JohanLink/Ball-Balancing-PID-System/README.md

# Ball-Balancing-PID-System

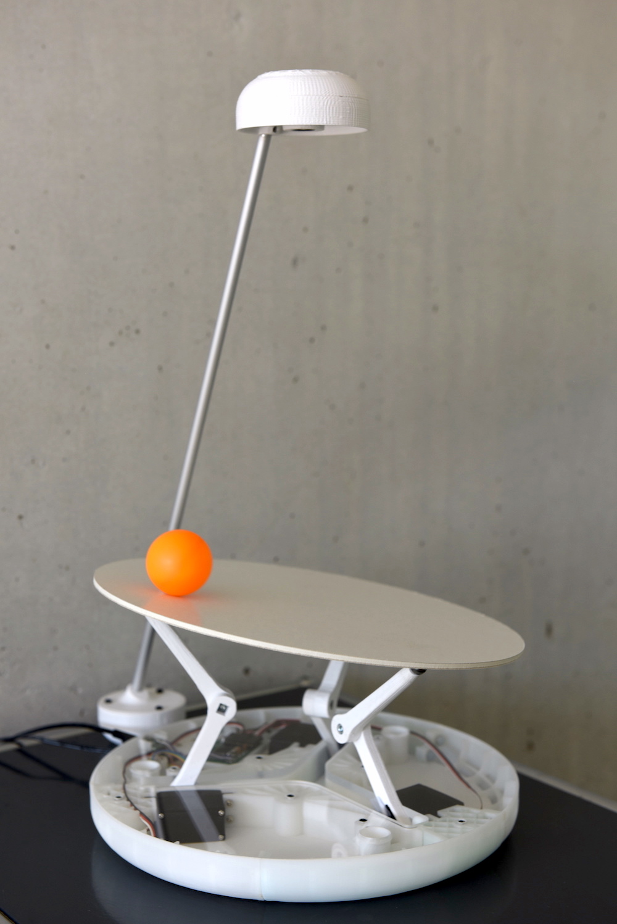
[picture p1: images/DSC_4337.JPG]


license : https://creativecommons.org/licenses/by-nc-sa/4.0/
