JohanLink/Ball-Balancing-PID-System/TM_SJF_version.pdf

Gymnase de Burier

Johan Link

3M5

# Système de stabilisation PID

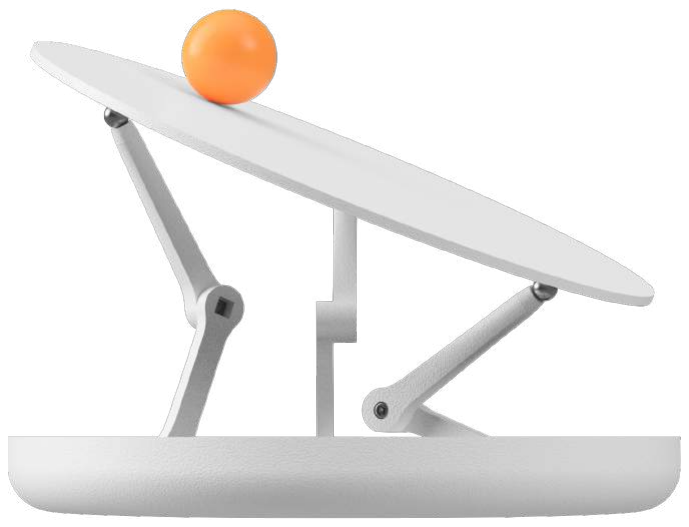
[picture p2: figure]

La Tour-de-Peilz, le 13 février 2020 | Maître répondant : Alain Salanon

## Résumé du travail de maturité

Ce travail consiste en la réalisation d’un système permettant de faire tenir une balle en équilibre sur un plateau qui a la possibilité de s’incliner sur deux axes pour annuler les mouvements de la balle. En d’autres termes, si on lance une balle sur ce plateau, ce dernier s’inclinera pour l’empêcher de tomber et il positionnera la balle en son centre.

Partie matérielle

Le système est composé de deux parties bien distinctes : une base qui contient trois moteurs avec leurs bras sur lesquels se trouve le plateau et un support qui maintient une caméra au-dessus du plateau. La base qui contient les moteurs est une structure en plastique de forme circulaire et de même dimension que le plateau. Cette structure est composée de plusieurs pièces en plastique qui ont été modélisées dans un logiciel puis fabriquées à l’aide d’une imprimante 3D.

Circuit électronique

La base qui contient les moteurs comprend également un circuit imprimé qui permet de contrôler les moteurs et de communiquer avec un ordinateur. J’ai conçu ce circuit spécialement pour ce projet. Je l’ai dessiné à l’aide d’un logiciel, puis il a été fabriqué en Chine. Le circuit contient un microcontrôleur similaire à celui de certaines cartes Arduino, par conséquent j’ai pu programmer mon propre circuit électronique à l’aide de l’environnement Arduino.

Programmation de l’ensemble

Le système fonctionne en trois temps : premièrement, la caméra prend une photo du plateau et de la balle et la transmet à un ordinateur, ensuite un programme Python analyse l’image pour détecter la position et la vitesse de la balle et en déduit que le plateau doit s’incliner d’un certain angle pour annuler les mouvements de la balle. Pour finir, le circuit imprimé fait bouger les moteurs en fonction des informations reçues par l’ordinateur. Le programme Python est la partie la plus importante du système car il traite les images reçues par la caméra, les analyse, puis en déduit à l’aide d’un régulateur PID l’inclinaison qu’il faut donner au plateau.

Utilisation d’un régulateur PID

Le régulateur PID est un système permettant de contrôler la position de la balle. En prenant en compte plusieurs facteurs comme la position et la vitesse de la balle, on peut connaître avec précision l’inclinaison qu’il faut donner au plateau pour que la balle se stabilise à une position voulue.

## Remerciements

Je souhaite remercier M. Salanon de m’avoir suivi tout au long de ce TM et pour la relecture de mon travail. Je remercie également M. Bonnet pour m’avoir guidé dans l’amélioration de ce travail.

## Table des matières

1 Introduction | 5
2 Etat de l’art : robotique parallèle | 7
3 Conception de la partie mécanique | 10
4 Résolution des équations à l’aide de Python | 18
5 Conception du circuit imprimé | 21
6 Fonctionnement d’un régulateur PID | 26
7 Mise en place du régulateur PID dans le programme Python | 29

2

8 Utilisation de OpenCV avec Python | 35
9 L’interface graphique | 37
10 Le code Arduino | 39

### 11 Analyse des performances du système selon les coefficients P, I

et D | 40

11.3 Dernière expérience : analyse des coefficients P et D lorsque la

12 Discussion des trois expériences | 51
13 Faiblesses du système | 53
13.4 Effet néfaste de la rotation du plateau sur la vitesse de la balle . | 57
14 Conclusion | 58
Bibliographie | 59

3

Annexes | 62

4

## 1 Introduction

### 1.1 Motivations

L’électronique, la programmation et l’informatique de façon générale sont des domaines qui m’intéressent depuis longtemps, c’est pourquoi j’ai souhaité réaliser un travail de maturité rassemblant toutes ces disciplines afin d’approfondir mes connaissances. J’ai toujours voulu savoir comment les objets ou les machines qui nous entourent fonctionnent c’est pourquoi j’ai l’habitude d’en démonter pour mieux comprendre leur mécanisme. J’ai commencé à m’intéresser à l’électronique il y a de nombreuses années, j’ai commencé par la fabrication de simples circuits électriques puis, plus tard, je me suis également intéressé à la programmation. Il y a quelques années j’ai découvert l’existence des cartes Arduino qui m’ont permis de réaliser des projets de plus en plus intéressants en me permettant de travailler à la fois du côté logiciel et matériel. Les cartes Arduino s’utilisent de manière très intuitive et sont entièrement open-source, de plus une énorme quantité de documentation est présente sur internet. Ce travail de maturité est donc l’occasion de faire un projet concret qui contient une partie hardware et une partie software.

### 1.2 Présentation du projet

Mon projet consiste en la réalisation d’un système permettant de faire tenir en équilibre une balle sur un plateau. Des servomoteurs permettront au plateau de s’orienter avec un certain angle d’inclinaison pour contrebalancer les mouvements de la bille. Une caméra placée au-dessus du dispositif transmettra en direct des images du plateau à un ordinateur qui sera chargé de les analyser pour en tirer des conclusions telles que la position de la bille, sa vitesse et son accélération. Un programme informatique sera alors chargé de traiter ces données et de les transmettre par USB à l’Arduino qui contrôlera la rotation de chaque servomoteur indépendamment. Le plateau bougera en conséquence des déplacements de la bille, même si cette dernière est déstabilisée par du vent ou une force quelconque, l’Arduino inclinera le plateau pour qu’elle ne tombe jamais.
Ce projet me permettra de concevoir un système contenant une partie mécanique et électronique, je serai également mené à coder un programme capable de traiter des images et d’en déduire la position d’un objet d’une couleur définie. Dans un premier temps je vais construire et étudier les différents mécanismes qui permettront de faire bouger le plateau. Ensuite je devrai dessiner et fabriquer un circuit électronique contenant un microcontrôleur capable de communiquer avec l’ordinateur et capable de diriger les servomoteurs. Je finirai mon travail par la réalisation du programme qui traitera les images de la caméra et qui en déduira l’inclinaison du plateau nécessaire à l’équilibre de la bille.

5

### 1.3 Les cartes Arduino

Les cartes Arduino sont de petites cartes électroniques qui sont principalement composées d’un microcontrôleur autour duquel se trouve de nombreuses entrées et sorties qui permettent à la carte d’interagir avec différents composants électroniques ou quelconques systèmes extérieurs à la carte. Plusieurs modèles de cartes existent, la différence majeure qui les sépare est la puissance du microcontrôleur. Par exemple un microcontrôleur contenu dans un Arduino Mega contiendra une EEPROM d’une capacité de 4 kB alors qu’un Arduino Uno aura une EEPROM limitée à 1 kB. De plus les cartes plus puissantes ont également plus d’entrées et de sorties.
L’Arduino a été fondé en 2005 par un étudiant Italien, par la suite ce simple projet d’étudiant a révolutionné l’univers de l’électronique. Ces cartes permettent à n’importe quelle personne de concevoir un projet à moindre coût. Un Arduino Uno coûte environ 20 euros ce qui rend ces cartes accessibles. Mais l’avantage d’utiliser ces cartes open-source est d’avoir accès à une immense communauté de personnes publiant des tutoriels ou différents projets sur internet. De plus, Arduino fournit également un logiciel de programmation gratuit qui permet de programmer très simplement n’importe quelles cartes Arduino ou d’autres cartes avec un microcontrôleur similaire. En effet le logiciel Arduino peut également servir à programmer une carte d’une autre marque qu’Arduino ou encore une carte fabriquée par soi-même. C’est un exemple d’un des nombreux avantages que les logiciels open-source offrent.

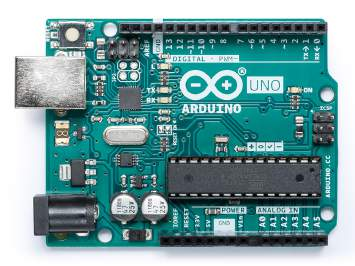
[picture p3: figure]

Figure 1 – Photo d’un Arduino Uno Source : https ://store.arduino.cc/arduino-uno-rev3

6

## 2 Etat de l’art : robotique parallèle

Un des éléments essentiel à mon travail de maturité est de trouver un moyen de manipuler une plateforme dans l’espace pour lui donner une orientation recherchée. Différents types de robots répondent déjà à des besoins proche de celui-ci mais ne sont pas toujours parfaitement adaptés à mon projet. Ces derniers font partie de la robotique parallèle : mécanisme en chaîne cinématique fermée dont l’organe terminal est relié à la base par plusieurs chaînes cinématiques indépendantes. ¹
La robotique parallèle à permis de créer des systèmes mécanique plus performant dans certaines applications que les robots sériels inventé plus tôt.

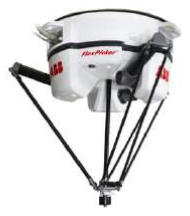
[picture p4: figure]
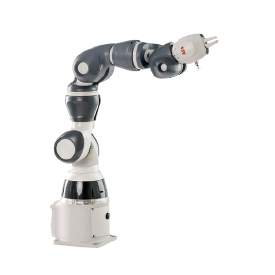
[picture p5: figure]

(a) Robot sériel | (b) Robot parallèle

Figure 2 – Comparaison entre un robot sériel et parallèle

### 2.1 Robot Delta

Inventé en 1985 par l’ingénieur Reymond Clavel à l’EPFL, le robot Delta (la figure 2b présente un exemple de robot delta) a révolutionné l’industrie. En effet ce système comporte un grand nombre d’avantages en comparaison avec les robots sériels, sa géométrie lui donne une grande rigidité tout en utilisant des matériaux légers et fins. Cette géométrie permet également des déplacements très rapides et précis. En général ce système comporte 3 degrés de liberté ce qui lui permet de soulever des objets pour les translater par exemple. Ces mouvements sont particulièrement adaptés à l’industrie où il faut souvent déplacer les objets fabriqués pour les ranger dans des boites par exemple. Par conséquent,

1. Définition de Jean-Pierre Merlet, Les Robots Parallèles, Paris, Hermes Science Publishing, 21 février 1997, 367 p. (ISBN 978-2866015992)
Source | de | la | figure | 2b | : | https | ://new.abb.com/products/robotics/fr/robots-
industriels/irb-360-flexpicker
Source de la figure 2a : https ://new.abb.com/products/robotics/de/industrieroboter/SAY

7

dans les robots delta, la plateforme mouvante se déplace toujours de manière parallèle à la plateforme sur laquelle les moteurs sont fixés (voir figure 3b).

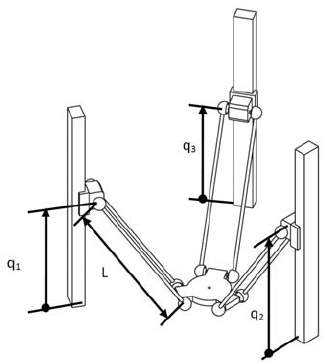
[picture p6: figure]
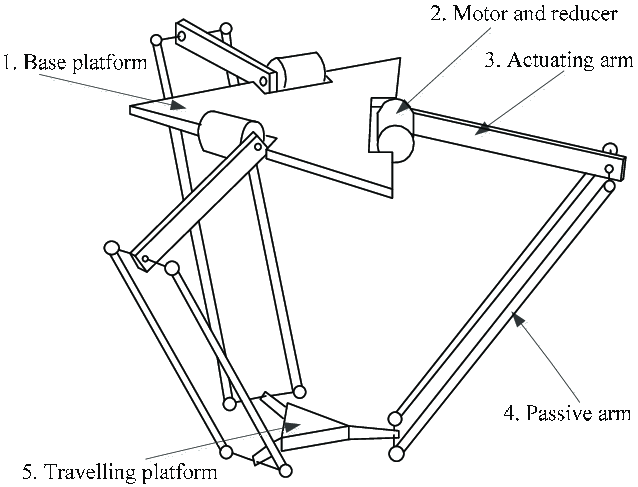
[picture p7: figure]

(a) Robot delta à actionneurs linéaires | (b) Robot delta à actionneurs rotatifs

Figure 3 – Comparaison entre des actionneurs linéaires et rotatifs dans un robot delta

Le robot delta est souvent muni d’actionneurs rotatifs, un des désavantages de ce système est que la plateforme mouvante du système ne peut pas se déplacer dans un très grand espace de travail. Cela ne pose aucun problème lorsque le robot doit juste déplacer de petits objets d’un tapis roulants à l’autre dans une usine par exemple. Cependant il faut parfois un système capable d’évoluer dans un plus grand espace de travail, on peut alors fixer les bras du robot delta directement sur des actionneurs linéaires (voir figure 3a). Ce système est parfois utilisé dans les imprimante 3D car il permet d’augmenter l’espace de travail du robot ce qui permet d’imprimer des pièces de grande taille.

### 2.2 Plateforme de Stewart

La plateforme de Stewart, inventée en 1965, est également un système qui fait partie de la robotique parallèle. Ce système était destiné à améliorer le réalisme des simulateurs de vols. Le mécanisme est composé d’une plateforme fixée sur six vérins par des articulations mobiles. Les vérins sont indépendants les uns des autres et servent à orienter la plateforme. Cette dernière dispose de six degrés de liberté (les trois coordonnées de translation et les angles de tangage, roulement et lacet). Fonctionnant avec six vérins, le système à la capacité de faire bouger des charges très lourdes cependant les vérins ont le désavantage d’être en général relativement lent. Il existe cependant des versions de la plateforme de

Source de la figure 3a : https ://www.researchgate.net/figure/DELTA-parallel-robot-withlinear-actuators_fig2_4356741
Source de la figure 3b : https ://www.researchgate.net/figure/Scheme-of-the-Deltarobot_fig3_303469087

8

Stewart utilisant des actionneurs rotatifs ce qui permet d’augmenter la vitesse des mouvements.

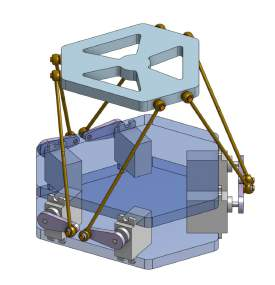
[picture p8: figure]

(a) Plateforme de Stewart à actionneurs rotatifs

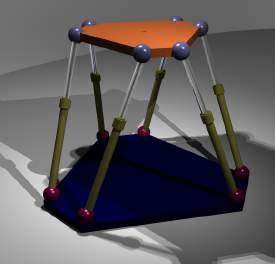
[picture p9: figure]

(b) Plateforme de Stewart à actionneurs linéaires

Figure 4 – Exemples de plateforme de Stewart

### 2.3 Conclusion

La robotique parallèle semble être une bonne solution pour ce travail de maturité, en effet nous avons vu que ce type de robotique permet de créer des mécanismes dont la géométrie comporte de nombreux avantages. La plateforme de Stewart et le robot delta permettent tous les deux de déplacer une plateforme avec précision et à grande vitesse. Les pièces mécaniques utilisées étant relativement simples et légères, elles n’ont pas une grande inertie ce qui permet de leur faire subir de grandes accélérations sans problèmes. Malgré les avantages vus précédemment, ces systèmes ne sont pas parfaitement adaptés pour satisfaire les exigences de ce travail. Effectivement il est question d’orienter un plateau selon les angles de roulis et de tangage, or un robot delta permet uniquement de translater sa plateforme dans l’espace sans pouvoir lui faire subir des rotations. Quant à elle, la plateforme de Stewart permet à sa plateforme de se translater dans l’espace mais également de subir des rotations selon les angles de roulis, tangage et lacet. Par conséquent la plateforme de Stewart remplis les exigences de roulis et tangage mais offre également beaucoup d’autres degrés de liberté qui ne sont pas nécessaires dans l’élaboration de ce travail. Il faudra alors trouver un moyen de simplifier la géométrie d’une plateforme de Stewart tout en prenant soins de rester dans la robotique parallèle pour conserver ses propriétés mécaniques intéressantes.

Source de la figure 4a : https ://github.com/NicHub/stewart-platform-esp32 Source de la figure 4b : https ://fr.m.wikipedia.org/wiki/Robot_parallèle

9

## 3 Conception de la partie mécanique

### 3.1 Fonctionnement général du système mécanique

Le plateau sur lequel reposera la bille devra être capable de s’orienter sur deux axes et devra pouvoir s’incliner de 35◦ au maximum. Étant donné que la plate-forme doit se mouvoir sur deux axes j’ai rapidement commencé à réfléchir à un système comportant deux moteurs. Cependant, après réflexion je me suis rendu compte qu’il était plus simple d’utiliser trois moteurs (fig.5). L’ajout d’un moteur permet également de rajouter un degré de liberté au plateau, en effet avec trois moteurs la plate-forme peut s’incliner sur deux axes et peut également bouger de façon verticale, mais ce degré de liberté ne sera pas utilisé dans ce projet. À présent nous savons que le système comprendra trois moteurs placés à 120◦
l’un de l’autre et que le mouvement de rotation de ces derniers devra entraîner l’inclinaison du plateau. Pour ce faire, chaque moteur mettra en rotation un bras qui sera composé de deux parties reliées entre elles par une articulation (fig.6). Une bille métallique sera fixée à l’extrémité du bras de chaque moteur et cette bille fera office de rotule entre le bout du bras et le plateau situé en dessus.

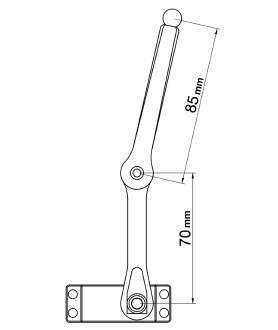
[picture p10: figure]
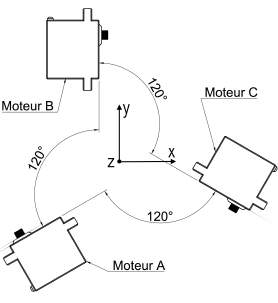
[picture p11: figure]

Figure 5 – Disposition des moteurs | Figure 6 – Bras d’un moteur

### 3.2 Conceptualisation géométrique du problème

Comme dit précédemment, le dispositif comporte trois moteurs, il faut donc trouver un moyen de connaître l’angle du bras de chaque moteur en fonction d’une inclinaison donnée du plateau. Les moteurs ont une position fixe, chaque bras se déplace dans un plan vertical et la distance entre le bout de chaque bras est constante. Dans un premier temps j’ai commencé à réaliser différents calculs permettant de mettre en relation les différentes contraintes du problème. J’ai

10 également établi un système permettant de définir la position du plateau en fonction de deux angles. Pour ce faire j’ai ajouté dans mes calculs un vecteur ~v (fig.7) de norme 1 qui est toujours perpendiculaire au plateau et dont l’origine correspond au centre du plateau. L’orientation de ce vecteur est défini par les angles α et β.

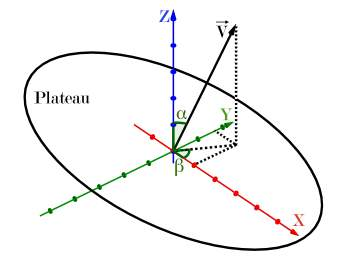
[picture p12: figure]

Figure 7 – Vecteur ~v perpendiculaire au plateau

Après avoir réalisé plusieurs calculs ²
j’ai pu établir des équations qui permettent de déterminer la position de chaque bille située sur le bout des bras en fonction d’une inclinaison connue du plateau. Après avoir trouvé la position dans l’espace d’une bille on doit encore trouver l’angle du moteur qui permet de positionner le bout du bras avec la bille au bon endroit. L’équation ³ suivante
permet de calculer l’angle θ que le bras doit avoir par rapport à l’horizontale :

(L − r cos θ −

p
X² + Y ²)

2 + (r sin θ − Z)

2 = l

2
(1)

où L est la distance entre l’arbre d’un moteur et l’origine (fig.5), r est la longueur de la première portion du bras de chaque moteur et l est la longueur du deuxième segment du bras (segment sur lequel est attaché la bille). X,Y et Z sont les coordonnées ⁴ de la bille qui ont été calculées précédemment. L’équation (1) doit donc être utilisée individuellement pour chaque moteur, en d’autres termes on calcule d’abord la position de la bille du bras du moteur A et on utilise l’équation (1) pour déterminer l’angle du moteur A, ensuite on refait les mêmes calculs pour les moteurs B et C.

### 3.3 Choix des moteurs

Comme vu précédemment, trois bras composés de deux parties chacun devront maintenir et faire bouger le plateau situé en dessus d’eux. Il est donc

2. Ces calculs sont décrits aux pages 94 et 95.
3. L’équation 1 est décrite plus précisément à la page 96.
4. Le repère orthonormé de ces coordonnées se trouve sur le plan qui contient les trois moteurs et se trouve à équidistance de ces derniers. (figure 5, page 10)

11 évident qu’il est nécessaire d’avoir des moteurs pour mettre en mouvement chaque bras. Cependant mon projet contient plusieurs contraintes qu’il faut prendre en compte pour le choix des moteurs. Premièrement, la masse du plateau repose entièrement sur les moteurs, ils doivent alors être relativement puissants pour le soulever et le maintenir dans une certaine position. Deuxièmement, les moteurs doivent pouvoir incliner le plateau rapidement pour compenser les déplacements parfois rapides de la bille. Troisièmement, il faut que les moteurs soient précis pour que le système fonctionne correctement.
Il existe énormément de types de moteurs différents, cependant je me suis intéressé à deux types de moteurs en particulier : les moteurs pas-à-pas et les servomoteurs. Les servomoteurs sont rapides, puissants et assez précis, ils peuvent cependant effectuer des rotations de seulement 180◦ ou 360◦ au maximum mais cela n’est pas un problème pour ce projet. Ils sont très pratiques car ils sont relativement petits et sont très faciles à utiliser avec un Arduino. Je me suis également intéressé aux moteurs pas-à-pas car ils sont plus précis que les servomoteurs, cependant ils comportent quelques désavantages, par exemple, il faut utiliser des drivers ⁵ pour les faire fonctionner avec un Arduino.
J’ai finalement décidé d’utiliser des servomoteurs ⁶
(voir figure 8) pour ce projet car ils sont plus simples à utiliser et ont l’avantage de pouvoir maintenir leur position même si une force extérieure est exercée sur l’arbre du moteur. En effet les servomoteurs contiennent un circuit électronique qui régule la position du moteur, par conséquent ces moteurs réajustent leur position en continu et de manière automatique.

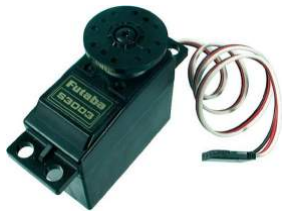
[picture p13: figure]

Figure 8 – Photo d’un servomoteur utilisé pour ce projet

### 3.4 Conception du design du système

Cette partie consiste en la conception de l’armature qui devra maintenir les différents éléments tels que les servomoteurs, le circuit imprimé ou encore les divers connecteurs (connecteur pour l’alimentation, port USB et connecteur

5. Petits circuits électroniques contrôlant la rotation des moteurs pas-à-pas.
6. Référence des servomoteurs utilisés : 05101748-1
Source de la figure 8 : https ://www.digitec.ch/fr/s1/product/futaba-servo-servos-rc-5335020

12 pour un joystick). J’ai commencé par modéliser les différentes pièces dans le logiciel Fusion 360. Le plateau a un diamètre de 27 cm, par conséquent le socle qui contient les moteurs fait également ce diamètre. La majorité des pièces vont être imprimées en 3D par la suite, malheureusement la majorité des imprimantes 3D ne sont pas capables d’imprimer des pièces aussi grandes, c’est pourquoi j’ai dû diviser plusieurs pièces en plusieurs petites pièces qui peuvent s’assembler à l’aide de boulons et d’écrous.

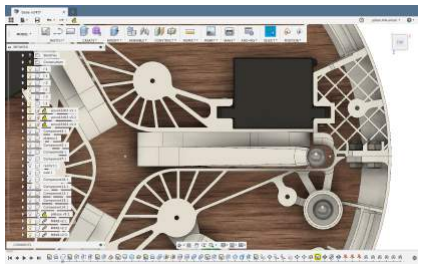
[picture p14: figure]

Figure 9 – Capture d’écran de mon projet dans Fusion 360

La figure (fig.10, page 14) permet de se rendre compte de toutes les différentes pièces qui composent le système. On aperçoit également trois disques, le disque se trouvant tout en haut correspond au plateau sur lequel roulera la bille, les deux autres disques forment respectivement le haut et le bas du boitier qui contient les moteurs, le circuit électronique et les autres composants. Les pièces imprimées en 3D forment le pourtour du boitier et certaines sont également présentes à l’intérieur et servent de support aux moteurs et au circuit.

13

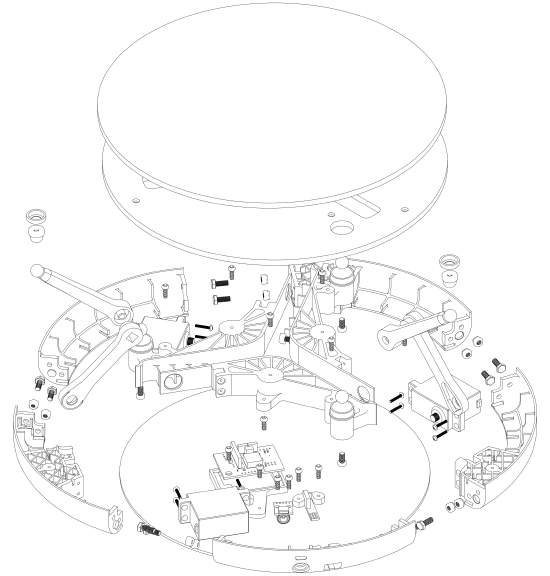
[picture p15: figure]

Figure 10 – Vue générale de tous les éléments du système

### 3.5 Fabrication des différents éléments

Étant donné que le système comprend un grand nombre de grands éléments à imprimer en 3D, j’ai décidé de faire appel au site 3D Hubs. Il m’a suffi de télécharger tous les fichiers de mes pièces sur leur site, puis ils se sont occupés d’imprimer les différents éléments et de les envoyer. De plus, les pièces que j’ai dessinées sont relativement complexes, il fallait donc une imprimante 3D qui dispose d’une grande précision pour pouvoir les fabriquer. Les pièces ont toutes été imprimées en ABS (acrylonitrile butadiène styrène). L’ABS est un plastique très courant dans l’industrie, il est souvent utilisé dans les appareils électroménagers ou encore dans les jouets comme par exemple les briques LEGO. Ce plastique comporte des caractéristiques intéressantes car il est plutôt léger et est très résistant aux chocs. Un de ses plus grands défauts est d’avoir tendance à jaunir lorsqu’il est exposé à la lumière du soleil.
Les trois disques que l’on voit sur la figure 10 (page 14) ont été fabriqué par l’ Atelier 12Mill ⁷
. Il s’agit d’un atelier, basé à Lausanne, qui permet de faire fa-
7. Adresse : Avenue de Sévelin 48 - 1004 Lausanne

14 briquer toutes sortes de pièces avec des techniques différentes. Deux des disques que j’ai fait fabriquer ont été fraisés dans une plaque en acrylique transparent. L’un de ces deux disques a été peint en blanc. Le troisième disque est le plateau sur lequel repose la bille, il a été fabriqué en carton car il fallait un matériau léger pour que le plateau n’ait pas trop d’inertie. Après avoir testé un plateau en bois, je me suis rendu compte qu’un plateau avec trop d’inertie avait tendance, lors de mouvements brusque, à se décrocher des bras magnétiques qui le supportent.

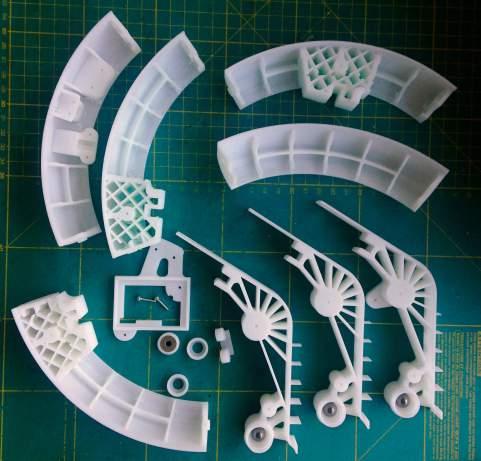
[picture p16: figure]

Figure 11 – Pièces imprimées en 3D

15

### 3.6 Assemblages du système

La dernière étape de la construction consiste en l’assemblage de toutes les pièces du système. Tous les éléments s’emboitent et sont maintenus entre eux par des boulons et des écrous. Cette étape est relativement simple si les pièces ont été correctement dessinées au préalable. Dans mon cas l’assemblage s’est déroulé convenablement, bien que certaines pièces comportaient des défauts qui étaient dus à l’impression 3D. Ces petits défauts ont causé des désalignements, mais heureusement il est assez facile de modifier les pièces à l’aide d’un simple cutter.

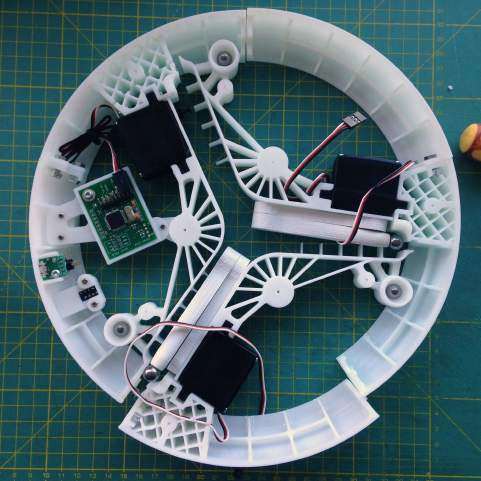
[picture p17: figure]

Figure 12 – Début de l’assemblage des pièces

### 3.7 Fabrication du support et du boitier de la caméra

La caméra qui doit filmer le plateau est placé sur un support qui est complètement séparé de la base qui contient les servomoteurs. Le boitier de la caméra est monté sur un tube en aluminium qui lui-même est emboité à un support qui contient trois aimants qui permettent à ce support de se fixer sur des surfaces métalliques. Le boitier de la caméra ainsi que le support ont été imprimés en 3D. Le câble USB de la caméra passe à l’intérieur du tube en aluminium et sort à l’arrière du support aimanté.

16

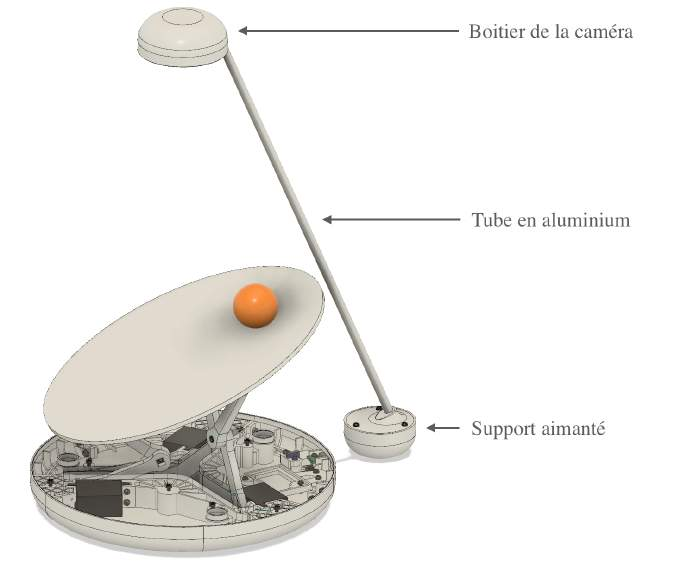
[picture p18: figure]

Figure 13 – Capture d’écran du support de la caméra dans Fusion 360

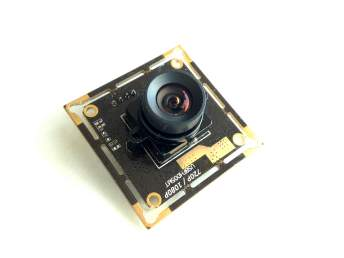
[picture p19: figure]

Figure 14 – Caméra utilisée pour ce projet référence : ELP-USBFHD01M

17

## 4 Résolution des équations à l’aide de Python

### 4.1 Rôle de ce programme

Les équations présentées dans la partie 3.2 de la page 10 sont particulièrement longues et complexes, il est donc très difficile de les manipuler pour en isoler une variable par exemple. Ces équations sont trop compliquées pour être résolues sans l’aide d’un ordinateur, c’est pourquoi j’ai décidé d’écrire un programme python permettant de résoudre les équations. Le programme génère un fichier texte qui contient les résultats de toutes les équations que le programme à résolues pour obtenir l’angle de chaque moteur en fonction des angles α et β qui définissent l’inclinaison du plateau.

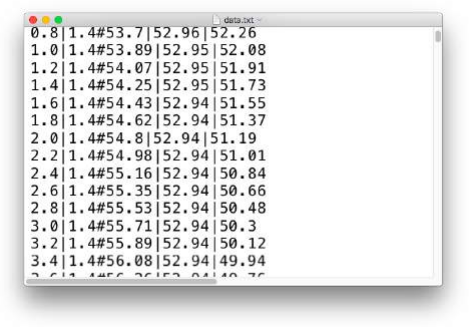
[picture p20: figure]

Figure 15 – Capture d’écran du fichier texte

Chacune des lignes comporte les informations
suivantes : α | β # θA | θB | θC

### 4.2 Fonctionnement du programme

Ce programme génère un fichier texte en résolvant plusieurs systèmes d’équations, pour ce faire il est nécessaire de fixer certaines constantes au début du code. Voici la liste des différentes valeurs qu’il faut rentrer dans le programme pour qu’il puisse fonctionner :

— Distance entre l’arbre d’un moteur et le centre de la base ⁸
: L = 8.5cm
— Hauteur du plateau par rapport à la base : d = 11.5cm
— Distance entre l’extrémité de chaque bras : D = 18cm
— Longueur du premier segment de chaque bras : r = 7cm
8. La base correspond au socle sur lequel sont fixés tous les moteurs.

18

— Longueur du deuxième segment de chaque bras : l = 8.5cm

Le programme doit à présent effectuer plusieurs systèmes d’équations, j’ai donc décidé d’utiliser la fonction fsolve issue du module scipy.optimize. Cette fonction permet de résoudre des systèmes d’équations en utilisant une méthode de résolution approchée, par conséquent les solutions ne seront pas exactes mais sont suffisamment précises pour ce projet.

1 | d e f equationsKMT ( p ) :
2 | k , m, t = p
3 | e q u a ti o n 1 = (−c o s ( alph a ) ∗ c o s ( pi / 6 ) ∗k ) ∗∗2 + (−c o s ( alph a ) ∗m−c o s (
| alph a ) ∗ s i n ( pi / 6 ) ∗k ) ∗∗2 + ( s i n ( be t a ) ∗ s i n ( alph a ) ∗m+c o s ( pi / 6 ) ∗
| c o s ( be t a ) ∗ s i n ( alph a ) ∗k+s i n ( be t a ) ∗ s i n ( alph a ) ∗ s i n ( pi / 6 ) ∗k ) ∗∗2
| − 1
4 | e q u a ti o n 2 = (−c o s ( alph a ) ∗ c o s ( pi / 6 ) ∗ t ) ∗∗2 + ( c o s ( alph a ) ∗ s i n ( pi
| / 6 ) ∗ t+c o s ( alph a ) ∗m) ∗∗2 + ( c o s ( be t a ) ∗ s i n ( alph a ) ∗ c o s ( pi / 6 ) ∗t−
| s i n ( be t a ) ∗ s i n ( alph a ) ∗ s i n ( pi / 6 ) ∗t−s i n ( be t a ) ∗ s i n ( alph a ) ∗m) ∗∗2
| − 1
5 | e q u a ti o n 3 = ( c o s ( alph a ) ∗ c o s ( pi / 6 ) ∗k+c o s ( alph a ) ∗ c o s ( pi / 6 ) ∗ t ) ∗∗2
| + ( c o s ( alph a ) ∗ s i n ( pi / 6 ) ∗k−c o s ( alph a ) ∗ s i n ( pi / 6 ) ∗ t ) ∗∗2 + (−
| c o s ( pi / 6 ) ∗ c o s ( be t a ) ∗ s i n ( alph a ) ∗k−s i n ( be t a ) ∗ s i n ( alph a ) ∗ s i n (
| pi / 6 ) ∗k−c o s ( be t a ) ∗ s i n ( alph a ) ∗ c o s ( pi / 6 ) ∗ t+s i n ( be t a ) ∗ s i n (
| alph a ) ∗ s i n ( pi / 6 ) ∗ t ) ∗∗2 − 1
6 | r e t u r n ( equ a ti on 1 , equ a ti on 2 , e q u a ti o n 3 )
Ci-dessus se trouve une fonction qui contient un système d’équations ⁹ à trois inconnues. Dans la suite du code la commande fsolve(equationsKMT, (1, 1, 1)) est utilisée pour déterminer la valeur des variables ¹⁰ k, m et t.
La partie la plus importante de ce code est une boucle dans laquelle le programme va résoudre les systèmes d’équations plusieurs fois en faisant varier les angles α et β. L’angle α varie entre 0
| ◦

et 35◦ par pas de 0.2

| ◦
et β varie entre
0
| ◦

et 360◦ par pas de 0.2

| ◦
également.
1 | f o r be t a i n r an ge ( 0 , 360∗5+1) :
2 | be t a = r a di a n s ( be t a ) /5
3 | f o r alph a i n r an ge ( 0 , 35∗5+1) :
4 | alph a = r a di a n s ( alph a ) /5
5 | k ,m, t = f s o l v e ( equationsKMT , ( 1 , 1 , 1 ) )
6 | k ,m, t = −D∗k , −D∗m, −D∗ t
7 | Xa, Ya, Za = k∗ c o s ( alph a ) ∗ c o s ( pi / 6 ) , k∗ c o s ( alph a ) ∗ s i n ( pi / 6 )
| , k∗(− c o s ( pi / 6 ) ∗ c o s ( be t a ) ∗ s i n ( alph a )−s i n ( be t a ) ∗ s i n (
| alph a ) ∗ s i n ( pi / 6 ) )+d
8 | Xb, Yb, Zb = 0 , m∗(− c o s ( alph a ) ) , m∗ s i n ( be t a ) ∗ s i n ( alph a )+d
9 | Xc , Yc , Zc = t ∗(− c o s ( alph a ) ∗ c o s ( pi / 6 ) ) , t ∗ c o s ( alph a ) ∗ s i n ( pi
| / 6 ) , t ∗( c o s ( be t a ) ∗ s i n ( alph a ) ∗ c o s ( pi / 6 )−s i n ( be t a ) ∗ s i n (
| alph a ) ∗ s i n ( pi / 6 ) )+d
10 | tetaA = d e g r e e s ( f s o l v e ( equa tionTe ta , 1 , a r g s =(Xa, Ya, Za ) ) )
11 | tetaB = d e g r e e s ( f s o l v e ( equa tionTe ta , 1 , a r g s =(Xb, Yb, Zb ) ) )
12 | tetaC = d e g r e e s ( f s o l v e ( equa tionTe ta , 1 , a r g s =(Xc , Yc , Zc ) ) )
13 | tetaA = round ( tetaA , 2 )
9. Ce système d’équations est présenté à la page 95.
10. Les variables k, m et t permettent de calculer la position du bout de chaque bras.

19

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

Le fichier texte produit par ce programme sera utilisé plus tard par le programme Python interface.py qui s’occupera du traitement des images et de la communication avec le circuit imprimé.

20

## 5 Conception du circuit imprimé

### 5.1 Pourquoi réaliser un circuit imprimé ?

Les cartes Arduino sont très pratiques pour réaliser rapidement des prototypes de circuits électroniques. Cependant lorsqu’on utilise ces cartes on se retrouve souvent avec des dizaines de câbles reliant l’Arduino à une platine d’expérimentation ¹¹ qui est souvent elle-même reliée à d’autres composants comme par exemple des servomoteurs. Cela n’est pas un problème lorsqu’on travaille sur un prototype ou lorsqu’on veut tester des circuits, mais si on souhaite fabriquer un système plus fiable et moins encombrant il est préférable de réaliser un circuit imprimé.

### 5.2 Cahier des charges

C’est souvent très utile de fabriquer un circuit imprimé mais il faut garder en tête qu’il est très difficile de modifier le circuit de ce dernier après l’avoir fabriqué. C’est pourquoi il faut bien réfléchir aux différents composants et fonctions du circuit avant de le faire fabriquer. Le but de cette étape est de dresser une liste des différentes actions que le circuit sera capable d’effectuer. Le circuit dont j’ai besoin pour mon projet est très simple et contient relativement peu de composants, voici la liste des différents éléments qui seront présents dans le futur circuit :

— 1 microcontrôleur ATMEGA32U4-AU
— 1 oscillateur quartz d’une fréquence de 16MHz — 2 condensateurs céramique de 22pf
— 1 Une diode électroluminescente (led)
— 1 Une résistance de 1kΩ
— 1 Une résistance de 10kΩ
— 2 Une résistance de 22Ω
— 1 condensateur de 0.1µf
— 1 condensateur de 1µf
— 1 condensateur de 10µf
— 3 sorties PWM pour le contrôle des servomoteurs
— 1 entrée pour une alimentation 5 volts destinée aux servomoteurs — 4 pins destiné à être reliés à un port micro USB
— 4 pins destiné à l’utilisation d’un joystick ¹² utilisant l’interface I2C

### 5.3 Qu’est ce qu’un microcontrôleur ?

Un microcontrôleur se présente sous la forme d’une puce électronique qui contient tous les éléments essentiels au bon fonctionnement d’un ordinateur. En

11. Plus connue sous le nom de "breadboard" en anglais.
12. Pour des raisons techniques, le joystick ne sera finalement pas utilisé dans la suite du projet.

21 effet on y retrouve les composants suivants : un microprocesseur, une mémoire RAM ¹³, une mémoire EEPROM ¹⁴, une mémoire Flash ¹⁵, plusieurs entrées / sorties et un oscillateur.

### 5.4 Choix du microcontrôleur

Comme présenté dans la partie 5.2, le circuit imprimé sera équipé d’un microcontrôleur ATMEGA32U4-AU. Cette puce est exactement la même qui est utilisée dans les Arduino Leonardo. Son avantage premier est d’avoir la capacité de gérer la communication USB sans l’aide d’un autre processeur. Cela permet de simplifier la conception du circuit imprimé tout en réduisant les coûts car moins de composants sont utilisés.

### 5.5 Conception du PCB

Pour concevoir le circuit imprimé de ce projet j’ai utilisé le logiciel EAGLE qui est un logiciel de conception assistée par ordinateur. La création du circuit s’est déroulé en deux étapes, j’ai commencé par la réalisation du schéma électronique(fig.16), puis j’ai réalisé le routage du circuit(fig.17). Le routage consiste à positionner les différents composants du circuit et à définir les passages par lesquels les connexions vont passer.

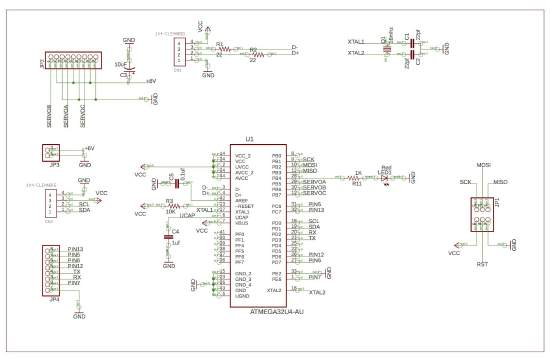
[picture p21: figure]

Figure 16 – Schéma du circuit imprimé

13. La RAM est une mémoire rapide mais qui stocke les informations de manière provisoire.
14. L’EEPROM est une mémoire non volatile.
15. La mémoire Flash des microcontrôleurs sert à stocker le programme que l’on a téléchargé.

22

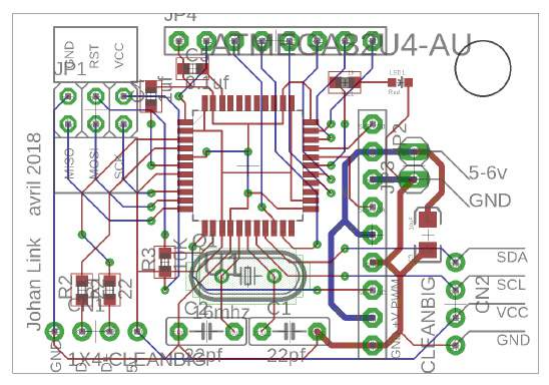
[picture p22: figure]

Figure 17 – Circuit imprimé

### 5.6 Fabrication du PCB

Après avoir réalisé le circuit sur le logiciel EAGLE il faut le fabriquer. Pour ce faire j’ai utilisé le site https://www.pcbway.com qui est un fabricant de circuits imprimés situé à Shenzhen en Chine. Ce site est particulièrement connu pour son rapport qualité-prix. L’utilisation de ce site est très simple, il suffit d’importer les fichiers Gerber ¹⁶ de son circuit sur le site et de choisir certains paramètres tels que la couleur du circuit ou encore son épaisseur, ensuite la fabrication se déroule sur quelques jours et le circuit est envoyé à sa destination.

### 5.7 Assemblage des composants

Après avoir reçu le circuit imprimé il faut encore y souder tous les composants. Cette partie est particulièrement compliquée car les pièces utilisées sont très petites ¹⁷ et donc difficiles à souder. Malheureusement certains composants tels que le microcontrôleur ne sont disponibles que dans des formats très petits. Je ne suis pas équipé avec les bons outils pour souder ce type de composants, cependant j’ai tout de même réussi à souder le microcontrôleur et les autres composants à l’aide d’un fer à souder standard. J’ai également fabriqué une panne ¹⁸ à souder à l’aide d’un fil de cuivre afin d’avoir une panne assez petite pour pouvoir souder les composants. Par conséquent les soudures effectuées ne

16. Le format Gerber est un format standard pour stocker les informations d’un circuit imprimé.
17. Les composants utilisés sont soudés à la surface du circuit imprimé. Ce sont des composants SMD (Surface Mounted Device).
18. La panne du fer à souder est le bout du fer. Il s’agit de la partie qui est en contact avec la soudure.

23 sont pas toujours très propres mais fonctionnent correctement. On peut voir sur la figure 18 que j’ai utilisé la caméra de mon téléphone en guise de loupe pour mieux voir les pattes des composants.

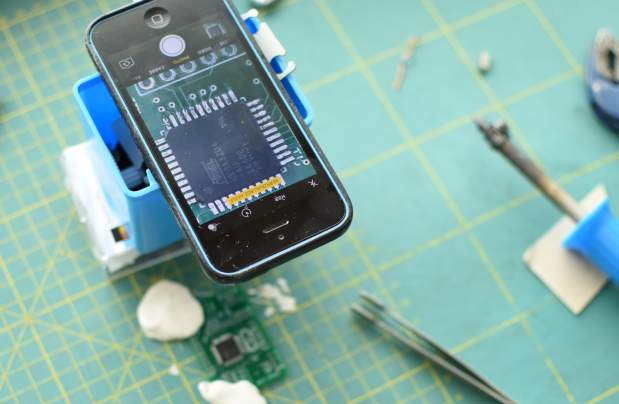
[picture p23: figure]

Figure 18 – Soudage du microcontrôleur sur le PCB

### 5.8 Initialisation du microcontrôleur

Après avoir soudé tous les composants on ne peut pas encore utiliser le circuit, en effet le microcontrôleur a besoin de contenir un bootloader. Le bootloader est un microprogramme qui doit être dans le microcontrôleur pour que ce dernier puisse être programmé avec l’environnement Arduino. Il est relativement simple d’installer le bootloader dans le micrcontrôleur, pour commencer il va falloir téléverser l’exemple ArduinoISP (Fichier > Exemples > ArduinoISP) dans un arduino UNO. Ensuite il faut faire les connexions suivantes entre l’arduino UNO et le circuit imprimé :

Broches de l’Arduino UNO | Broches du circuit imprimé
10 11 12 13 5v Gnd | RST MOSI MISO SCK Vcc Gnd

Les broches citées dans la colonne de droite du tableau sont toutes regroupées en haut à gauche du circuit imprimé (fig.17). Après avoir réalisé ces branchements il suffit de graver la séquence d’initialisation depuis le logiciel Arduino

24

(Outils > Graver la séquence d’initialisation). Une fois cette étape terminée le microcontrôleur est prêt à être programmé en branchant le circuit imprimé à l’ordinateur avec un câble USB.

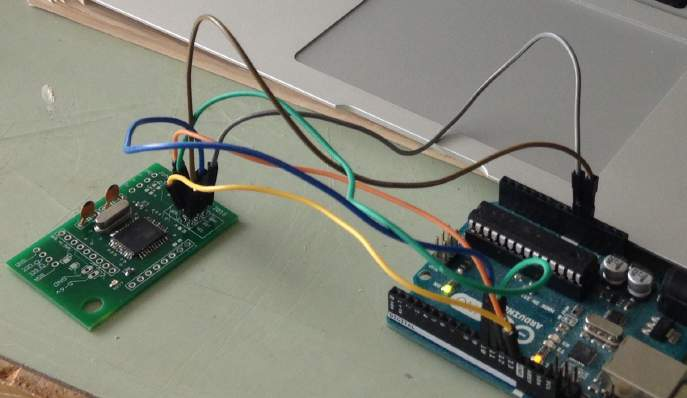
[picture p24: figure]

Figure 19 – Initialisation du microcontrôleur

25

## 6 Fonctionnement d’un régulateur PID

### 6.1 Qu’est ce qu’un régulateur PID ?

Un régulateur PID est un système dont l’objectif est de réguler une grandeur réelle pour qu’elle se rapproche au maximum d’une valeur que l’on souhaite atteindre. Le but de ce système est de parvenir à la consigne ¹⁹ le plus rapidement possible et cela peu importe les éléments qui peuvent perturber le régulateur. Dans le cadre de ce travail de maturité, le régulateur PID sera un élément-clé car il contrôlera la position de la bille sur le plateau afin de la faire correspondre à la position souhaitée. Le système pourra alors déduire l’inclinaison requise du plateau pour déplacer la bille au bon emplacement.

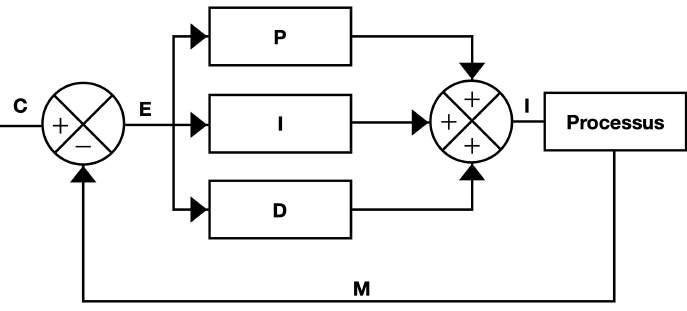
[picture p25: figure]

Figure 20 – Schéma d’un régulateur PID

Le schéma ci-dessus représente le fonctionnement du régulateur PID qui va être utilisé. Ce schéma se lit de gauche à droite, la lettre C représente la consigne et la lettre M la mesure donnée par un capteur. La différence des deux valeurs va nous donner l’erreur (lettre E sur le schéma) qui va ensuite être traitée par le correcteur PID pour finalement obtenir une instruction (lettre I) qui servira à diminuer l’erreur.

### 6.2 La régulation Proportionnelle

Un régulateur PID est composé de trois types de régulations, le premier est la régulation proportionnelle. Ce principe de régulation est le plus simple car il met en relation la valeur mesurée avec la consigne de manière linéaire. En d’autres termes, plus la bille sera éloignée de la position souhaitée (consigne), plus le plateau se penchera. Pour un régulateur proportionnel on a la relation suivante :
I = Kp(C − M) | (2)
19. Valeur que l’on souhaite atteindre.

26 où I est l’instruction, Kp est un coefficient, C est la consigne et M est la valeur réelle mesurée. L’instruction est la valeur qui permet de déterminer les angles des servomoteurs pour qu’ils placent le plateau dans la bonne position. Le coefficient Kp doit être déterminé expérimentalement. Si Kp est grand alors la consigne sera atteinte plus rapidement et avec précision mais le système risque de devenir instable. Il faut donc trouver un compromis entre la stabilité et la rapidité du système.

La régulation proportionnelle ne prend pas en compte la vitesse à laquelle l’écart entre la mesure et la consigne évolue. La durée de l’écart n’est pas non plus pris en compte. De plus ce type de régulation a un autre défaut car, dans certains cas, la consigne n’est jamais atteinte. En effet il se peut que le système se stabilise légèrement en dessus ou en dessous de la consigne et crée une erreur statique. Par exemple, si le système que j’ai fabriqué se trouve sur une surface qui n’est pas parfaitement à l’horizontale, la bille sur le plateau ne se stabilisera jamais à la position voulue mais s’en approchera. L’équation (2) nous montre que l’instruction est égale à 0 si l’erreur entre la consigne et la mesure est nulle. Selon cette équation, le plateau doit avoir une inclinaison de 0

- pour maintenir la bille
à la bonne place, or si le système se trouve sur une surface qui est légèrement en pente, le plateau sera également penché bien que l’ordinateur a donné l’ordre au système de placer le plateau à l’horizontale. Par conséquent la bille tentera d’atteindre la consigne mais elle se stabilisera un peu à côté. En d’autres termes, lorsque la bille se trouve loin de la consigne le plateau va s’incliner pour faire rouler la bille jusqu’à la consigne, à ce moment l’erreur entre la mesure et la consigne sera nulle, donc l’instruction le sera aussi et par conséquent le plateau se placera à 0
- d’inclinaison. Mais comme le système n’est pas sur un sol parfaitement horizontal, la bille va commencer à s’éloigner de la consigne et donc le système penchera le plateau pour refaire parvenir la bille à la position voulue et là le problème recommence. Le système fini donc par se stabiliser en plaçant la bille légèrement à coté de la consigne.

### 6.3 La régulation Proportionnelle et Intégrale

L’ajout de la régulation intégrale va permettre d’augmenter les performances du système précédent. Le régulateur intégral a pour but de corriger l’erreur statique qui est un des défauts de la régulation proportionnelle. Pour ce faire, le régulateur va prendre en compte la durée de l’écart entre la consigne et la mesure. Par conséquent le sytème va, plusieurs dizaines de fois par seconde, additionner à une variable du programme la valeur de l’écart. Cette variable contient la somme de toutes les erreurs qui ont eu lieu depuis l’allumage du système. Finalement le programme additionne le résultat de la régulation proportionnelle avec le résultat de la régulation intégrale. On peut donc résumer le régulateur proportionnel et intégral avec l’équation suivante :

I = Kp(C − M) + Ki

Z t

0

(C − M)dt | (3)

27 où Ki est un coefficient qui doit être déterminé expérimentalement.

### 6.4 La régulation Proportionnelle, Intégrale et Dérivée

Le dernier système de régulation fonctionne avec la dérivée de la position de la bille. En effet, les deux régulateurs présentés précédemment ne prennent pas en compte la vitesse de la bille. Pourtant la vitesse de la bille est un élément très important pour pouvoir réguler sa position. Le programme va calculer la vitesse de la bille en temps réel en additionnant la position de la bille avec sa position précédente et en divisant le résultat obtenu par le temps qui s’est écoulé entre deux images envoyées par la caméra qui filme la bille. Ce temps se situe aux alentours de 0.03 secondes car la caméra filme à une vitesse de 30 images/secondes. On peut résumer le régulateur proportionnelle, intégrale et dérivée par l’équation suivante :

I = Kp(C − M) + Ki

Z t

0

(C − M)dt + Kd

dr
dt | (4)

où dr est la distance parcourue par la bille dans un intervalle de temps (dt) qui tend vers 0 et Kd est un coefficient qui doit être déterminé expérimentalement.

28

## 7 Mise en place du régulateur PID dans le programme Python

### 7.1 Transformation des équations

Les équations (2), (3) et (4), sont présentées avec des notions d’intégrales et de dérivées. Les équations ont été formulées ainsi pour les présenter de manière générale dans une notation qui est fréquemment utilisée en physique. Dans ce projet, c’est l’équation (4) qui va être utilisée car elle contient les trois formes de régulation présentées. Cette équation va être traitée par un ordinateur, on peut donc légèrement la modifier pour supprimer l’intégrale et la dérivée :

I = Kp(C − M) + KiSerreur + Kd

Mprecedente − M
0.03

(5)

où Serreur est une variable du programme qui contient la somme de toutes les erreurs ²⁰ qui ont eu lieu depuis l’allumage du système, M est la position actuelle, mesurée par la caméra, de la bille et Mprecedente est la position précédente de la bille.
Dans le programme Python, l’équation (5) est présente deux fois car les axes X et Y sont traités séparément, on obtient donc les deux équations suivantes :

Ix = Kp(Cx − Mx) + KiSerreurX + Kd

MprecedenteX − Mx
0.03

(6)

Iy = Kp(Cy − My) + KiSerreurY + Kd

MprecedenteY − My
0.03

(7)

Grâce aux équations (6) et (7) nous obtenons les composantes du vecteur I qui permettent de savoir dans quelle direction la bille doit se déplacer. Maintenant, nous devons en déduire la valeur des angles α et β (fig.7, page 11) qui définissent l’inclinaison du plateau.

### 7.2 Un exemple concret

### 7.2.1 Détermination des composantes Ix et Iy

Cette section permet d’expliquer le fonctionnement du programme Python à travers un exemple concret. Pour ce faire j’ai lancé une balle de ping-pong sur le plateau du système et j’ai récupéré les différentes données traitées par le programme à un moment donné. En voici une partie :

— Position de la balle en x : Mx = 176px
— Position de la balle en y : My = 147px
— Précédente position de la balle en x : MprecedenteX = 184px
— Précédente position de la balle en y : MprecedenteY = 160px
20. L’erreur est définie par la soustraction de la consigne par la position mesurée de la bille.

29

— Somme de toutes les erreurs en x : SerreurX = 6179px
— Somme de toutes les erreurs en y : SerreurY = 2333px

Il est important de préciser que les valeurs ci-dessus sont définies en pixels car elles ont été mesurées à partir des images de la caméra située au-dessus du plateau. Il faut également rappeler que l’origine du système d’axes se situe en haut à gauche du champ de vision de la caméra, de plus l’axe des y est dirigé vers le bas. La figure 21 (page 31) est une vue schématique de ce que la caméra filme. Dans cet exemple, la balle doit se stabiliser au milieu du plateau par conséquent la consigne sera définie ainsi :

— Position de la consigne en x : Cx = 240px
— Position de la consigne en y : Cy = 240px

La caméra est réglée pour filmer avec une résolution de 480px par 640px, l’image est ensuite recardée pour avoir une résolution de 480px par 480px. Etant donné que la caméra se situe exactement au-dessus du plateau, le centre du plateau correspond au centre de l’image, donc le centre du plateau se situe à la position (240px ;240px ) de l’image (voir figure 21, page 31).

Pour cet exemple, les coefficients Kp, Ki et Kd ont les valeurs suivantes :

— Coefficient proportionnel : Kp = 5
— Coefficient intégrale : Ki = 0.1
— Coefficient dérivée : Kd = 4.5

Ces coefficients ont été déterminés expérimentalement. Ces valeurs permettent au système de stabiliser la balle lorsqu’elle a une vitesse initiale modérée ou nulle. Cependant la détermination et l’étude de ces coefficients sera étudiée de manière plus approfondie dans un futur chapitre de ce travail.

Maintenant le programme peut utiliser les équations (6) et (7) pour calculer Ix et Iy :

Ix = Kp(Cx − Mx) + KiSerreurX + Kd

MprecedenteX − Mx
0.03

= 5 ∗ (240 − 176) + 0.1 ∗ 6179 + 4.5 ∗

184 − 176
0.0333
≈ 2018.98

(8)

Iy = Kp(Cy − My) + KiSerreurY + Kd

MprecedenteY − My
0.03

= 5 ∗ (240 − 147) + 0.1 ∗ 2333 + 4.5 ∗

160 − 147
0.0333
≈ 2455.05

(9)

30

Les valeurs obtenues sont ensuite divisées par 10000, cette opération a pour but de pouvoir utiliser des coefficients plus petits et donc plus agréables à régler. Il serait donc possible de garder Ix et Iy sans faire la division par 10000, mais les coefficients Kp, Ki et Kd seraient alors 10000 fois plus grands et donc moins agréables à manipuler.

Ix =

2018.98
10000
≈ 0.2019 | (10)

Iy =

2455.05
10000
≈ 0.2455 | (11)

### 7.2.2 Détermination de l’angle α

Nous avons déterminé les composantes Ix et Iy, maintenant nous pouvons facilement en déduire l’angle α qui correspond à l’angle entre un plan horizontal et et le plan qui contient le plateau du système. La section 3.2 (page 10) expliquait qu’un vecteur ~v est créé et que ce vecteur est toujours perpendiculaire au plateau. On peut donc définir l’angle alpha comme étant l’angle entre la verticale et le vecteur ~v. La figure 22 ci-dessous permet de mieux comprendre les liens entre les différents éléments. Il est aussi utile de rappeler que k~vk = 1. Le point M présent sur les deux figures représente le centre de la balle qui est sur le plateau.

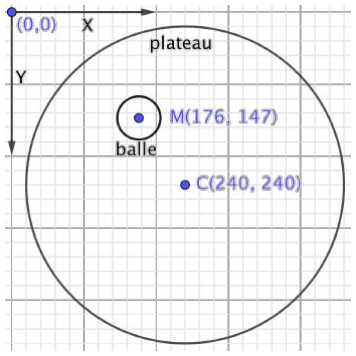
[picture p26: figure]

Figure 21 – Vu de dessus du problème

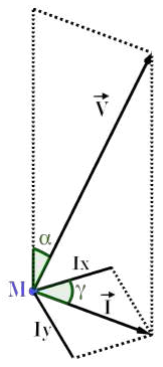
[picture p27: figure]

Figure | 22 | –
Construction de ~v

À l’aide des formules basiques de trigonométrie on peut facilement trouver la relation suivante :

31

sin(α) =

q
I

2
x + I

2
y
1

(12)

Ensuite il suffit d’isoler α :

α = arcsin

q
I

2
x + I

2
y
1
- (13)

On peut utiliser les valeurs de Ix et Iy trouvées avec les équations (10) et (11) (page 31) :
α = arcsin √ 0.2019² + 0.2455²

1

!
≈ 18.53◦
(14)

Maintenant nous savons que le plateau devra s’incliner de 18.53◦ par rapport à l’horizontale. Le système fabriqué est capable d’incliner le plateau de 35◦ au maximum, par conséquent le programme Python contient une condition qui empêche le système de s’incliner de plus de 35◦
. Autrement dit, l’angle α est fixé par le programme à 35◦
lorsque l’équation (13) donne une valeur supérieure à 35◦

. Cet angle est également fixé à 35◦

lorsque q
I

2
x + I

2
y > 1.

### 7.2.3 Détermination de l’angle β

L’angle β est un peu plus compliqué à trouver que l’angle α. Dans un premier temps nous allons déterminer l’angle γ présent sur la figure 22 (page 31). Cette première étape est assez simple :

| γ = arctan
Iy
Ix
(15)

En utilisant les valeurs de Ix et Iy trouvées avec les équations (10) et (11) (page
31) on obtient :
γ = arctan
0.2455

0.2019
≈ 50.56◦
(16)

32

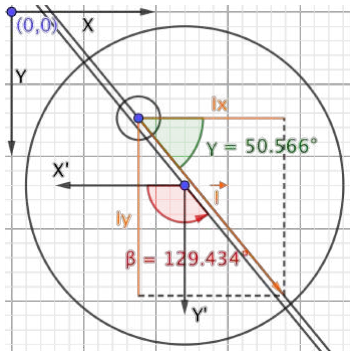
[picture p28: figure]

Figure 23 – Détermination de l’angle β

Pour des raisons de visibilité, la norme du vecteur I~ a été multiplié par 1000 sur ce schéma.

Les axes X’ et Y’ du schéma ci-dessus représentent le repère orthonormé présent sur la figure 5 (page 10).
L’équation (15) donnera toujours un angle compris dans l’intervalle ]−90◦

; 90◦
[,
pourtant on a défini dans la section 4.2 (page 18) qu’il faut un angle β compris dans l’intervalle [0◦

; 360◦
[ pour définir la direction de l’inclinaison du plateau. Il faut alors déduire l’angle β à partir de l’angle γ. Le problème comporte quatre cas de figure, les voici :

— Ix > 0 et Iy > 0
— Ix > 0 et Iy 6 0
— Ix < 0 et Iy > 0
— Ix < 0 et Iy 6 0

Le premier cas de figure correspond à la situation vue dans la figure 23. Les deux composantes sont positives, donc il faut faut faire 180 − γ pour obtenir l’angle β. Pour les quatre cas de figure il faut faire une opération différente.

— Ix > 0 et Iy > 0 | β = 180 − |γ|
— Ix > 0 et Iy 6 0 | β = 180 + |γ|
— Ix < 0 et Iy > 0 | β = |γ|
— Ix < 0 et Iy 6 0 | β = 360 − |γ|

Nous devons ajouter encore deux conditions à la liste ci-dessus car l’équation
(15) (page 32) est indéterminée si Ix est nulle :
— Ix = 0 et Iy > 0 | β = 90
— Ix = 0 et Iy 6 0 | β = 270
| 33

Avec l’équation (16) (page 32) nous avons calculé que γ = 50.56. Nous savons grâce aux équations (10) et (11) (page 31) que les composantes du vecteur ~I sont positives. Nous pouvons en déduire que β = 180 − 50.56 = 129.44◦

### 7.2.4 Détermination des angles de chaque moteur

Nous avons trouvé les angles α et β qui définissent l’inclinaison et l’orientation du plateau, maintenant le programme doit faire tourner les moteurs pour placer le plateau dans la bonne position. Dans un premier temps, les angles trouvés doivent être arrondis à 0.2 près. La section 4.2 (page 18) expliquait qu’un fichier texte a été créé pour contenir toutes les relations entre l’angle de chaque moteur et les angles α et β. Par conséquent le programme Python qui a déterminé α et β va aller chercher dans le fichier texte la ligne qui commence par "18.6 | 129.4". La ligne trouvée sera la suivante : "18.6|129.4#51.24|37.09|73.18". À
gauche du # on retrouve les angles α et β et à droite du # trois nombres correspondent respectivement à l’angle θ de chaque moteur. Pour finir, le programme envoie ces trois angles par USB à l’Arduino qui contrôle le système.

34

## 8 Utilisation de OpenCV avec Python

### 8.1 Qu’est-ce que OpenCV ?

OpenCV (Open Source Computer Vision) est une bibliothèque contenant plus de 2500 d’algorithmes permettant de faire du traitement d’images. OpenCV est la bibliothèque la plus utilisée en ce qui concerne la vision par ordinateur. Cette bibliothèque est disponible pour les langages C, C++ et Python. Pour ce projet nous utiliserons le langage Python car il est particulièrement simple à utiliser.

### 8.2 Programme intermédiaire

Afin de me familiariser avec OpenCV j’ai décidé d’écrire un exemple de programme servant à détecter la position d’un objet d’une certaine couleur. Cet exemple est très important car il sera très utile pour le programme final du projet. L’utilisation de ce code est relativement simple, en effet lorsqu’on lance le programme une fenêtre s’ouvre et affiche en direct les images prises par la webcam branchée à l’ordinateur. Ensuite il suffit de cliquer à l’aide de la souris sur un objet que l’on souhaite et le programme va détecter sa couleur puis entourer cet objet avec un cercle jaune.

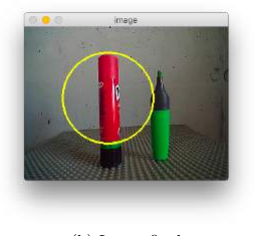
[picture p29: figure]
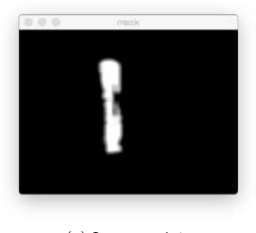
[picture p30: figure]

(a) Image traitée | (b) Image final

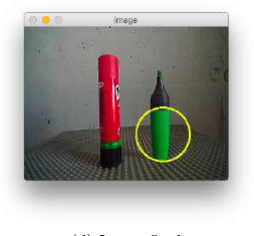
[picture p31: figure]
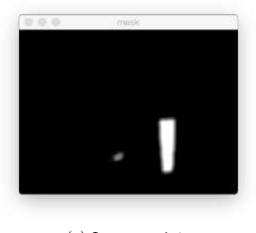
[picture p32: figure]

(c) Image traitée | (d) Image final

Figure 24 – Capture d’écran du programme intermédiaire en fonctionnement

35

### 8.3 Reconnaissance d’une couleur

Grâce à OpenCV, nous pouvons détecter une couleur dans une image relativement facilement. Dans un premier temps il faut savoir que OpenCV utilise l’espace colorimétrique HSV ²¹, cela veut dire que dans le programme les couleurs seront définies selon trois nombres. Le premier est un nombre compris dans l’intervalle [0; 179] et permet de définir la teinte d’une couleur. Le deuxième et le dernier nombre sont compris dans l’intervalle [0; 255] et permettent de définir respectivement la saturation et la valeur ²² de la couleur. Si par exemple nous voulons que le programme détecte la couleur rouge dans une image, il faut lui donner un intervalle de couleur dans lequel se trouve la couleur que l’on veut isoler. L’intervalle permettra au programme de détecter tous les rouges entre du rouge très clair et du rouge foncé. Pour commencer, nous créons deux variables qui contiennent respectivement le rouge clair et le rouge foncé dans l’espace colorimétrique HSV.

1 | r o u g e Cl ai r = np . a r r a y ( [ 0 , 1 0 0 , 1 0 0 ] )
2 | rougeFonce = np . a r r a y ( [ 0 , 2 5 0 , 2 5 0] )

Ensuite le programme va créer une image en noir et blanc (figure 24) où les zones blanches montrent l’emplacement de la couleur recherchée.

1 imageNoirBlanc = cv2 . inRange ( imageCouleur , r o u g e Cl ai r , rougeFonce )

21. HSV signifie Hue Saturation Value.
22. La valeur d’une couleur correspond à sa luminosité.

36

## 9 L’interface graphique

### 9.1 Pourquoi faire une interface graphique ?

Afin d’utiliser le système que j’ai fabriqué avec facilité, j’ai décidé de programmer en Python une interface graphique me permettant de contrôler plusieurs aspects du système.

### 9.2 Fonctionnalités de l’interface

L’interface est composée de quatre parties bien distinctes :

— La première partie permet de faire des réglages liés à la vidéo prise par la caméra.
— La deuxième partie permet de contrôler les moteurs, et permet également de démarrer le système.
— La troisième partie permet de régler les coefficients Kp, Ki et Kd.
— La dernière partie permet de faire suivre à la balle une forme géométrique.

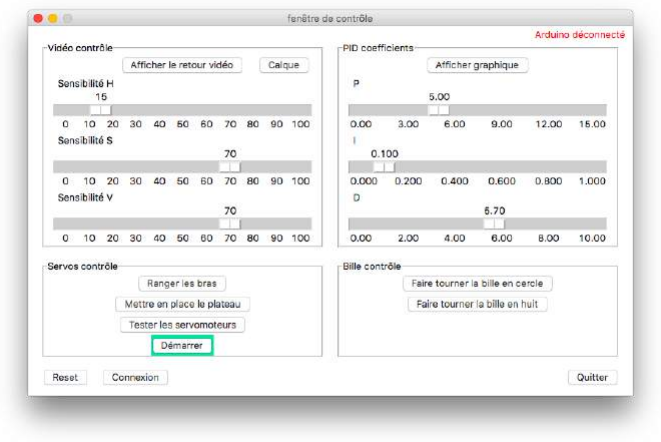
[picture p33: figure]

Figure 25 – Capture d’écran de l’interface graphique

37

Les boutons "Afficher le retour vidéo" et "Afficher graphique" permettent d’ouvrir les fenêtres ci-dessous.

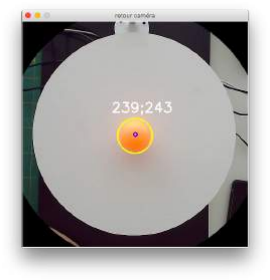
[picture p34: figure]

Figure 26 – Retour vidéo de la caméra

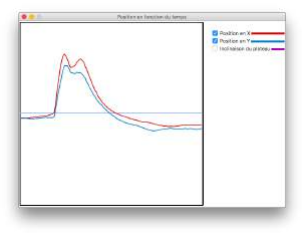
[picture p35: figure]

Figure 27 – Graphique de la position de la balle en fonction du temps

La fenêtre (figure 26) diffuse les images prises par la caméra. Au centre, nous pouvons y voir la balle de ping-pong orange qui est entouré d’un cercle jaune. Ce cercle permet se rendre compte que le programme détecte le bon objet, de plus le programme rajoute, au-dessus du cercle, les coordonnées de la balle. Au centre du cercle jaune, un point bleu marque l’emplacement de la consigne. La fenêtre (figure 27) affiche un graphique de la position de la balle en fonction du temps. La ligne rouge représente la position de la balle selon l’axe des x et la ligne bleu représente la position de la balle selon l’axe des y en fonction du temps.

38

## 10 Le code Arduino

### 10.1 Communication avec le programme Python

On peut facilement faire communiquer un programme Python avec un Arduino. La bibliothèque serial permet au programme Python d’envoyer des informations à un périphérique USB.

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

Dans l’exemple ci-dessus, la commande write envoie à l’Arduino le mot "information". De son côté, l’Arduino doit juste lire le port USB de la manière suivante :

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

### 10.2 Contrôle des servomoteurs

Normalement on utilise la fonction write pour faire tourner un servomoteur à l’aide d’un Arduino, cependant cette fonction permet de faire tourner le moteur avec une précision de seulement 1

| ◦
. La section 4.2 (page 18) a permis de calculer les angles que les moteurs doivent avoir pour mettre le plateau dans n’importe quelles positions. Ces angles ont des valeurs précises au centième près et les moteurs doivent avoir ces angles avec précision. Il faut utiliser la fonction writeMicroseconds qui permet de faire tourner un servomoteur avec beaucoup de précision. Si nous écrivons writeMicroseconds(1000) le servomoteur se placera avec un angle de 0
| ◦
et si nous écrivons writeMicroseconds(2000) le servomoteur se placera avec un angle de 180◦
. La fonction writeMicroseconds est donc moins intuitive à utiliser que la fonction write car nous pouvons mettre une valeur en degré dans la fonction write. Cependant la fonction writeMicroseconds permet d’avoir plus de précision.

39

## 11 Analyse des performances du système selon les coefficients P, I et D

### 11.1 Première expérience : analyse des coefficients P et D

Un des aspects qui permet de définir la qualité d’un régulateur PID est le temps qu’il met à atteindre la consigne souhaitée. Ce temps doit bien entendu être le plus faible possible. L’objectif de cette expérience sera de déterminer le temps qu’il faut au système pour déplacer et stabiliser une balle d’un point sur le plateau jusqu’à son centre en fonction de la masse de la balle et des coefficients utilisés.

### 11.1.1 Mise en place de l’expérience

Le programme Python du système a été modifié pour réaliser cette expérience, les modifications permettent de contrôler l’expérience et enregistrer des données qui seront analysées après l’expérience. Voici comment se déroule l’expérience :
— Au début de l’expérience le plateau est à l’horizontale et immobile.
— La balle est placée manuellement à un emplacement précis, voir figure 28 page 41.
— En appuyant sur la touche ’a’ du clavier de l’ordinateur, le programme Python enclenche le régulateur PID et démarre un chronomètre.
— Le chronomètre s’arrête lorsque la balle est stabilisée au centre du plateau.
— L’expérience s’arrête automatiquement au bout de 10 secondes. Le programme enregistre toutes les coordonnées de la balle qui ont été mesurées pendant l’expérience dans un fichier .xlsx ²³. Ce fichier permettra de faire des graphiques pour analyser les expériences après-coup.
— On peut alors recommencer en modifiant les coefficients P et D et le type de balle.

Une petite cale métallique fixée sur le plateau permet de toujours placer la balle au même endroit au début de chaque essai. La position initiale de la balle correspond toujours aux coordonnées (45 ; 240) (voir figure 28 page 41). En plaçant la balle à la coordonnée 240 on sait que la balle va ensuite se déplacer dans la direction de l’axe X (voir figure 28) ce qui permet de simplifier l’analyse des données à la fin de l’expérience. En effet cela nous permettra de nous concentrer uniquement sur les coordonnées de l’abscisse puisque les coordonnées sur les ordonnées seront toujours égale ou proche de 240.
Pour mener à bien cette expérience il faut également trouver un moyen de définir le moment où on peut affirmer que la balle est stabilisée. Dans tous les cas, le système n’est pas assez précis pour atteindre la consigne sans aucunes erreurs résiduelles c’est pourquoi il a été décidé de déclarer la balle comme étant
23. Le .xlsx est une extension pour tableur.

40 stabilisée lorsque le système arrive à la maintenir au minimum deux secondes à moins de 20 pixels de la consigne (centre du plateau). Au total, l’expérience dure 10 secondes ce qui est largement suffisant pour stabiliser la balle. En effet si le régulateur PID mettait plus de 10 secondes pour stabiliser la balle, il ne pourrait pas être considéré comme étant efficace pour ce projet.

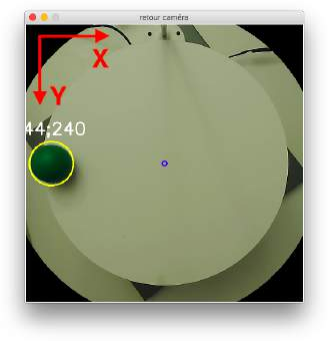
[picture p36: figure]

Figure 28 – Situation initiale de l’expérience

### 11.1.2 Réalisation de l’expérience

Pour cette expérience mous allons varier les coefficients P et D mais le coefficient I sera fixé à 0.1. Nous reviendrons sur l’utilité de ce coefficient dans une autre expérience. Le prochain schéma résume les différentes valeurs des coefficients qui vont être utilisées. L’expérience sera réalisée deux fois en utilisant deux balles de masse différentes. La première balle sera une balle de ping-pong de 2.7 grammes et et la deuxième sera une bille en céramique de 19.5 grammes.

Figure 29 – Liste des coefficients utilisés dans l’expérience

41

A l’issue des ces expériences nous obtiendrons des graphiques comme celui ci-dessous :

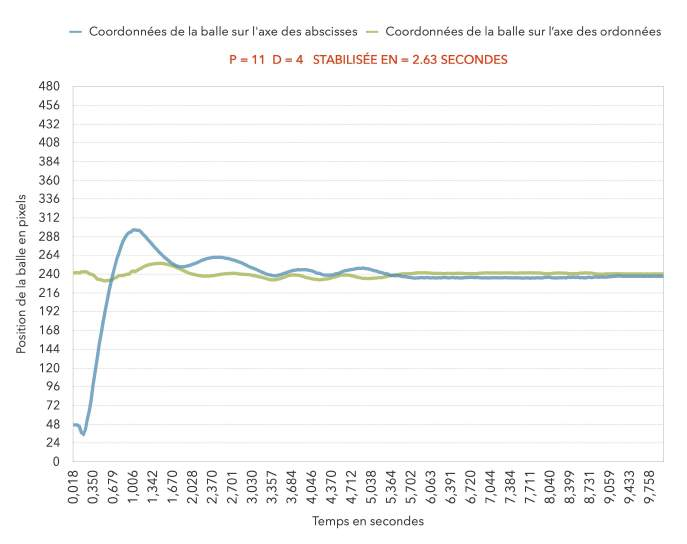
[picture p37: figure]

Figure 30 – Exemple de graphique obtenu lors de cette expérience

Ce graphique présente la position de la balle en fonction du temps sur une durée de 10 secondes. La courbe verte varie très peu et reste aux alentours de 240 pixels ce qui montre bien que la balle se déplace selon l’axe des abscisses qui correspond à la courbe bleu. Dans les graphiques qui seront présentés dans les résultats, les titres rouges indiqueront que les coefficients utilisés ont permis à la balle de se stabiliser au centre du plateau. Dans cet exemple la balle a été considérée comme étant stable à partir de 2,63 secondes à partir du début de l’expérience.

### 11.1.3 Résultats de l’expérience

L’ensemble des 54 graphiques résultant des tests effectués en utilisant une balle de ping-pong et différentes combinaisons de coefficients se trouvent dans l’annexe A (page 63). Un extrait des résultats se trouve sur la prochaine page.

42

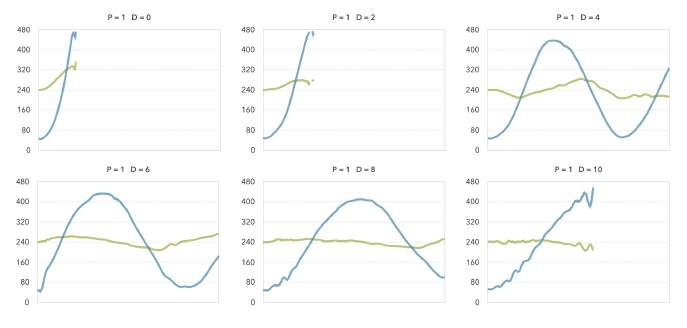
[picture p38: figure]

Figure 31 – Extrait des résultats de l’expérience avec la balle de ping-pong. L’intégralité des résultats se trouve dans l’annexe A (page 63)

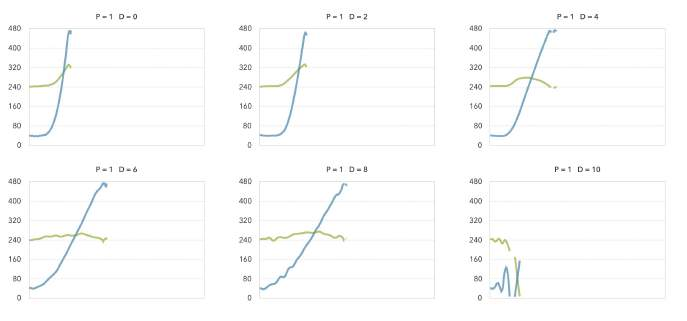
[picture p39: figure]

Figure 32 – Extrait des résultats de la même expérience mais réalisée avec une balle en céramique d’une masse de 19.5 grammes. L’intégralité des résultats se trouve dans l’annexe B (page 67)

43

Ci-dessous se trouve la liste des coefficients qui ont permis de stabiliser la balle de ping-pong (liste de gauche) et la balle en céramique (liste de droite). Les trois meilleurs temps de stabilisation Ts de chaque liste sont mis en évidence en couleur.

Coef. P | Coef. D | Ts
5 | 4 | 2.73
5 | 6 | 6.05
5 | 8 | 6.95
7 | 4 | 2.16
7 | 6 | 3.67
5 | 8 | 5.59
5 | 10 | 6.91
9 | 4 | 1.85
9 | 6 | 4.65
11 | 4 | 2.63
11 | 6 | 0.92
11 | 8 | 2.75
11 | 10 | 5.74
13 | 4 | 1.35
13 | 6 | 0.86
13 | 8 | 2.69
13 | 10 | 4.49
15 | 4 | 1.22
15 | 6 | 1.94
15 | 8 | 2.17
15 | 10 | 3.43
17 | 4 | 2.38
17 | 6 | 1.79
17 | 8 | 1.65
17 | 10 | 2.41
Coef. P | Coef. D | Ts
5 | 2 | 6.03
5 | 4 | 5.42
7 | 2 | 5.54
7 | 4 | 0.99
7 | 6 | 6.28
9 | 2 | 6.21
9 | 4 | 2.44
9 | 6 | 4.26
9 | 8 | 6.07
11 | 4 | 1.35
11 | 6 | 0.93
13 | 4 | 2.84
13 | 6 | 1.02
13 | 8 | 2.87
15 | 4 | 2.51
15 | 6 | 1.65
15 | 8 | 2.67
17 | 4 | 2.12
17 | 6 | 1.62
17 | 8 | 2.05

### 11.1.4 Discussion des résultats

Vingt-six combinaisons de coefficients ont permis de stabiliser la balle de ping-pong mais seulement 20 combinaisons de coefficients ont réussi à stabiliser la balle en céramique. Ce résultat était attendu, en effet la masse plus élevée de la balle en céramique lui confère plus d’inertie que la balle de ping-pong par conséquent il est plus difficile pour le système d’annuler ou de réduire ses déplacements. La balle ayant plus d’énergie, elle est moins affectée par la pente du plateau qui tente de s’opposer à sa vitesse par exemple. Selon ce raisonnement on comprend pourquoi moins de combinaisons de coefficients ont arrêté la balle en céramique.
On observe certaines similarités entre les deux tableaux ci-dessus, en effet on constate que les trois meilleurs temps de chaque tableau ont été réalisés avec un

44 coefficient D valant 4 ou 6 et deux des trois meilleurs temps de chaque tableau sont obtenus avec les coefficients P = 11 ou P = 13. Il même assez étonnant de voir que la combinaison P = 11 et D = 6 a stabilisé les deux balles quasiment avec le même temps. Néanmoins il peut s’agir d’une coïncidence puisqu’il faudrait re-tester toutes les combinaisons de coefficients plusieurs fois pour faire une moyenne des temps de stabilisation et ainsi obtenir des données plus exactes. La combinaison P = 11 et D = 6 a été re-testée cinq fois pour chaque balle dans le tableau ci-dessous :

Ts Balle de ping-pong | Ts Balle en céramique
2.80 0.89 4.91 0.99 4.82 | 1.09 2.25 3.07 1.12 1.06

Ce tableau montre que les temps obtenus pour une même balle varient de plusieurs secondes lorsqu’on répète l’expérience plusieurs fois de suite. Il est donc impossible de considérer ces valeurs comme étant exploitables car les résultats varient trop d’un essai à l’autre. Il y des écart de plus de quatre secondes entre deux essais avec la même balle. Bien que les temps de stabilisation soient difficilement exploitables, les graphiques semblent beaucoup plus cohérents. Les prochains graphiques correspondent aux essais du tableau ci-dessus.

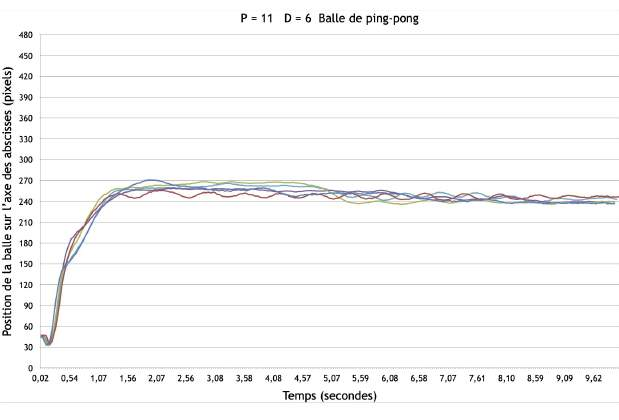
[picture p40: figure]

Figure 33 – Nouveaux essais de la combinaison P = 11 et D = 6 sur la balle de ping-pong

45

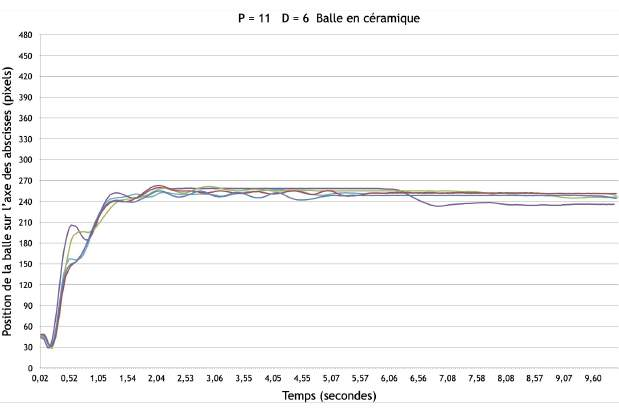
[picture p41: figure]

Figure 34 – Nouveaux essais de la combinaison P = 11 et D = 6 sur la balle en céramique

Les différentes courbes sont très similaires pourtant nous avons vu que les temps de stabilisation qui en sont déduit sont très variables. On peut remettre en question le critère qui a été défini au début de l’expérience pour affirmer qu’une balle est stabilisée. " Il a été décidé de déclarer la balle comme étant stabilisée lorsque le système arrive à la maintenir au minimum deux secondes à moins de 20 pixels de la consigne (centre du plateau) ", page 40.
En conclusion cette expérience a tout de même permis de déterminer les coefficients permettant de stabiliser la balle. Même s’il n’a pas été possible de quantifier précisément le temps de stabilisation de la balle par chaque combinaison de coefficients, les graphiques donnent une bonne idée des meilleurs coefficients à utiliser.

### 11.2 Deuxième expérience : analyse du coefficient I

Dans l’expérience précédente nous avons fixé le coefficient I à 0.1. Maintenant nous allons faire varier ce paramètre en gardant constant les coefficients P et D. Ainsi nous verrons en quoi il peut participer à l’amélioration du régulateur PID. Cette expérience sera réalisée avec les mêmes balles que l’expérience précédente et nous utiliserons uniquement les coefficients P = 11 et D = 6 car nous avons vu que cette configuration fonctionnait avec les deux types de balle même s’il n’a pas été prouvé qu’il s’agissait de la combinaison la plus efficace. Au début de l’expérience la balle est placée au même endroit que dans l’expérience précédente, à partir du démarrage du régulateur PID le programme enregistre les coordonnées de la balle pendant dix secondes exactement comme dans la

46 première expérience. Pour chaque balle on testera les coefficients I = 0.0, I = 0.1, I = 0.2, I = 0.3, I = 0.4 et I = 0.5 .

### 11.2.1 Résultats pour la balle de ping-pong

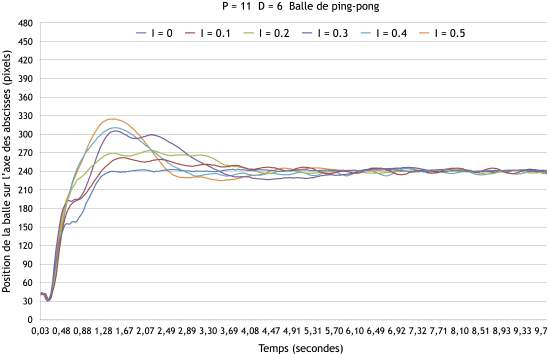
[picture p42: figure]

Figure 35 – Expérimentation du coefficient I sur la balle de ping-pong

### 11.2.2 Résultats pour la balle en céramique

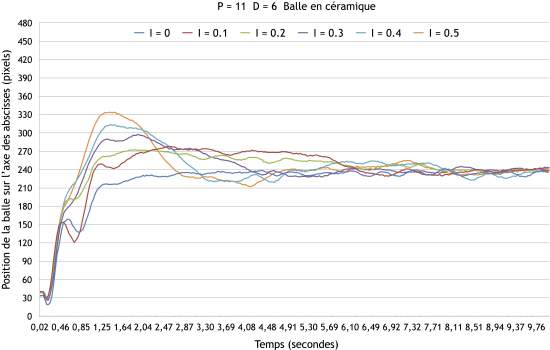
[picture p43: figure]

Figure 36 – Expérimentation du coefficient I sur la balle en céramique

47

### 11.2.3 Discussion des résultats

Tout comme dans la première expérience on peut voir que le système a toujours un peu plus de peine à stabiliser la balle ayant une masse plus élevée. On voit que les courbes sont plus rapprochées et lissées dans la figure 35 que dans la figure 36. Cependant dans les deux cas, on observe que la courbe qui se rapproche le plus rapidement de la coordonnée 240 est la courbe bleu qui a été produite avec un coefficient I nul. Peu importe la balle, plus ce coefficient est élevé plus la balle dépasse la consigne avant de stabiliser proche de celle-ci. Ces résultats montrent que le coefficient I a un effet négatif sur le régulateur PID puisqu’il augmente le dépassement de la consigne et augmente également le temps de stabilisation de la balle. Toutefois ce coefficient peut améliorer la précision du régulateur dans certaine situation. En effet il permet d’annuler l’erreur statique qui peut apparaître si le système est soumis à certaines contraintes extérieures comme par exemple du vent. On peut également imaginer que le système repose sur une table qui n’est pas parfaitement horizontale ce qui serait également une source d’erreur statique. Pour démontrer l’utilité du coefficient I dans cette situation, le système à été incliné d’environ trois degrés et des tests ont été effectués avec les coefficients I = 0 et I = 0.1 . La figure suivante dévoile très clairement la présence de l’erreur statique lorsque le coefficient I est nul.

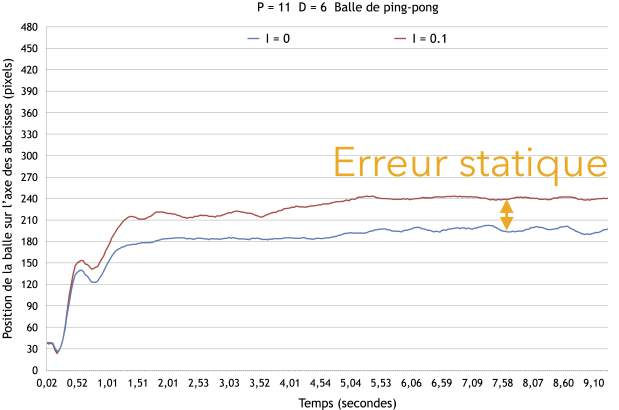
[picture p44: figure]

Figure 37 – Expérimentation du coefficient I lorsque le système est incliné de 3 degrés

En conclusion il semblerait que le coefficient I diminue les performances du régulateur lorsque le système est placé dans un environnement idéal. Cependant ce coefficient peut se révéler indispensable à la précision du système en présence d’éléments perturbateurs extérieurs comme du vent ou un support penché.

48

### 11.3 Dernière expérience : analyse des coefficients P et D

lorsque la balle a une vitesse initiale non nulle

Cette expérience sera similaire à la première à la différence près que cette fois la balle ne sera pas posée manuellement sur le plateau mais sur une rampe. La balle descendra cette rampe pour arriver sur le plateau du système avec une certaine vitesse initiale. Les tests seront effectués avec les deux balles habituelles, le coefficient I sera fixé à 0.1 et les combinaisons de coefficients P et D seront les mêmes que dans la première expérience.

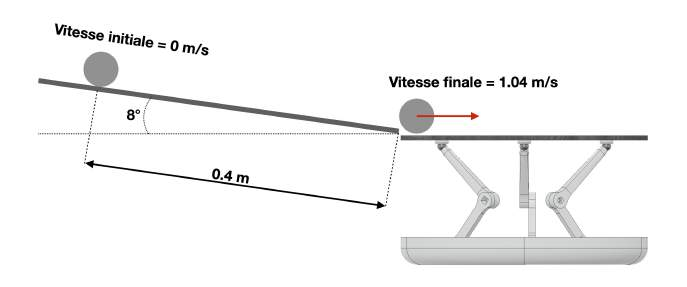
[picture p45: figure]

Figure 38 – Schéma de l’installation utilisée pour l’expérience

La vitesse de la balle à son arrivée sur le plateau du système a été calculée en sachant que l’énergie potentielle de la balle en haut de la rampe est égale à son énergie cinétique en bas de la rampe.

mgsin(8)0.4 = 1
2

mv²
(17)

v =

p

gsin(8)0.8 = p
9.81sin(8)0.8 = 1.04 m/s | (18)

### 11.3.1 Résultats de l’expérience

La prochaine page contient un extrait des graphiques résultants des 54 tests effectués avec chaque balle. Il est à noter que les résultats ne sont pas présentés de la même façon que dans la première expérience. Premièrement la courbe qui correspond à la position de la balle sur l’axe des ordonnées n’est pas tracée puisqu’elle est toujours très rapprochée de la coordonnée 240, ce qui est normal puisqu’on fait rouler la balle uniquement dans la direction de l’axe de abscisse du système (voir figure 28, page 41). Les résultats de chaque tests sur la balle de ping-pong et la balle en céramique seront affichés sur le même graphique pour pouvoir comparer les résultats plus facilement. La couleur verte correspond à la balle en céramique et la couleur bleu à la balle de ping-pong.

49

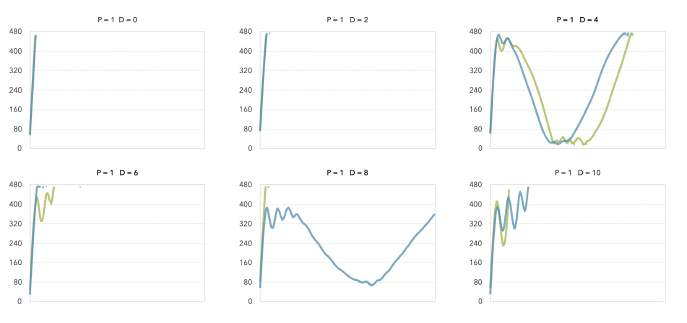
[picture p46: figure]

Figure 39 – Extrait des résultats de l’expérience. L’intégralité des résultats se trouve dans l’annexe C (page 71)

### 11.3.2 Discussion des résultats

Comme vous avez pu le constater, les temps de stabilisation des balles n’ont pas été pris en compte pour cette expérience car nous avions montré dans la première expérience que ces temps ne constituaient pas un critère assez précis pour comparer les résultats. Toutefois les résultats des deux balles étant affichés sur le même graphique, on peut facilement déterminer des conclusions intéressantes. Cette expérience montre à nouveau que le régulateur est plus efficace sur la balle la plus légère.

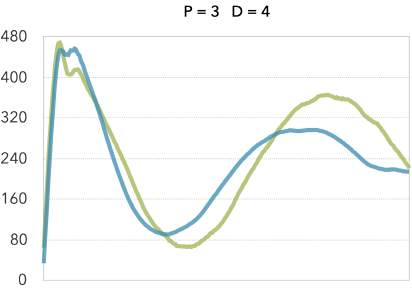
[picture p47: figure]

Figure 40 – Comparaison de l’efficacité du régulateur selon la balle utilisée. vert : balle en céramique bleu : balle de ping-pong

Ce graphique présenté dans les résultats de l’annexe C (page 71) est particulièrement parlant puisqu’il montre deux courbes ayant une oscillation très simi-

50 laire mais légèrement décalée dans le temps. En effet on remarque que la courbe bleu qui correspond à la position de la balle de ping-pong est "en avance" sur la courbe verte. En d’autres termes, les déplacements de la balle de ping-pong sont plus rapidement affectés par les mouvements du plateau du système car l’inertie de cette balle est moindre que l’inertie de la balle en céramique (courbe verte). On constate également que dans l’ensemble des résultats, la balle de ping-pong est tombée du plateau 30 fois alors que la balle en céramique est tombée 45 fois. À nouveau cela prouve le problème d’inertie qui est rencontré avec la balle de masse supérieure.

## 12 Discussion des trois expériences

Ces trois expériences ont permis d’identifier les différents comportements du régulateur en fonction de la masse de la balle utilisée et des combinaisons de coefficients. Nous avons observé que certaines combinaisons de coefficients étaient plus efficaces que d’autre et que parfois elles permettaient de stabiliser un seul type de balle. La première et la dernière expérience ont permis de montrer que le système réagit différemment en fonction de la vitesse initiale de la balle. Nous avons également expérimenté le coefficient I dont l’utilisation peut être discutée, en effet nous avons vu qu’il abaissait les capacités du régulateur dans un environnement contrôlé mais qu’il pouvait se révéler utile lorsque certains éléments perturbateurs et extérieurs au système sont présents comme par exemple le vent ou un support incliné.
La première expérience a montré qu’il n’a pas été possible d’établir un critère assez précis pour quantifier le temps requis à une combinaison de coefficients pour stabiliser la balle utilisée. Par conséquent aucune expérience n’a permis de déterminer objectivement la combinaison de coefficients optimale à la réussite de l’expérience en question. Malgré tout, les graphiques permettent de déterminer assez facilement les combinaisons qui ont abouties à une stabilisation de la balle. Quoi qu’il en soit, il est très difficile de trouver une combinaison qui satisfait toutes les expériences, en effet même si la combinaison la plus optimale avait été trouvée pour la première expérience, elle n’aurait pas été la plus optimale pour la troisième expérience dans laquelle la balle avait une vitesse initiale non nulle. Par conséquent il n’est pas véritablement possible de trouver une combinaison de coefficients parfaite puisqu’en réalité le réglage des coefficients dépend de l’utilisation du système. Si le système est destiné à stabiliser une balle dont la vitesse initiale est nulle, alors il faudra utiliser la première expérience pour trouver la bonne combinaison de coefficients mais si le système doit être capable de stabiliser la même balle avec un grand nombre de vitesses initiales possibles alors il faudra trouver un compromis entre les résultats de la première et dernière expérience. Selon les expériences réalisée, on remarque que la combinaison P = 13 et D = 6 a très bien fonctionné dans la première et la dernière expérience. On peut alors choisir cette combinaison si l’on veut que le système soit assez polyvalent pour stabiliser une balle peu importe sa vitesse initiale tant que cette dernière reste en dessous de 1.04 m/s. En effet il faudrait

51 encore faire des expériences pour vérifier si cette combinaison peut stabiliser une balle lancée à une vitesse supérieure.

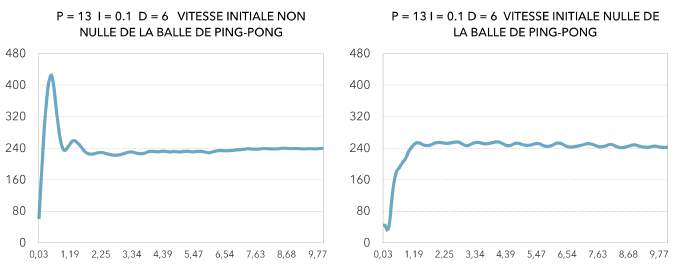
[picture p48: figure]

Figure 41 – Comparaison des résultats de la première et de la dernière expériences avec la combinaison P = 13 et D = 6

52

## 13 Faiblesses du système

### 13.1 Temps de détection de la balle

Tout régulateur PID contient un capteur qui permet de mesurer une grandeur réelle. Dans notre cas ce capteur est une caméra qui a pour but de filmer la balle, pour ensuite permettre à un programme d’en déduire les coordonnées de la position de la balle. Etant donné que la régulation se déroule en temps réel, le capteur doit fournir ses mesures dans le plus court laps de temps possible si l’on veut pouvoir corriger l’erreur le plus rapidement possible. Dans l’expérience qui va suivre, l’objectif est de mesurer le temps qui s’écoule entre le moment où la balle apparaît dans le champs de vision de la caméra et le moment où le programme Python déduit de l’image la position de cette balle. Pour exécuter cette expérience il a fallu créer un programme et une installation pour mesurer la latence que l’on cherche. L’expérience fonctionne en plaçant la caméra en face de l’écran de l’ordinateur sur lequel elle est branchée. Ce dernier exécute un programme qui agit en trois temps : au lancement du programme l’écran de l’ordinateur devient entièrement blanc, quelques secondes plus tard l’écran devient spontanément rouge, et finalement le programme qui analyse les images de la caméra en direct détecte la couleur rouge. Le programme peut ensuite facilement mesurer le temps qui s’est écoulé entre le moment ou il a affiché la couleur rouge et le moment où il a détecté cette couleur sur les images reçues par la caméra.

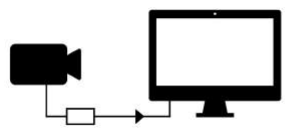
[picture p49: figure]

(a) Situation initiale : la caméra filme l’écran blanc et est branchée à l’ordinateur

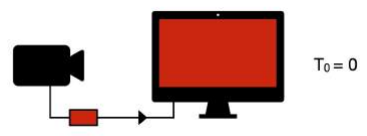
[picture p50: figure]

(b) Le programme affiche du rouge et démarre un chronomètre. L’écran rouge simule l’apparition d’une balle rouge dans le champs de vision de la caméra

53

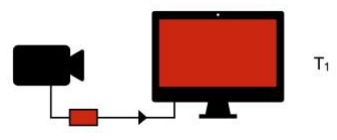
[picture p51: figure]

(c) Le programme arrête le chronomètre lorsqu’il détecte la couleur rouge sur une image reçue par la caméra

Figure 42 – Mesure du temps de détection de la balle par le système

L’expérience a été réalisée dix fois car les résultats semblaient varier. Le tableau ci-dessous présente les résultats obtenus.

Temps [en secondes]
0.1478
0.1920
0.1553
0.1552
0.1881
0.1578
0.1645
0.1557
0.1560
0.1657
Moyenne : 0.1638

Grâce à cette expérience on observe que le système prend en moyenne 0.1638 secondes pour s’apercevoir de l’apparition de la balle dans le champ de vision de la caméra. Cela veut dire que les coordonnées de la balle mesurées par le programme sont en retard de 0.1638 secondes par rapport à la réalité. Ce délai est causé par deux événements : premièrement le programme doit récupérer l’image prise par la caméra puis dans un deuxième temps il doit la traiter pour y trouver la couleur de la balle et en déduire les coordonnées qui correspondent à sa position. En améliorant le programme utilisé dans cette expérience on peut également mesurer le temps qu’il faut au programme pour traiter l’image et trouver les coordonnées de la balle.

54

Traitement de l’image [en secondes] 0.0122
0.0590
0.0253
0.0300
0.0272
Moyenne : 0.0307

Ce tableau nous montre que le programme met moins d’un dixième de seconde pour déterminer si une image contient la couleur de la balle. On comprend alors que la latence de 0.1638 secondes vue précédemment n’est presque pas causée par le traitement de l’image, mais plutôt par le temps qui s’écoule entre la prise d’une image par la caméra et le moment où le programme récupère cette même image avant de l’analyser. Pour tenter de diminuer cette latence il faudrait utiliser une autre caméra et améliorer les performances du programme. Cependant les expériences de la section 11 montrent que le système fonctionne malgré l’existence de cette latence.

### 13.2 Précision de la détection de la balle

Tout régulateur PID a besoin d’un capteur pour fonctionner, dans notre cas il s’agit d’une caméra. Le problème de ce choix est qu’il s’agit d’un capteur très complexe qui est complètement dépendant des conditions de luminosité qui l’entourent. Dans notre cas ce capteur doit pouvoir détecter une balle de couleur intrinsèque uniforme, cependant la couleur réelle de la balle est fortement perturbée par la présence d’ombre et de reflets. Les reflets sont liés à la texture de la balle, en utilisant une couleur mate on peut facilement les réduire. Les ombres proviennent des conditions d’éclairage dans lesquels se trouve le système, il est alors beaucoup plus difficile de les éliminer. Heureusement le programme Python est tout de même capable de déterminer les coordonnées de la balle car on lui donne un intervalle de couleurs à trouver dans l’image. Dans les images de la page suivante cet intervalle va du vert foncé qui correspond aux zones ombragées de la balle jusqu’au vert claire qui correspond aux reflets à la surface de la balle.

55

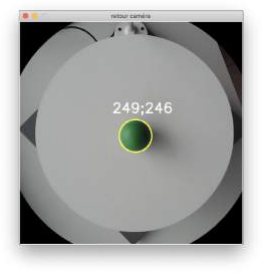
[picture p52: figure]
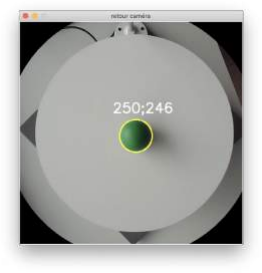
[picture p53: figure]

(a) Coordonnées mesurées (249 ;246) | (b) Coordonnées mesurées (250 ;246)

Figure 43 – Incertitude dans la mesure de la position de la balle à vitesse nulle

Ces deux captures d’écran ont été faites à moins d’une seconde d’intervalle alors que le plateau et la balle était immobile (Le système était hors tension pour être sûr que le plateau reste immobile). On peut voir que le système a mesuré deux coordonnées différentes alors que l’ensemble du système était immobile. Cela peut être dû à l’éclairage naturel qui varie en permanence et qui modifie légèrement les reflets et ombres sur la balle. De plus chaque image prise par la caméra contient du bruit numérique qui varie d’une image à l’autre ce qui perturbe la mesure des coordonnées. Le problème de ces imprécisions est que le système pense voir une balle en mouvement alors qu’elle ne l’est pas, cependant l’imprécision de la mesure est très rarement au dessus de ± 2 pixels ce qui reste acceptable. Néanmoins comme le système perçoit toujours la balle en mouvement même lorsqu’elle ne l’est pas, le système ne trouve jamais l’équilibre parfait.

### 13.3 Vitesse des servomoteurs

Le couple et la vitesse des servomoteurs sont directement liés à la tension qu’on applique à leurs bornes. Selon la fiche technique des servomoteurs qui ont été choisis pour ce projet, ils ont besoin d’au minimum 4.8 volts pour fonctionner et atteignent leur capacité maximale à 6 volts. Le système fonctionne actuellement avec une alimentation 5 volts, il serait alors possible de la remplacer par une alimentation de 6 volts pour que les servomoteurs puissent atteindre leur vitesse maximale lors des mouvements rapides du plateau.

56

### 13.4 Effet néfaste de la rotation du plateau sur la vitesse

de la balle

Lorsque le système se trouve dans la configuration de la figure suivante le plateau doit effectuer une rotation dans le sens horaire pour éviter que la balle roule et tombe du plateau. Le système a été conçu pour que le centre de rotation du plateau soit toujours au centre de celui-ci, malheureusement ce choix a un effet secondaire sur la vitesse de la balle. En effet la figure suivante montre que la rotation du plateau projette la balle vers l’extérieur du système, en d’autres termes elles est accélérée par le plateau en dehors de ce dernier.

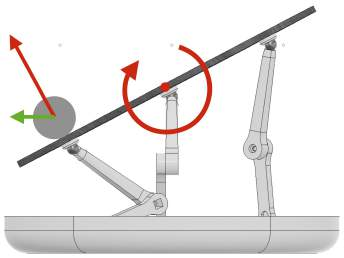
[picture p54: figure]

Figure 44 – Accélération de la balle dû à la rotation du plateau

La géométrie du mécanisme qui déplace le plateau pourrait permettre de déplacer le centre de rotation du plateau en dessous de la balle, ainsi la balle ne serait pas involontairement accélérée par les rotations du plateau qui doivent justement stabiliser la balle.

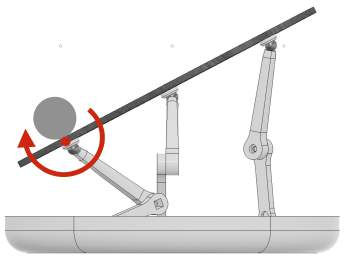
[picture p55: figure]

Figure 45 – Centre de rotation du plateau sous la balle

57

## 14 Conclusion

Pour conclure, ce travail de maturité a eu un impact positif et m’a beaucoup appris. Ce projet a été l’occasion de réaliser un projet concret qui contient une partie hardware et une partie software. Au cours de ce travail j’ai été confronté à plusieurs problèmes techniques que j’ai dû surmonter. Certains de ces problèmes ont eu lieu pendant la construction du système et d’autres problèmes sont survenus pendant la programmation du système. J’ai dû trouver des solutions quitte à devoir faire quelques concessions. La partie matérielle de ce projet est tout aussi importante que la partie informatique, en effet la modélisation et la fabrication du système m’a demandé autant de temps que la programmation de l’ensemble.
Malgré les difficultés rencontrées, le système est capable d’accomplir sa tâche comme les multiples expériences ont permis de le démontrer. La dernière section de ce travail a aussi permis de lister un certain nombre de limitations de ce système. Nous avons vu que par exemple si la balle est lancée trop rapidement le système réagira trop lentement et la bille tombera du plateau. Les expériences ont permis de trouver des combinaisons de coefficients qui ont permis de régler le régulateur PID pour que le système soit polyvalent vis-à-vis de la vitesse initiale de la balle.
Une vidéo de présentation de mon travail est disponible à l’adresse suivante :
https://www.youtube.com/watch?v=57DbEEBF7sE

58

## Bibliographie

[1] abcclim. Principe de rlation p-pi-pid, 2018 (consult juin 2018). https ://www.abcclim.net/regulation-p-pi-pid.html.
[2] Kar Anirban. Opencv object tracking by colour detection in python, 2017 (consult juin 2018). https ://thecodacus.com/opencv-object-trackingcolour-detection-python/#.W1cKZC30lp-.
[3] maike | hao. | Linux | and | python | : | auto-detect | arduino | se-
rial | port | [duplicate], | juillet | 2012 | (consult | avril | 2018).
https | ://stackoverflow.com/questions/11364879/linux-and-python-auto-
detect-arduino-serial-port.
[4] Mark. A very nonlinear system of three equations, septembre 2013 (consult avril 2018). https ://ask.sagemath.org/question/10506/a-very-nonlinearsystem-of-three-equations/.
[5] Ferdinand | Piette. | Implnter | un | pid | sans | faire
de | calculs !, | aot | 2011 | (consult | juillet | 2018).
http | ://www.ferdinandpiette.com/blog/2011/08/implementer-un-pid-
sans-faire-de-calculs/.
[6] Adrian Rosebrock. Ball tracking with opencv, septembre 2015 (consult juin 2018). https ://www.pyimagesearch.com/2015/09/14/ball-trackingwith-opencv/.
[7] The scientificsentence. Modes de rlation, 2007 (consult juillet 2018). http ://scientificsentence.net/Regulation/Regulation5.html.
[8] Sparkfun. Sparkfun atmega32u4 breakout, 2015 (consult avril 2018). https ://www.sparkfun.com/products/retired/11117.
[9] user3704293. | How | to | split | a | string | using | a | specific | de-
limiter | in | arduino ?, | avril | 2015 | (consult | juillet | 2018).
https | ://stackoverflow.com/questions/29671455/how-to-split-a-string-
using-a-specific-delimiter-in-arduino.
[10] Wikipedia. Pid controller, juillet 2018 (consult juillet 2018). https ://en.wikipedia.org/wiki/PID_controller.

59

## Table des figures

1 | Photo d’un Arduino Uno | | 6
2 | Comparaison entre un robot sériel et parallèle | | 7
3 | Comparaison entre des actionneurs linéaires et rotatifs dans un
| robot delta | | 8
4 | Exemples de plateforme de Stewart | | 9
5 | Disposition des moteurs | | 10
6 | Bras d’un moteur | | 10
7 | Vecteur ~v perpendiculaire au plateau | | 11
8 | Photo d’un servomoteur utilisé pour ce projet | | 12
9 | Capture d’écran de mon projet dans Fusion 360 | | 13
10 | Vue générale de tous les éléments du système | | 14
11 | Pièces imprimées en 3D | | 15
12 | Début de l’assemblage des pièces | | 16
13 | Capture d’écran du support de la caméra dans Fusion 360 . . . . | 17
14 | Caméra utilisée pour ce projet référence : ELP-USBFHD01M . . | 17
15 | Capture d’écran du fichier texte | | 18
16 | Schéma du circuit imprimé | | 22
17 | Circuit imprimé | | 23
18 | Soudage du microcontrôleur sur le PCB | | 24
19 | Initialisation du microcontrôleur | | 25
20 | Schéma d’un régulateur PID | | 26
21 | Vu de dessus du problème | | 31
22 | Construction de ~v | | 31
23 | Détermination de l’angle β | | 33
24 | Capture d’écran du programme intermédiaire en fonctionnement | 35
25 | Capture d’écran de l’interface graphique | | 37
26 | Retour vidéo de la caméra | | 38
27 | Graphique de la position de la balle en fonction du temps . . . . | 38
28 | Situation initiale de l’expérience | | 41
29 | Liste des coefficients utilisés dans l’expérience | | 41
30 | Exemple de graphique obtenu lors de cette expérience | | 42
31 | Extrait des résultats de l’expérience avec la balle de ping-pong.
| L’intégralité des résultats se trouve dans l’annexe A (page 63) . . | 43
32 | Extrait des résultats de la même expérience mais réalisée avec une
| balle en céramique d’une masse de 19.5 grammes. L’intégralité des
| résultats se trouve dans l’annexe B (page 67) | | 43
33 | Nouveaux essais de la combinaison P = 11 et D = 6 sur la balle
| de ping-pong | | 45
34 | Nouveaux essais de la combinaison P = 11 et D = 6 sur la balle
| en céramique | | 46
35 | Expérimentation du coefficient I sur la balle de ping-pong . . . . | 47
36 | Expérimentation du coefficient I sur la balle en céramique . . . . | 47

60

37 | Expérimentation du coefficient I lorsque le système est incliné de
| 3 degrés | | 48
38 | Schéma de l’installation utilisée pour l’expérience | | 49
39 | Extrait des résultats de l’expérience. L’intégralité des résultats se
| trouve dans l’annexe C (page 71) | | 50
40 | Comparaison de l’efficacité du régulateur selon la balle utilisée. . | 50
41 | Comparaison des résultats de la première et de la dernière expé-
| riences avec la combinaison P = 13 et D = 6 | | 52
42 | Mesure du temps de détection de la balle par le système | | 54
43 | Incertitude dans la mesure de la position de la balle à vitesse nulle 56
44 | Accélération de la balle dû à la rotation du plateau | | 57
45 | Centre de rotation du plateau sous la balle | | 57

61

# Annexes

62

A Résultats de la section 11.1.3

Résultats de l’expérience sur l’effet des coefficients P et D sur la stabilisation d’une balle de ping-pong. Pour rappel les graphiques présentent les coordonnées de la balle en fonction du temps sur un intervalle de dix secondes. La courbe verte correspond aux coordonnées de la balle sur l’axe des ordonnées et la courbe bleu correspond aux coordonnées de la balle sur l’axe des abscisses. Les graphiques dont les courbes s’arrêtent avant 10 secondes montrent que la balle a chuté du plateau.

63

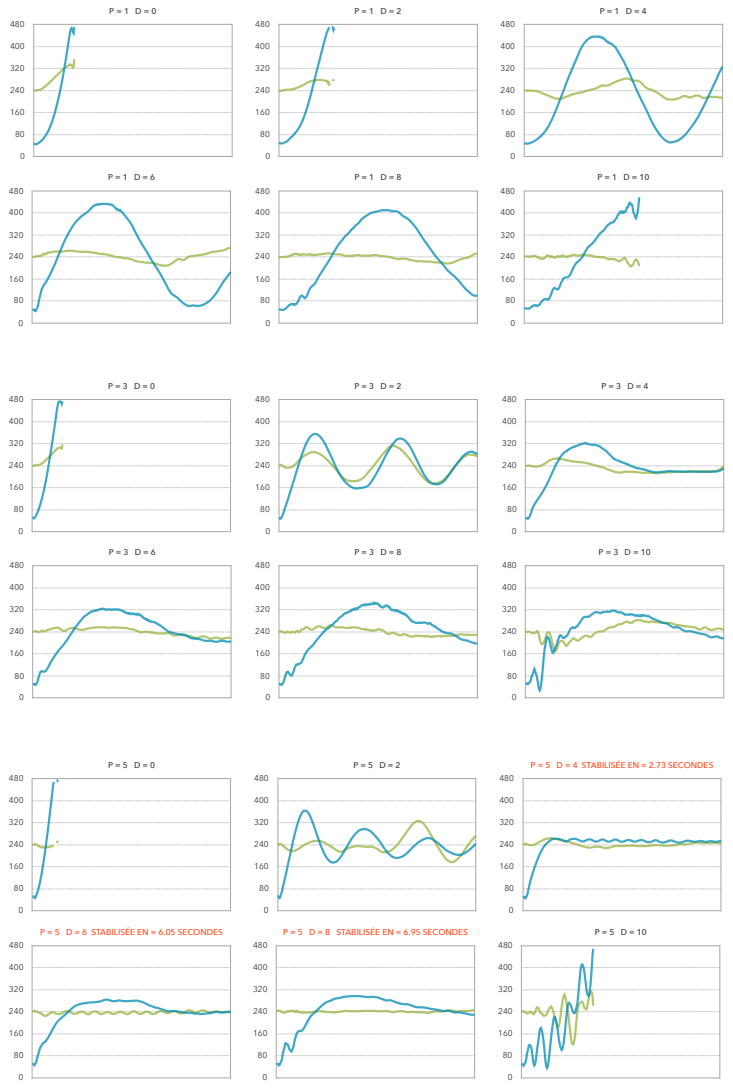
[picture p56: page 66]

P = 5 D = 4 STABILISÉE EN = 2.73 SECONDES

P = 5 D = 6 STABILISÉE EN = 6.05 SECONDES

P = 5 D = 8 STABILISÉE EN = 6.95 SECONDES

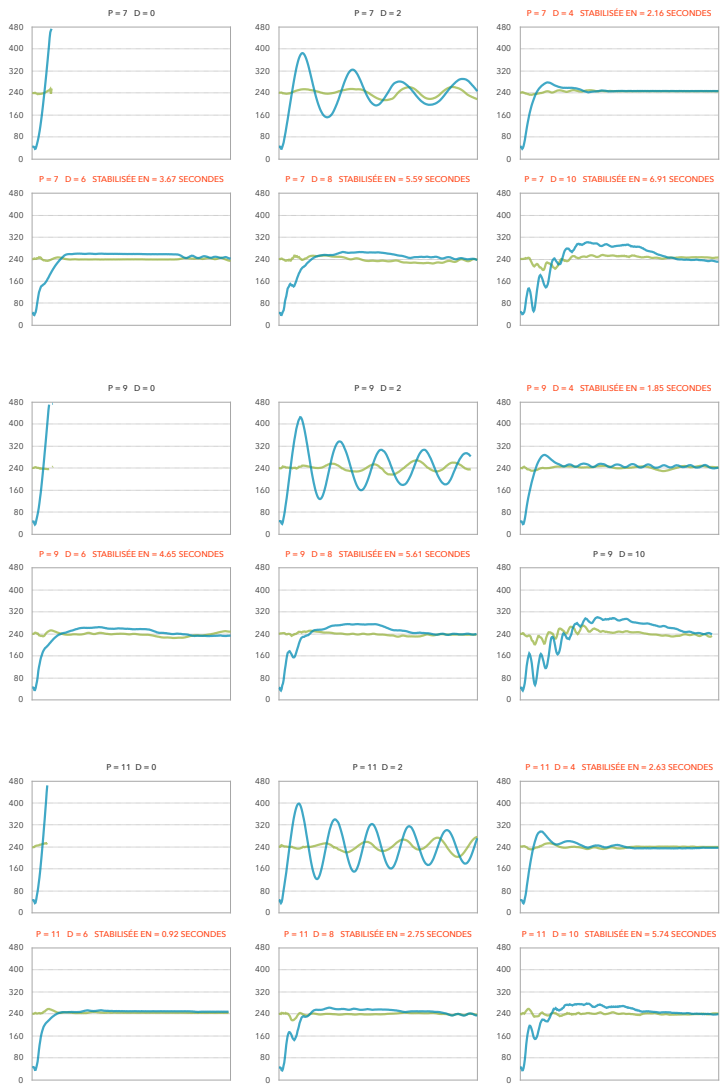
[picture p57: page 67]
P = 7 D = 6 STABILISÉE EN = 3.67 SECONDES; P = 7 D = 8 STABILISÉE EN = 5.59 SECONDES; P = 7 D = 10 STABILISÉE EN = 6.91 SECONDES; P = 9 D = 6 STABILISÉE EN = 4.65 SECONDES; P = 9 D = 8 STABILISÉE EN = 5.61 SECONDES

P = 7 D = 4 STABILISÉE EN = 2.16 SECONDES

P = 9 D = 4 STABILISÉE EN = 1.85 SECONDES

P = 11 D = 4 STABILISÉE EN = 2.63 SECONDES

P = 11 D = 6 STABILISÉE EN = 0.92 SECONDES

P = 11 D = 8 STABILISÉE EN = 2.75 SECONDES

P = 11 D = 10 STABILISÉE EN = 5.74 SECONDES

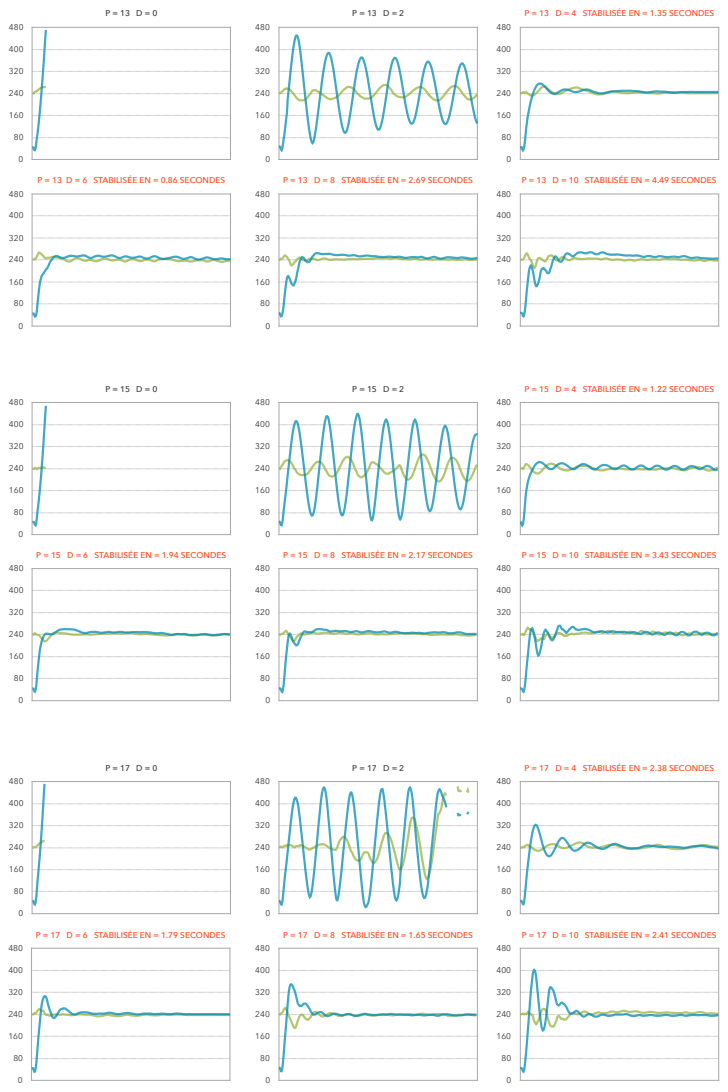
[picture p58: page 68]
P = 15 D = 6 STABILISÉE EN = 1.94 SECONDES; P = 15 D = 8 STABILISÉE EN = 2.17 SECONDES; P = 15 D = 10 STABILISÉE EN = 3.43 SECONDES

P = 13 D = 4 STABILISÉE EN = 1.35 SECONDES

P = 13 D = 6 STABILISÉE EN = 0.86 SECONDES

P = 13 D = 8 STABILISÉE EN = 2.69 SECONDES

P = 13 D = 10 STABILISÉE EN = 4.49 SECONDES

P = 15 D = 4 STABILISÉE EN = 1.22 SECONDES

P = 17 D = 4 STABILISÉE EN = 2.38 SECONDES

P = 17 D = 6 STABILISÉE EN = 1.79 SECONDES

P = 17 D = 8 STABILISÉE EN = 1.65 SECONDES

P = 17 D = 10 STABILISÉE EN = 2.41 SECONDES

B Suite des résultats de la section 11.1.3

Résultats de l’expérience sur l’effet des coefficients P et D sur la stabilisation d’une balle en céramique. Pour rappel les graphiques présentent les coordonnées de la balle en fonction du temps sur un intervalle de dix secondes. La courbe verte correspond aux coordonnées de la balle sur l’axe des ordonnées et la courbe bleu correspond aux coordonnées de la balle sur l’axe des abscisses. Les graphiques dont les courbes s’arrêtent avant 10 secondes montrent que la balle a chuté du plateau.

67

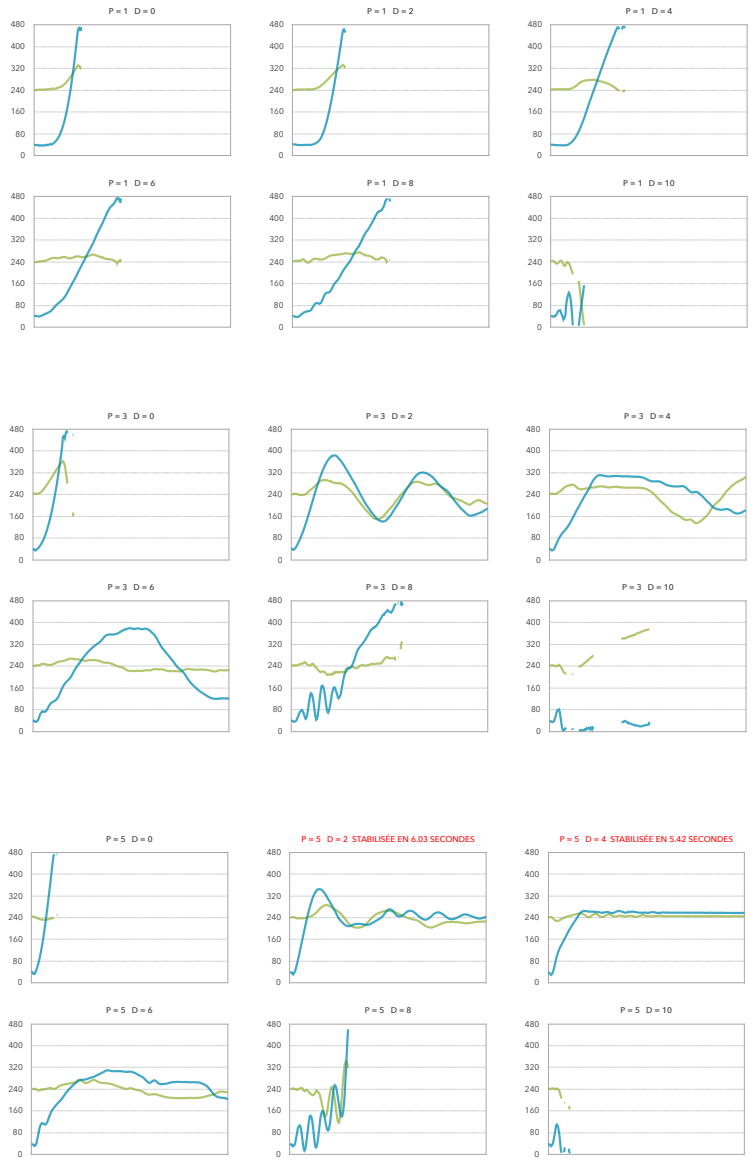
[picture p59: page 70]

P = 5 D = 2 STABILISÉE EN 6.03 SECONDES

P = 5 D = 4 STABILISÉE EN 5.42 SECONDES

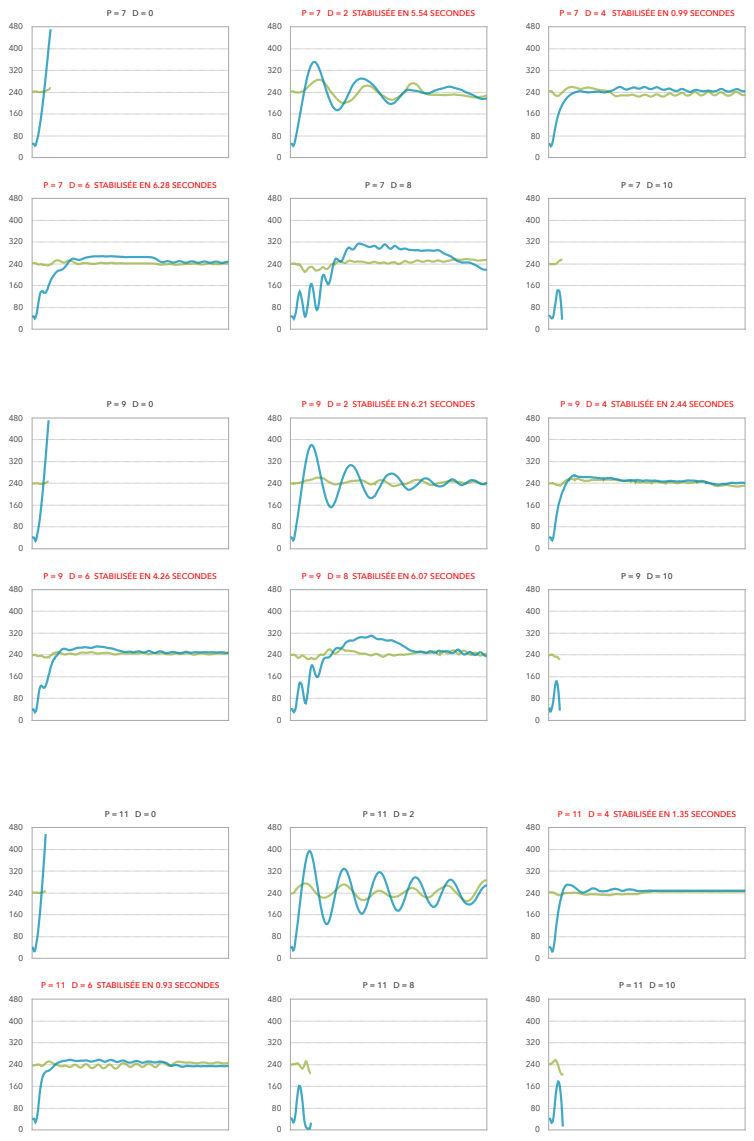
[picture p60: page 71]

P = 7 D = 2 STABILISÉE EN 5.54 SECONDES

P = 7 D = 4 STABILISÉE EN 0.99 SECONDES

P = 7 D = 6 STABILISÉE EN 6.28 SECONDES

P = 9 D = 2 STABILISÉE EN 6.21 SECONDES

P = 9 D = 4 STABILISÉE EN 2.44 SECONDES

P = 9 D = 6 STABILISÉE EN 4.26 SECONDES

P = 9 D = 8 STABILISÉE EN 6.07 SECONDES

P = 11 D = 4 STABILISÉE EN 1.35 SECONDES

P = 11 D = 6 STABILISÉE EN 0.93 SECONDES

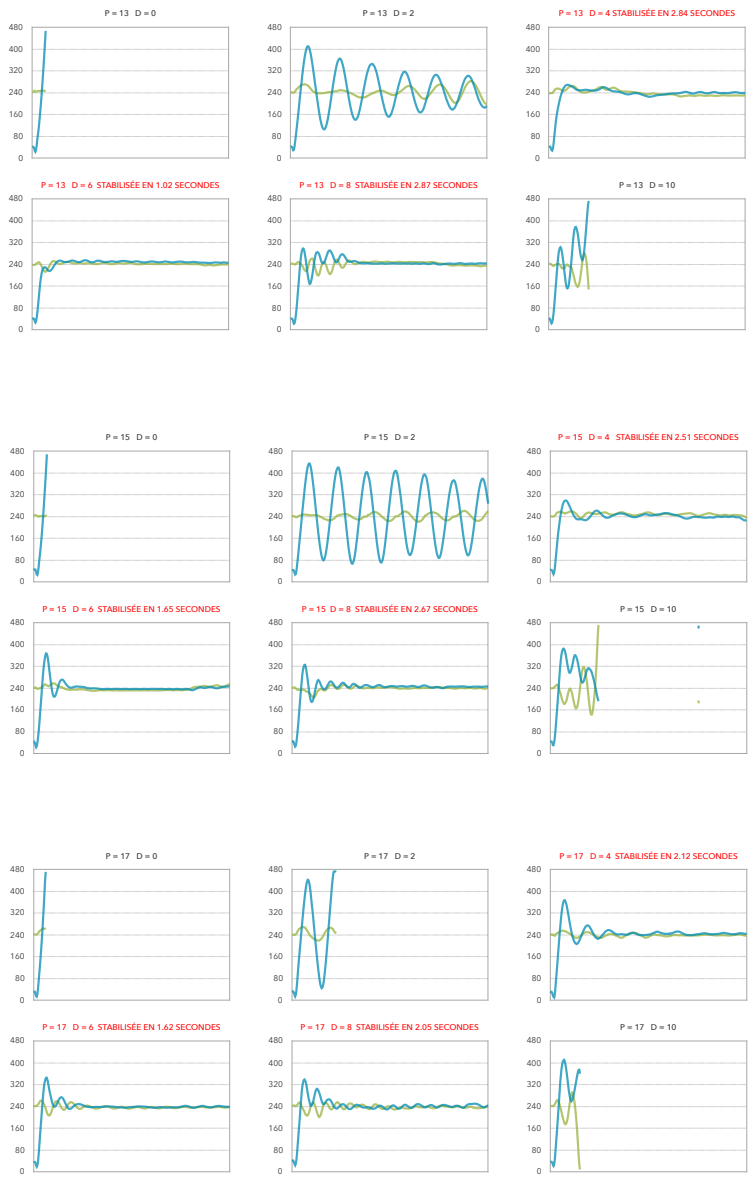
[picture p61: page 72]

P = 13 D = 4 STABILISÉE EN 2.84 SECONDES

P = 13 D = 6 STABILISÉE EN 1.02 SECONDES

P = 13 D = 8 STABILISÉE EN 2.87 SECONDES

P = 15 D = 4 STABILISÉE EN 2.51 SECONDES

P = 15 D = 6 STABILISÉE EN 1.65 SECONDES

P = 15 D = 8 STABILISÉE EN 2.67 SECONDES

P = 17 D = 4 STABILISÉE EN 2.12 SECONDES

P = 17 D = 6 STABILISÉE EN 1.62 SECONDES

P = 17 D = 8 STABILISÉE EN 2.05 SECONDES

C Résultats de la section 11.3.1

Résultats de l’expérience sur l’effet des coefficients P et D sur la stabilisation d’une balle en céramique et d’une balle de ping-pong dont la vitesse initiale est non nulle. Pour rappel les graphiques présentent les coordonnées de la balle en fonction du temps sur un intervalle de dix secondes. La courbe bleue correspond aux coordonnées de la balle de ping-pong sur l’axe des abscisses. La courbe verte correspond aux coordonnées de la balle en céramique sur l’axe des abscisses.

71

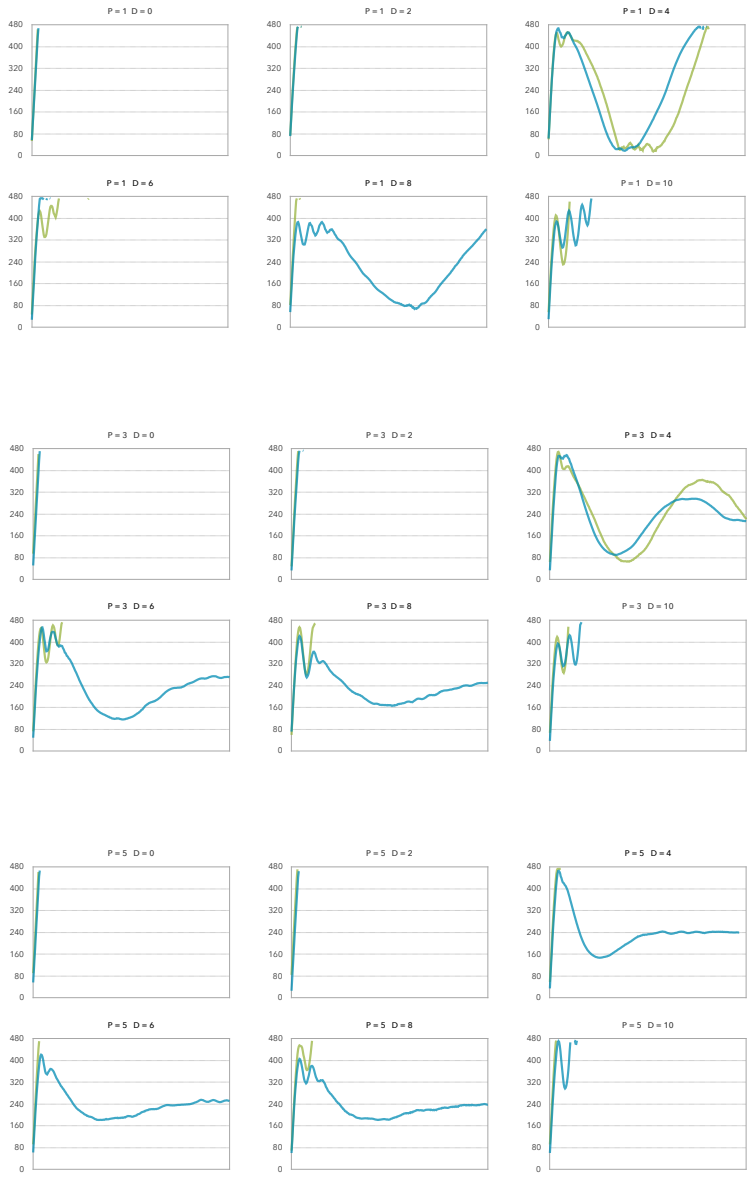
[picture p62: page 74]

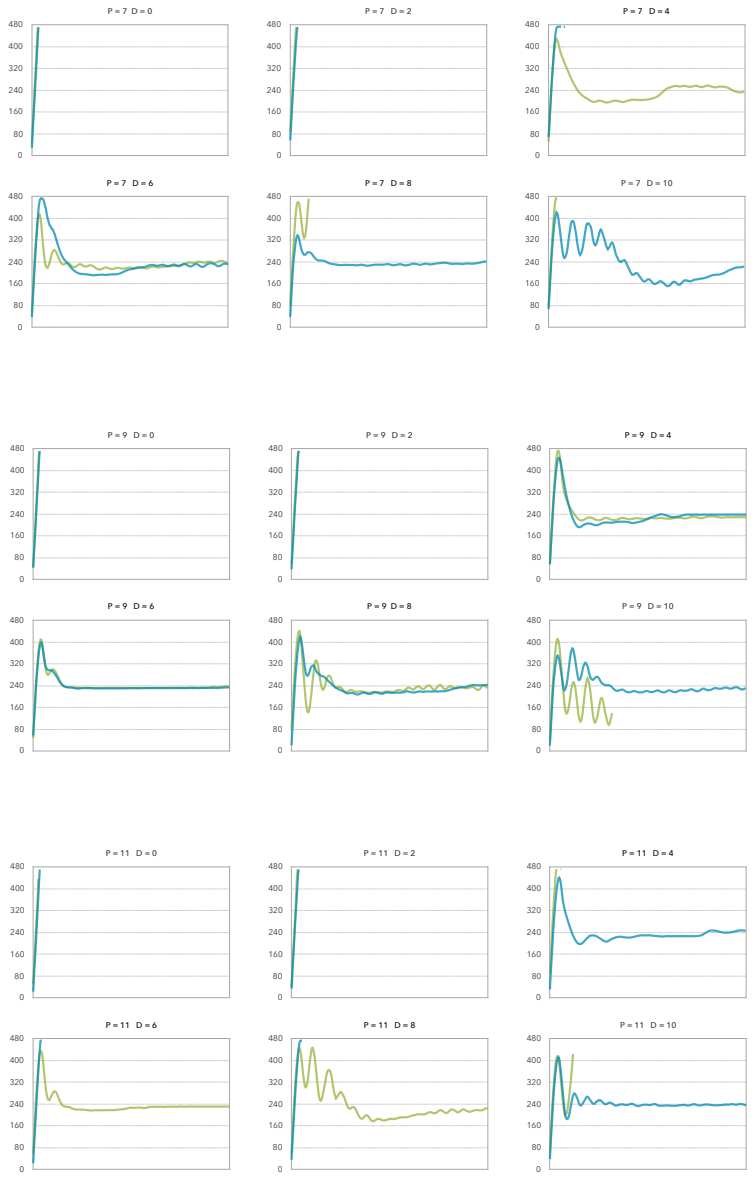
[picture p63: page 75]

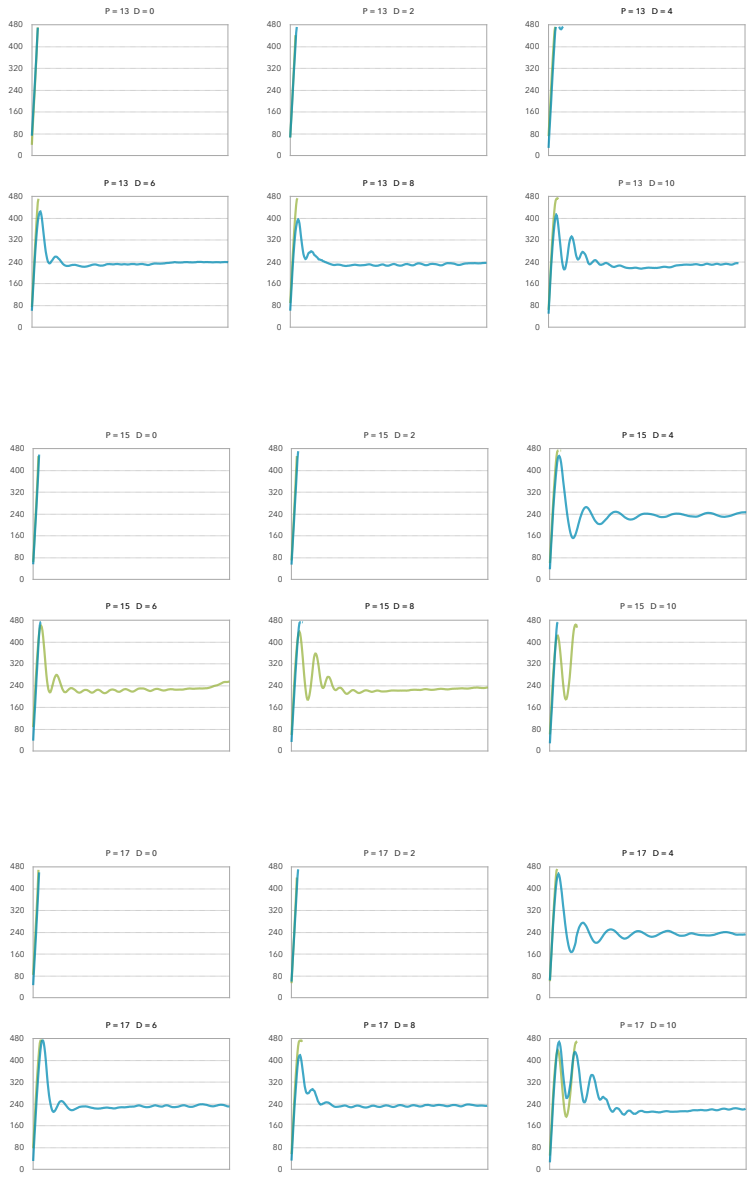
[picture p64: page 76]

D solveEquation.py

1 | from s ci p y . o p timi z e import f s o l v e
2 | from math import ∗
3
4
5 | # v a l e u r s en cm
6 | L = 8. 5 | # di s t a n c e e n t r e un moteur e t l ’ o r i g i n e
7 | d = 1 1. 5 | # h au teu r a l a q u e l l e l e pl a t e a u s e s i t u e par
r a p p o r t a l ’ o r i g i n e
8 | D = 18 | # di s t a n c e e n t r e l e bout de s t r o i s b r a s de s moteurs
9 | r , l = 7 , 8. 5 | # r e s t l a l o n g u e u r de l a p r emi e r e p a r t i e qui
compose un bras , l e s t l a l o n g u e u r de l a deuxieme p a r t i e ( c e l l e s u r l a q u e l l e s e t r o u v e l a b i l l e qui e s t en c o n t a c t avec l e
| pl a t e a u )
10
11
12 p ri n t ( " . . . " )
13
14 | alph a = 0
15 | be t a = 0
16 | d e f equationsKMT ( p ) :
17 | k , m, t = p
18 | e q u a ti o n 1 = (−c o s ( alph a ) ∗ c o s ( pi / 6 ) ∗k ) ∗∗2 + (−c o s ( alph a ) ∗m−c o s (
alph a ) ∗ s i n ( pi / 6 ) ∗k ) ∗∗2 + ( s i n ( be t a ) ∗ s i n ( alph a ) ∗m+c o s ( pi / 6 ) ∗ c o s ( be t a ) ∗ s i n ( alph a ) ∗k+s i n ( be t a ) ∗ s i n ( alph a ) ∗ s i n ( pi / 6 ) ∗k ) ∗∗2
| − 1
19 | e q u a ti o n 2 = (−c o s ( alph a ) ∗ c o s ( pi / 6 ) ∗ t ) ∗∗2 + ( c o s ( alph a ) ∗ s i n ( pi
/ 6 ) ∗ t+c o s ( alph a ) ∗m) ∗∗2 + ( c o s ( be t a ) ∗ s i n ( alph a ) ∗ c o s ( pi / 6 ) ∗t− s i n ( be t a ) ∗ s i n ( alph a ) ∗ s i n ( pi / 6 ) ∗t−s i n ( be t a ) ∗ s i n ( alph a ) ∗m) ∗∗2
| − 1
20 | e q u a ti o n 3 = ( c o s ( alph a ) ∗ c o s ( pi / 6 ) ∗k+c o s ( alph a ) ∗ c o s ( pi / 6 ) ∗ t ) ∗∗2
+ ( c o s ( alph a ) ∗ s i n ( pi / 6 ) ∗k−c o s ( alph a ) ∗ s i n ( pi / 6 ) ∗ t ) ∗∗2 + (−
c o s ( pi / 6 ) ∗ c o s ( be t a ) ∗ s i n ( alph a ) ∗k−s i n ( be t a ) ∗ s i n ( alph a ) ∗ s i n ( pi / 6 ) ∗k−c o s ( be t a ) ∗ s i n ( alph a ) ∗ c o s ( pi / 6 ) ∗ t+s i n ( be t a ) ∗ s i n ( alph a ) ∗ s i n ( pi / 6 ) ∗ t ) ∗∗2 − 1
21 | r e t u r n ( equ a ti on 1 , equ a ti on 2 , e q u a ti o n 3 )
22
23 | d e f getMaxMinPoint ( ) : #r e t o u r n e l e p oi n t l e pl u s haut e t l e p oi n t
| l e pl u s bas
24 | distanceMax = 0
25 | di s t anceMin = 100000
26 | f o r be t a i n r an ge ( 0 , 3 6 1 ) :
27 | be t a = r a di a n s ( be t a )
28 | f o r alph a i n r an ge ( 0 , 3 6 ) :
29 | | alph a = r a di a n s ( alph a )
30 | | k ,m, t = f s o l v e ( equationsKMT , ( 1 , 1 , 1 ) )
31 | | k ,m, t = −D∗k , −D∗m, −D∗ t
32 | | Xa, Ya, Za = k∗ c o s ( alph a ) ∗ c o s ( pi / 6 ) , k∗ c o s ( alph a ) ∗ s i n (
| | pi / 6 ) , k∗(− c o s ( pi / 6 ) ∗ c o s ( be t a ) ∗ s i n ( alph a )−s i n ( be t a )
| | ∗ s i n ( alph a ) ∗ s i n ( pi / 6 ) )+d
33
34 | #
| | t r o u v e r l e p oi n t l e pl u s e l o i g n e e t l e pl u s p r oche
| | du moteur
35 | | i f Za >= distanceMax :

75

36 | distanceMax = | s q r t ( ( s q r t (Xa∗∗2 + Ya∗ ∗2 )−L) ∗∗2 + Za
| ∗ ∗2 )
37 | XaMax = Xa
38 | YaMax = Ya
39 | ZaMax = Za
40
41 | e l i f Za <= di s t anceMin :
42 | di s t anceMin = | s q r t ( ( s q r t (Xa∗∗2 + Ya∗ ∗2 )−L) ∗∗2 + Za
| ∗ ∗2 )
43 | XaMin = Xa
44 | YaMin = Ya
45 | ZaMin = Za
46
47 | r e t u r n (XaMax, YaMax, ZaMax , XaMin , YaMin , ZaMin )
48
49 d e f equationsRL ( p ) : # systeme d ’ e q u a ti o n pour t r o u v e r l e s l o n g u e u r s r e t l
50 | xmax , ymax , zmax , xmin , ymin , zmin = getMaxMinPoint ( )
51 | p r i n t ( p )
52 | r , l = p
53 | e q u a ti o n 1 = ( s q r t ( ( xmin ) ∗∗2 + ( ymin ) ∗ ∗2 )−L+c o s ( r a di a n s ( 0 ) ) ∗ r )
∗∗2 + ( zmin−s i n ( r a di a n s ( 0 ) ) ∗ r ) ∗∗2 − l ∗∗2
54 | e q u a ti o n 2 = ( s q r t ( ( xmax ) ∗∗2 + ( ymax ) ∗ ∗2 )−L+c o s ( r a di a n s ( 9 0 ) ) ∗ r )
∗∗2 + ( zmax−s i n ( r a di a n s ( 9 0 ) ) ∗ r ) ∗∗2 − l ∗∗2
55 | r e t u r n ( equ a ti on 1 , e q u a ti o n 2 )
56
57 | d e f e qu a ti onTe t a ( t e t a , ∗ p o i n t s P o s i t i o n ) :
58 | x , y , z = p o i n t s P o s i t i o n
59 | r e t u r n ( ( L−c o s ( t e t a ) ∗r−s q r t ( x∗∗2+y ∗ ∗2 ) ) ∗∗2 + ( s i n ( t e t a ) ∗r−z )
∗ ∗2 ) − l ∗∗2 | #### L + c o s pour b r a s o r i e n t e v e r s l ’
e x t e r i e u r e t L − c o s pour o r i e n t e v e r s l ’ i n t e r i e u r
60
61 | #r , l = f s o l v e ( equationsRL , ( 9 , 8 ) )
62 | #r , l = 9. 0 5 6 2 5 , 8. 2 8 4 5 9
63
64 | f i c h i e r = open ( "/ U se r s / j o h a nli n k / Desktop/TM/python/ data . t x t " , "w" )
| #l e f i c h i e r t x t e s t e c r a s e
65 | p r emi e r eLi g n e = " alph a | be t a | AngleservoA | AngleservoB | AngleservoC\n"
66 | f i c h i e r . w ri t e ( p r emi e r eLi g n e )
67
68
69 | maxPos = 0
70 | minPos = 1000
71 | nbProbleme = 0
72 | minMotorAngle = 100000
73 | maxMotorAngle = 0
74
75 | f o r be t a i n r an ge ( 0 , 360∗5+1) :
76 | be t a = r a di a n s ( be t a ) /5
77 | f o r alph a i n r an ge ( 0 , 35∗5+1) :
78 | alph a = r a di a n s ( alph a ) /5
79 | k ,m, t = f s o l v e ( equationsKMT , ( 1 , 1 , 1 ) )
80 | k ,m, t = −D∗k , −D∗m, −D∗ t
81 | Xa, Ya, Za = k∗ c o s ( alph a ) ∗ c o s ( pi / 6 ) , k∗ c o s ( alph a ) ∗ s i n ( pi / 6 )
, k∗(− c o s ( pi / 6 ) ∗ c o s ( be t a ) ∗ s i n ( alph a )−s i n ( be t a ) ∗ s i n (
| alph a ) ∗ s i n ( pi / 6 ) )+d
82 | Xb, Yb, Zb = 0 , m∗(− c o s ( alph a ) ) , m∗ s i n ( be t a ) ∗ s i n ( alph a )+d

76

83 | Xc , Yc , Zc = t ∗(− c o s ( alph a ) ∗ c o s ( pi / 6 ) ) , t ∗ c o s ( alph a ) ∗ s i n ( pi
/ 6 ) , t ∗( c o s ( be t a ) ∗ s i n ( alph a ) ∗ c o s ( pi / 6 )−s i n ( be t a ) ∗ s i n ( alph a ) ∗ s i n ( pi / 6 ) )+d
84 | tetaA = d e g r e e s ( f s o l v e ( equa tionTe ta , 1 , a r g s =(Xa, Ya, Za ) ) )
85 | tetaB = d e g r e e s ( f s o l v e ( equa tionTe ta , 1 , a r g s =(Xb, Yb, Zb ) ) )
86 | tetaC = d e g r e e s ( f s o l v e ( equa tionTe ta , 1 , a r g s =(Xc , Yc , Zc ) ) )
87 | tetaA = round ( tetaA , 2 )
88 | tetaB = round ( tetaB , 2 )
89 | tetaC = round ( tetaC , 2 )
90
91 | s e p a r a t e u r = " | "
92 | data = s t r ( round ( d e g r e e s ( alph a ) , 2 ) ) + | s e p a r a t e u r + s t r (
round ( d e g r e e s ( be t a ) , 2 ) ) + "#" + s t r ( tetaA ) + s e p a r a t e u r + s t r ( tetaB ) + s e p a r a t e u r + s t r ( tetaC ) + "\n"
93 | f i c h i e r . w ri t e ( data )
94
95 | i f tetaA > maxMotorAngle :
96 | maxMotorAngle = tetaA
97 | angleMaxPoint = (Xa, Ya, Za )
98
99 | i f tetaA < minMotorAngle :
100 | minMotorAngle = tetaA
101 | angleMinPoin t = (Xa, Ya, Za )
102
103
104
105 i n f o s = "\ nDi s t ance ␣L␣ e n t r e ␣ s e r v o ␣ e t ␣ o r i g i n e : "+s t r (L)+"\nHauteur␣d␣ du␣ pl a t e a u : "+s t r ( d )+"\ nDi s t ance ␣D␣ e n t r e ␣ l e s ␣ p oi n t s ␣A,B,C: "+s t r ( D)+"\nLongueur␣ r ␣du␣ b r a s ␣du␣ s e r v o : "+s t r ( r )+"\nLongueur␣ l ␣du␣
| b r a s ␣du␣ s e r v o : "+s t r ( l )
106 | minmaxAngle = "\nminMotorAngle␣=␣" + s t r ( minMotorAngle ) + "\
| nmaxMotorAngle␣=␣" + s t r ( maxMotorAngle )
107 | XaMax, YaMax, ZaMax , XaMin , YaMin , ZaMin = getMaxMinPoint ( )
108 | minmaxPos = "\ nl e ␣ p oi n t ␣ l e ␣ pl u s ␣ p r oche ␣du␣ s e r v o : "+s t r (XaMin )+"␣␣␣␣"
+s t r (YaMin )+"␣␣␣␣"+s t r ( ZaMin )+"\ nl e ␣ p oi n t ␣ l e ␣ pl u s ␣ e l o i g n e ␣du␣ s e r v o : "+s t r ( )+s t r (XaMax)+"␣␣␣␣"+s t r (YaMax)+"␣␣␣␣"+s t r (ZaMax)
109 | f i c h i e r . w ri t e ( "\n" )
110 | f i c h i e r . w ri t e ( " v a l e u r s ␣en␣cm" )
111 | f i c h i e r . w ri t e ( i n f o s )
112 | f i c h i e r . w ri t e ( minmaxAngle )
113 | f i c h i e r . w ri t e (minmaxPos )
114
115 f i c h i e r . c l o s e ( )
116
117 p ri n t ( "Termine" )

77

E programmeIntermediaire.py

1 | import cv2
2 | import numpy a s np
3 | import time
4 | import i m u t i l s
5
6 | cam = cv2 . VideoCapture ( 0 )
7 | cv2 . namedWindow ( "image" )
8
9 | cam . s e t ( 3 , 3 2 0 )
10 | cam . s e t ( 4 , 2 4 0 )
11
12 | g e t Pi x el C ol o r = F al s e
13 | H, S ,V = 0 , 0 , 0
14
15 mouseX , mouseY = 0 , 0
16
17 | d e f ge tM ou seP o si ti onOnClick ( event , x , y , f l a g s , param ) :
18 | g l o b a l mouseX , mouseY
19 | g l o b a l g e t Pi x el C ol o r
20 | i f e ven t == cv2 .EVENT_LBUTTONDOWN:
21 | mouseX , mouseY = x , y
22 | g e t Pi x el C ol o r = True
23 | p ri n t ( g e t Pi x el C ol o r )
24 | e l i f e ven t == cv2 .EVENT_LBUTTONUP:
25 | g e t Pi x el C ol o r = F al s e
26
27
28 cv2 . se tM ou seC allb ack ( "image" , ge tM ou seP o si ti onOnClick ) 29
30 | w hil e True :
31 | s t a r t_ time = time . time ( )
32 | r e t , img=cam . re ad ( )
33 | imgHSV= cv2 . c v tC ol o r ( img , cv2 .COLOR_BGR2HSV)
34
35 | i f g e t Pi x el C ol o r == True :
36 | pi x elC ol o rO nCli c k = img [ mouseY , mouseX ]
37 | pi x elC ol o rO nCli c k = np . ui n t 8 ( [ [ pi x elC ol o rO nCli c k ] ] )
38 | pi x elC ol o rO nCli c k = cv2 . c v tC ol o r ( pi x elC ol o rO nCli c k , cv2 .
| COLOR_BGR2HSV)
39 | H = pi x elC ol o rO nCli c k [ 0 , 0 , 0 ]
40 | S = pi x elC ol o rO nCli c k [ 0 , 0 , 1 ]
41 | V = pi x elC ol o rO nCli c k [ 0 , 0 , 2 ]
42 | p ri n t (H, S , V, mouseX , mouseY )
43
44 | lowerBound=np . a r r a y ( [ H−7,S−70,V−70])
45 | upperBound=np . a r r a y ( [H+7,S+70,V+70])
46
47 | mask=cv2 . inRange (imgHSV , lowerBound , upperBound )
48 | mask = cv2 . bl u r (mask , ( 7 , 7 ) ) | # a j o u t e du
| f l o u a l ’ image
49 | mask = cv2 . e r o d e (mask , None , i t e r a t i o n s =2) | # r e t i r e l e s
| p a r a s i t e s
50 | mask = cv2 . d i l a t e (mask , None , i t e r a t i o n s =2) | # r e t i r e l e s
| p a r a s i t e s
51

78

52 | c n t s = cv2 . fi n dC o n t o u r s (mask . copy ( ) , cv2 .RETR_EXTERNAL, cv2 .
| CHAIN_APPROX_SIMPLE)
53 | c n t s = c n t s [ 0 ] i f i m u t i l s . is_cv2 ( ) e l s e c n t s [ 1 ]
54 | c e n t e r = None
55
56 | i f l e n ( c n t s ) > 0 :
57 | c = max( cn t s , key=cv2 . con tou rA rea )
58 | ( x , y ) , r a di u s = cv2 . mi n E n cl o si n g Ci r cl e ( c )
59
60 | i f r a di u s > 2 :
61 | cv2 . c i r c l e ( img , ( i n t ( x ) , i n t ( y ) ) , i n t ( r a di u s ) , ( 0 , 2 5 5 ,
| 2 5 5 ) , 2 )
62
63 | cv2 . imshow ( "mask" ,mask )
64 | cv2 . imshow ( "image" , img )
65 | cv2 . waitKey ( 1 0 )
66 | p r i n t ( "FPS : ␣" , 1. 0 / ( time . time ( ) − s t a r t_ tim e ) )

79

F interface.py

1 | import cv2
2 | import numpy a s np
3 | import time
4 | import i m u t i l s
5 | import t k i n t e r a s tk
6 | import t k i n t e r . messagebox
7 | from PIL import Image , ImageTk
8 | import s e r i a l
9 | import s e r i a l . t o o l s . l i s t _ p o r t s
10 | from math import ∗
11
12
13 l i n e s = open ( "/ U se r s / j o h a nli n k / Desktop/TM/python/ data . t x t " ) . re ad ( ) . s p l i t l i n e s ( )
14 | l i n e s = l i n e s [: −1 1] | #e nl e v e l e s 11 d e r n i e r e s l i g n e s du f i c h i e r
15 | l i n e s = l i n e s [ 1 : ] | #e nl e v e l a p r emi e r e l i g n e du f i c h i e r
16
17 d a t aDic t = {}
18
19 | camHeight = 480
20 | camWidth = 640
21 | cam = cv2 . VideoCapture ( 0 )
22 | cam . s e t ( 3 , camWidth )
23 | cam . s e t ( 4 , camHeight )
24
25 | g e t Pi x el C ol o r = F al s e
26 | H, S ,V = 0 , 0 , 0
27
28 mouseX , mouseY = 0 , 0
29
30 | f o r i i n r an ge ( 0 , l e n ( l i n e s ) ) :
31 | key , v al u e = l i n e s [ i ] . s p l i t ( "#" )
32 | alpha , be t a = key . s p l i t ( " | " )
33 | angleA , angleB , angleC = v al u e . s p l i t ( " | " )
34 | d a t aDic t [ ( f l o a t ( alph a ) , f l o a t ( be t a ) ) ] = ( f l o a t ( angleA ) , f l o a t (
angleB ) , f l o a t ( angleC ) ) 35
36 | c on t r olle rWind ow = tk . Tk ( )
37 | c on t r olle rWind ow . t i t l e ( " f e n e t r e ␣de␣ c o n t r o l e " )
38 | c on t r olle rWind ow . geometry ( "820 x500" )
39 | c on t r olle rWind ow [ "bg"]=" whi te "
40 | c on t r olle rWind ow . r e s i z a b l e ( 0 , 0 )
41
42 | videoWindow = tk . T o pl e v el ( c on t r olle rWind ow )
43 | videoWindow . t i t l e ( " r e t o u r ␣camera" )
44 | videoWindow . r e s i z a b l e ( 0 , 0 ) | #empeche de m o di fi e r l e s dimen si on s de
l a f e n e t r e
45 | lmain = tk . Label ( videoWindow )
46 | lmain . pack ( )
47 | videoWindow . withdraw ( )
48
49 | graphWindow = tk . T o pl e v el ( c on t r olle rWind ow )
50 | graphWindow . t i t l e ( " P o si ti o n ␣en␣ f o n c t i o n ␣du␣temps" )
51 | graphWindow . r e s i z a b l e ( 0 , 0 )
52 | graphCanvas = tk . Canvas ( graphWindow , width=camHeight +210, h ei g h t=

80

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

81

105 | p oi n t = p o i n t s L i s t C i r c l e [ p oin tC oun te r ]
106 | consigneX , consigneY = p oi n t [ 0 ] , p oi n t [ 1 ]
107 | p oin tC oun te r += 7
108 | i f drawEightBool == True :
109 | sli d e r C o e f P . s e t ( 1 5 )
110 | i f p oin tC oun te r >= l e n ( p o i n t s L i s t E i g h t ) :
111 | p oin tC oun te r = 0
112 | p oi n t = p o i n t s L i s t E i g h t [ p oin tC oun te r ]
113 | consigneX , consigneY = p oi n t [ 0 ] , p oi n t [ 1 ]
114 | p oin tC oun te r += 7
115
116
117 | d e f setConsigneWithMouse ( m ou seP o si ti on ) :
118 | g l o b a l consigneX , consigneY
119 | i f m ou seP o si ti on . y > 1 0:
120 | r e f r e s hG r a p h ( )
121 | consigneX , consigneY = m ou seP o si ti on . x , m ou seP o si ti on . y
122
123
124 | d e f g e tM o u s e Cli c k P o si ti o n ( m ou seP o si ti on ) :
125 | g l o b a l mouseX , mouseY
126 | g l o b a l g e t Pi x el C ol o r
127 | mouseX , mouseY = m ou seP o si ti on . x , m ou seP o si ti on . y
128 | g e t Pi x el C ol o r = True
129
130 | showVideoWindow = F al s e
131 | d e f showCameraFrameWindow ( ) :
132 | g l o b a l showVideoWindow , showGraph
133 | g l o b a l BRetourVideoTxt
134 | i f showVideoWindow == F al s e :
135 | i f showGraph == True :
136 | graphWindow . withdraw ( )
137 | showGraph = F al s e
138 | B a f fi c h e rG r a p h [ " t e x t " ] = " A f f i c h e r ␣ g r aphi que "
139 | videoWindow . d e i c o n i f y ( )
140 | showVideoWindow = True
141 | BRetourVideo [ " t e x t " ] = "Cacher ␣ l e ␣ r e t o u r ␣ vi d e o ␣"
142 | e l s e :
143 | videoWindow . withdraw ( )
144 | showVideoWindow = F al s e
145 | BRetourVideo [ " t e x t " ] = " A f f i c h e r ␣ l e ␣ r e t o u r ␣ vi d e o "
146
147 | s h owC al queC alib r a ti onB o ol = F al s e
148 | d e f s h owC al q u eC ali b r a ti o n ( ) :
149 | g l o b a l sh owC al qu eC alib r a ti onB o ol
150 | sh owC al q ueC alib r a ti onB o ol = not sh owC al qu eC ali b r a ti onB o ol
151
152 | showGraph = F al s e
153 | d e f showGraphWindow ( ) :
154 | g l o b a l showGraph , showVideoWindow
155 | g l o b a l B a f fi c h e rG r a p h
156
157 | i f showGraph == F al s e :
158 | i f showVideoWindow == True :
159 | videoWindow . withdraw ( )
160 | showVideoWindow = F al s e
161 | BRetourVideo [ " t e x t " ] = " A f f i c h e r ␣ l e ␣ r e t o u r ␣ vi d e o "

82

162 | showGraph = True
163 | B a f fi c h e rG r a p h [ " t e x t " ] = "Cacher ␣ g r aphi que ␣"
164 | e l s e :
165 | showGraph = F al s e
166 | B a f fi c h e rG r a p h [ " t e x t " ] = " A f f i c h e r ␣ g r aphi que "
167
168 | t = 480
169 | consigneY = 240
170 | consigneX = 240
171 | d e f paintGraph ( ) :
172 | g l o b a l t , consigneY , x , y , prevX , prevY , alpha , prevAlpha
173 | g l o b a l showGraphPositionX , showGraphPositionY , showGraphAlpha
174 | i f showGraph == True :
175 | graphWindow . d e i c o n i f y ( )
176 | i f showGraphPositionX . g e t ( ) == 1 :
177 | graphCanvas . c r e a t e _li n e ( t −3,prevX , t , x , | f i l l ="#b20000 " ,
| width=2)
178 | i f showGraphPositionY . g e t ( ) == 1 :
179 | graphCanvas . c r e a t e _li n e ( t −3,prevY , t , y , | f i l l ="#0069b5" ,
| width=2)
180 | i f showGraphAlpha . g e t ( ) == 1 :
181 | graphCanvas . c r e a t e _li n e ( t −3,240−prevAlpha ∗3 , t ,240− alph a
| ∗3 , f i l l ="#8f 0 c a f " , width=2)
182 | i f t >= 4 8 0:
183 | t = 0
184 | graphCanvas . d e l e t e ( " a l l " )
185 | graphCanvas . c r e a t e _li n e ( 3 , 3 , 4 8 0 , 3 , f i l l =" bl a c k " , width
| =3)
186 | graphCanvas . c r e a t e _li n e ( 3 , 4 8 0 , 4 8 0 , 4 8 0 , f i l l =" bl a c k " ,
| width=3)
187 | graphCanvas . c r e a t e _li n e ( 3 , 3 , 3 , 4 8 0 , f i l l =" bl a c k " , width
| =3)
188 | graphCanvas . c r e a t e _li n e ( 4 8 0 , 3 , 4 8 0 , 4 8 0 , f i l l =" bl a c k " ,
| width=3)
189 | graphCanvas . c r e a t e _li n e ( 5 5 0 , 3 2 , 7 4 0 , 3 2 , f i l l ="#b20000 " ,
| width=5)
190 | graphCanvas . c r e a t e _li n e ( 5 5 0 , 5 3 , 7 4 0 , 5 3 , f i l l ="#0069b5" ,
| width=5)
191 | graphCanvas . c r e a t e _li n e ( 5 5 0 , 7 3 , 7 4 0 , 7 3 , f i l l ="#8f 0 c a f " ,
| width=5)
192 | i f showGraphPositionX . g e t ( ) == 1 :
193 | graphCanvas . c r e a t e _li n e ( 3 , consigneX , 4 8 0 , consigneX ,
| f i l l ="#f f 7 7 7 7 " , width=2)
194 | i f showGraphPositionY . g e t ( ) == 1 :
195 | graphCanvas . c r e a t e _li n e ( 3 , consigneY , 4 8 0 , consigneY ,
| f i l l ="#6f 9 1 f 7 " , width=2)
196 | t += 3
197 | e l s e :
198 | graphWindow . withdraw ( )
199
200 | d e f r e f r e s hG r a p h ( ) :
201 | g l o b a l t
202 | t =480
203
204 | d e f endProgam ( ) :
205 | c on t r olle rWind ow . d e s t r o y ( )
206

83

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

84

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

85 prevBallPosY−ballPosY ) / 0. 0 3 3 3 ) 311
312 | Ix = round ( Ix / 1 0 0 0 0 , 4 )
313 | Iy = round ( Iy / 1 0 0 0 0 , 4 )
314
315 | i f Ix == 0 and Iy == 0 :
316 | alph a = 0
317 | be t a = 0
318
319 | e l i f Ix != 0 and s q r t ( Ix ∗∗2 + Iy ∗ ∗2 ) < 1 :
320 | be t a = atan ( Iy / Ix )
321 | alph a = a si n ( s q r t ( Ix ∗∗2 + Iy ∗ ∗2 ) )
322 | be t a = d e g r e e s ( be t a )
323 | alph a = d e g r e e s ( alph a )
324 | i f Ix < 0 and Iy >= 0 :
325 | be t a = abs ( be t a )
326 | e l i f Ix > 0 and Iy >= 0 :
327 | be t a = 180−abs ( be t a )
328 | e l i f Ix > 0 and Iy <= 0 :
329 | be t a = 180+abs ( be t a )
330 | e l i f Ix < 0 and Iy <= 0 :
331 | be t a = 360−abs ( be t a )
332
333 | e l i f Ix == 0 and s q r t ( Ix ∗∗2 + Iy ∗ ∗2 ) < 1 :
334 | i f Iy > 0 :
335 | be t a = 90
336 | alph a = a si n ( s q r t ( Ix ∗∗2 + Iy ∗ ∗2 ) )
337 | e l i f Iy < 0 :
338 | be t a = 270
339 | alph a = a si n ( s q r t ( Ix ∗∗2 + Iy ∗ ∗2 ) )
340 | alph a = d e g r e e s ( alph a )
341
342 | e l i f Ix != 0 and s q r t ( Ix ∗∗2 + Iy ∗ ∗2 ) > 1 :
343 | be t a = d e g r e e s ( atan ( Iy / Ix ) )
344 | alph a = 35
345 | i f Ix < 0 and Iy >= 0 :
346 | be t a = abs ( be t a )
347 | e l i f Ix > 0 and Iy >= 0 :
348 | be t a = 180−abs ( be t a )
349 | e l i f Ix > 0 and Iy <= 0 :
350 | be t a = 180+abs ( be t a )
351 | e l i f Ix < 0 and Iy <= 0 :
352 | be t a = 360−abs ( be t a )
353
354 | e l i f Ix == 0 and s q r t ( Ix ∗∗2 + Iy ∗ ∗2 ) > 1 :
355 | alph a = 35
356 | i f Iy > 0 :
357 | be t a = 90
358 | e l i f Iy < 0 :
359 | be t a = 270
360
361 | i f alph a > 3 5:
362 | alph a = 35
363
364 | alph a = prevAlpha ∗ omega + (1−omega ) ∗ alph a
365 | be t a = prevBeta ∗ omega + (1−omega ) ∗ be t a
366

86

367 | alph a = round ( round ( alph a / 0 . 2 ) ∗ 0 . 2 , −i n t ( f l o o r ( l o g 1 0 ( 0 . 2 ) ) )
) | ## permet d ’ a r r o n d i r e avec 0. 2 de p r e c i s i o n
368 | be t a = round ( round ( be t a / 0 . 2 ) ∗ 0 . 2 , −i n t ( f l o o r ( l o g 1 0 ( 0 . 2 ) ) ) )
369
370 | i f alph a <= 35 and be t a <= 360 and a rd ui n o I sC on ne c t ed == True
and s t a r t B al a n c e B all == True :
371 | s e r . w ri t e ( ( s t r ( d a t aDic t [ ( alpha , be t a ) ] )+"\n" ) . encode ( ) )
372
373 | #p r i n t ( alpha , be t a )
374 | p r i n t ( Ix , Iy , alpha , beta , ballPosX , ballPosY , prevBallPosX ,
prevBallPosY , sommeErreurX , sommeErreurY ) 375
376 | i f s t a r t B al a n c e B all == True :
377 | sommeErreurX += ( consigneX−ballPosX )
378 | sommeErreurY += ( consigneY−ballPosY )
379
380
381 | prevX , prevY = 0 , 0
382 | prevConsigneX , prevConsigneY = 0 , 0
383 | s t a r t_ time = 0
384 | d e f main ( ) :
385 | start_timeFPS = time . time ( )
386 | g l o b a l H, S ,V
387 | g l o b a l g e t Pi x el C ol o r
388 | g l o b a l x , y , alpha , be t a
389 | g l o b a l prevX , prevY , prevAlpha , prevBeta , prevConsigneX ,
prevConsigneY
390 | g l o b a l consigneX , consigneY , sommeErreurX , sommeErreurY
391 | g l o b a l camWidth , camHeight
392 | g l o b a l tim e I n t e r v al , s t a r t_ time
393 | g l o b a l showVideoWindow
394
395 | _, img=cam . re ad ( )
396 | img = img [ 0 : i n t ( camHeight ) , i n t ( ( camWidth−camHeight ) / 2 ) : i n t (
camWidth−((camWidth−camHeight ) / 2 ) ) ] #[Y1 :Y2 ,X1 :X2 ]
397 | im g Ci r cl e = np . z e r o s ( img . shape , dtype=np . ui n t 8 )
398 | cv2 . c i r c l e ( im gCi r cl e , ( 2 4 0 , 2 4 0 ) , 2 7 0 , ( 2 5 5 , 2 5 5 , 2 5 5 ) , −1, 8 ,
0 )
399 | img = img & im g Ci r cl e
400 | imgHSV = cv2 . c v tC ol o r ( img , cv2 .COLOR_BGR2HSV)
401
402 | i f g e t Pi x el C ol o r == True and mouseY > 0 and mouseY < 480 and
mouseX < 4 8 0:
403 | pi x elC ol o rO nCli c k = img [ mouseY , mouseX ]
404 | pi x elC ol o rO nCli c k = np . ui n t 8 ( [ [ pi x elC ol o rO nCli c k ] ] )
405 | pi x elC ol o rO nCli c k = cv2 . c v tC ol o r ( pi x elC ol o rO nCli c k , cv2 .
COLOR_BGR2HSV)
406 | H = pi x elC ol o rO nCli c k [ 0 , 0 , 0 ]
407 | S = pi x elC ol o rO nCli c k [ 0 , 0 , 1 ]
408 | V = pi x elC ol o rO nCli c k [ 0 , 0 , 2 ]
409 | p ri n t (mouseX , mouseY )
410 | g e t Pi x el C ol o r = F al s e
411
412 | lowerBound=np . a r r a y ( [ H−s li d e r H . g e t ( ) , S−s l i d e r S . g e t ( ) ,V−s li d e r V .
g e t ( ) ] )
413 | upperBound=np . a r r a y ( [H+s li d e r H . g e t ( ) , S+s l i d e r S . g e t ( ) ,V+s li d e r V .
g e t ( ) ] )

87

414
415 | mask=cv2 . inRange (imgHSV , lowerBound , upperBound )
416 | mask = cv2 . bl u r (mask , ( 6 , 6 ) ) | # a j o u t e du
| f l o u a l ’ image
417 | mask = cv2 . e r o d e (mask , None , i t e r a t i o n s =2) | # r e t i r e l e s
| p a r a s i t e s
418 | mask = cv2 . d i l a t e (mask , None , i t e r a t i o n s =2) | # r e t i r e l e s
| p a r a s i t e s
419
420 | c n t s = cv2 . fi n dC o n t o u r s (mask . copy ( ) , cv2 .RETR_EXTERNAL, cv2 .
| CHAIN_APPROX_SIMPLE)
421 | c n t s = c n t s [ 0 ] i f i m u t i l s . is_cv2 ( ) e l s e c n t s [ 1 ]
422 | c e n t e r = None
423
424 | cv2 . c i r c l e ( img , ( i n t ( consigneX ) , i n t ( consigneY ) ) , i n t ( 4 ) , ( 2 5 5 ,
| 0 , 0 ) , 2 )
425 | i f sh owC al queC alib r a ti o nB o ol == True :
426 | cv2 . c i r c l e ( img , ( 2 4 0 , 2 4 0 ) , 2 2 0 , ( 2 5 5 , 0 , 0 ) , 2 )
427 | cv2 . c i r c l e ( img , ( 2 4 0 , 2 4 0 ) , 1 6 0 , ( 2 5 5 , 0 , 0 ) , 2 )
428 | cv2 . l i n e ( img , ( 2 4 0 , 2 4 0 ) , ( 2 4 0 , 240+160) , ( 2 5 5 , 0 , 0 ) , 2 )
429 | cv2 . l i n e ( img , ( 2 4 0 , 2 4 0 ) , (240+138 , 240−80) , ( 2 5 5 , 0 , 0 ) , 2 )
430 | cv2 . l i n e ( img , ( 2 4 0 , 2 4 0 ) , (240 −138 , 240−80) , ( 2 5 5 , 0 , 0 ) , 2 )
431 | i f l e n ( c n t s ) > 0 :
432 | c = max( cn t s , key=cv2 . con tou rA rea )
433 | t i m e I n t e r v a l = time . time ( ) − s t a r t_ tim e
434 | ( x , y ) , r a di u s = cv2 . mi n E n cl o si n g Ci r cl e ( c )
435 | i f r a di u s > 1 0:
436 | cv2 . putText ( img , s t r ( i n t ( x ) ) + " ; " + s t r ( i n t ( y ) ) . format
| ( 0 , 0 ) , ( i n t ( x ) −50, i n t ( y ) −50) , cv2 .
FONT_HERSHEY_SIMPLEX, 1 , ( 2 5 5 , 2 5 5 , 2 5 5 ) , 2 )
437 | cv2 . c i r c l e ( img , ( i n t ( x ) , i n t ( y ) ) , i n t ( r a di u s ) , ( 0 , 2 5 5 ,
| 2 5 5 ) , 2 )
438 | P IDc on t r ol ( i n t ( x ) , i n t ( y ) , prevX , prevY , consigneX ,
| consigneY )
439 | s t a r t_ time = time . time ( )
440 | e l s e :
441 | sommeErreurX , sommeErreurY = 0 , 0
442
443
444 | i f showVideoWindow == True :
445 | img = cv2 . c v tC ol o r ( img , cv2 .COLOR_BGR2RGB)
446 | img = Image . f r om a r r a y ( img )
447 | imgtk = ImageTk . PhotoImage ( image=img )
448 | lmain . imgtk = imgtk
449 | lmain . c o n f i g u r e ( image=imgtk )
450 | lmain . a f t e r ( 5 , main )
451
452 | drawWithBall ( )
453 | i f prevConsigneX != consigneX o r prevConsigneY != consigneY :
454 | sommeErreurX , sommeErreurY = 0 , 0
455
456 | paintGraph ( )
457 | prevX , prevY = i n t ( x ) , i n t ( y )
458 | prevConsigneX , prevConsigneY = consigneX , consigneY
459 | prevAlpha = alph a
460 | prevBeta = be t a
461

88

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

89 h o r i z o n t a l " , l a b e l="P" , l e n g t h =350, t i c k i n t e r v a l = 3 , r e s o l u t i o n =0.01)
503 | sli d e r C o e f P . s e t ( sli d e r C o e f P D e f a ul t )
504 | sli d e r C o e f P . pack ( )
505 | s l i d e r C o e f I = tk . S c al e ( FramePIDCoef , from_=0, t o =1, o r i e n t="
| h o r i z o n t a l " , l a b e l=" I " , l e n g t h =350, t i c k i n t e r v a l = 0 . 2 ,
| r e s o l u t i o n =0.001)
506 | s l i d e r C o e f I . s e t ( s l i d e r C o e f I D e f a u l t )
507 | s l i d e r C o e f I . pack ( )
508 | sli d e r C o e f D = tk . S c al e ( FramePIDCoef , from_=0, t o =10, o r i e n t="
| h o r i z o n t a l " , l a b e l="D" , l e n g t h =350, t i c k i n t e r v a l = 2 ,
| r e s o l u t i o n =0.01)
509 | sli d e r C o e f D . s e t ( sli d e r C o e f D D e f a ul t )
510 | sli d e r C o e f D . pack ( )
511
512
513 | F rameBallCon t rol = tk . LabelFrame ( con t rolle rWindow , t e x t=" B i l l e ␣
| c o n t r o l e " )
514 | F rameBallCon t rol . pl a c e ( x=420,y=315, width =380, h ei g h t= 1 3 2 )
515 | Bb allD r awCi rcle = tk . Button ( FrameBallControl , t e x t=" F ai r e ␣ t o u r n e r ␣
| l a ␣ b i l l e ␣en␣ c e r c l e " , command=s t a r tD r a w Ci r cl e )
516 | Bb allD r awCi rcle . pack ( )
517 | BballDrawEight = tk . Button ( FrameBallControl , t e x t=" F ai r e ␣ t o u r n e r ␣ l a
| ␣ b i l l e ␣en␣ h ui t " , command=s t a r tD r awEi gh t )
518 | BballDrawEight . pack ( )
519
520
521
522
523 | l a b e l = tk . Label ( con t rolle rWindow , t e x t="Arduino ␣ d e c o n n e c t e ␣␣" , f g=
| " red " , anchor="ne" )
524 | l a b e l . pack ( f i l l ="both" )
525 | BReset = tk . Button ( con t rolle rWindow , t e x t = " Re se t " , command =
| r e s e t S l i d e r )
526 | BReset . pl a c e ( x=20, y=460)
527 | BConnect = tk . Button ( con t rolle rWindow , t e x t = "Connexion" , command
| = connectArduino , background=" bl a c k " )
528 | BConnect . pl a c e ( x=100, y=460)
529 | BQuit = tk . Button ( con t rolle rWindow , t e x t = " Q ui t t e r " , command =
| endProgam )
530 | BQuit . pl a c e ( x=730, y=460)
531
532
533 | showGraphPositionX = tk . IntVar ( )
534 | showGraphPositionX . s e t ( 1 )
535 | CheckbuttonPositionX = tk . Checkbutton ( graphWindow , t e x t=" P o si ti o n ␣
| en␣X" , v a r i a b l e=showGraphPositionX , command=r e f r e s hG r a p h )
536 | CheckbuttonPositionX . pl a c e ( x=500,y=20)
537 | showGraphPositionY = tk . IntVar ( )
538 | showGraphPositionY . s e t ( 1 )
539 | CheckbuttonPositionY = tk . Checkbutton ( graphWindow , t e x t=" P o si ti o n ␣
| en␣Y" , v a r i a b l e=showGraphPositionY , command=r e f r e s hG r a p h )
540 | CheckbuttonPositionY . pl a c e ( x=500,y=40)
541 | showGraphAlpha = tk . IntVar ( )
542 | CheckbuttonAlpha = tk . Checkbutton ( graphWindow , t e x t=" I n c l i n a i s o n ␣du
| ␣ pl a t e a u " , v a r i a b l e=showGraphAlpha , command=r e f r e s hG r a p h )
543 | CheckbuttonAlpha . pl a c e ( x=500,y=60)

90

544
545
546
547 | videoWindow . p r o t o c ol ( "WM_DELETE_WINDOW" , d on o thin g )
548 | videoWindow . bind ( "<Button−2>" , g e tM o u s eCli c k P o si ti o n )
549 | videoWindow . bind ( "<Button−1>" , setConsigneWithMouse )
550
551 | main ( )
552 | tk . mainloop ( )

91

G arduinoCode.ino

1 #include <Servo.h>
2
3 | Servo servoA;
4 | Servo servoB;
5 | Servo servoC;
6
7 | int ledTemoin = 8;
8 | float angleA = 5;
9 | float angleB = 5;
10 | float angleC = 5;
11
12 | void setup() {
13 | Serial.begin(19200);
14 | pinMode(ledTemoin, OUTPUT); // led temoin
15 | digitalWrite(ledTemoin,HIGH);
16 | servoA.attach(9); | //servo A
17 | servoB.attach(11); | //servo B
18 | servoC.attach(10); | //servo C
19 | delay(1000);
20 | servoA.writeMicroseconds((-2165+1260)*float(angleA)/90
| + 2165);
21 | servoB.writeMicroseconds((-1975+1130)*float(angleB)/90
| + 1975);
22 | servoC.writeMicroseconds((-1990+1130)*float(angleC)/90
| + 1990);
23 | }
24
25 int count = 0;
26
27 | void loop() {
28 | digitalWrite(ledTemoin , millis() / 500 % 2 ); // led
temoin clignotement
29
30 | if(Serial.available() > 0) {
31 | String a = Serial.readStringUntil(’\n’);
32 | if(a == "descendreBras"){
33 | angleA = 5;
34 | angleB = 5;
35 | angleC = 5;
36 | }else{
37 | a.remove(0,1);
38 | a.remove(a.length() - 1,1);
39 | angleA = getValue(a, ’,’, 0).toFloat();

92

40 | angleB = getValue(a, ’,’, 1).toFloat();
41 | angleC = getValue(a, ’,’, 2).toFloat();
42 | }
43 | servoA.writeMicroseconds((-2165+1260)*float(angleA)
| /90 + 2165);
44 | servoB.writeMicroseconds((-1975+1130)*float(angleB)
| /90 + 1975);
45 | servoC.writeMicroseconds((-1990+1130)*float(angleC)
| /90 + 1990);
46 | }
47
48 }
49
50 | //La fonction ci-dessous a ete trouvee telle quelle sur:
| https://stackoverflow.com/questions/29671455/how-to-
| split-a-string-using-a-specific-delimiter-in-arduino
51 | String getValue(String data, char separator, int index) {
52 | int found = 0;
53 | int strIndex[] = { 0, -1 };
54 | int maxIndex = data.length() - 1;
55
56 | for (int i = 0; i <= maxIndex && found <= index; i++)
| {
57 | if (data.charAt(i) == separator || i == maxIndex)
| {
58 | found++;
59 | strIndex[0] = strIndex[1] + 1;
60 | strIndex[1] = (i == maxIndex) ? i+1 : i;
61 | }
62 | }
63 | return found > index ? data.substring(strIndex[0],
| strIndex[1]) : "";
64 | }

93

### H Détermination des angles

### θ des servomoteurs

Vecteur ~v :

cosβsinα

sinβsinα
cosα

⊥

π

Plan du plateau (

π) : cosβsinαx

+ sinβsinαy

+ cosαz

+

d = 0

Plan vertical contenant le bras du moteur A (planA) :

0

0

1

∧

−cos(30)

−sin(30)

0

=

sin(30)

−cos(30)

0

⇒ sin(30)

x

− cos(30)

y = 0

Plan vertical contenant le bras du moteur B (planB) :

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
- ⇒ −

x = 0

Plan vertical contenant le bras du moteur C (planC ) :

0

0

1

∧

cos(30)

−sin(30)

0

=

sin(30)
cos(30)

0

⇒ sin(30)

x

+ cos(30)

y = 0

Vecteur ~a se trouvant sur la droite planA

∩

π) :

cosβsinα

sinβsinα
cosα

∧

sin(30)

−cos(30)

0

=

cosαcos(30)

cosαsin(30)

−cos(30)cosβsinα

− sinβsinαsin(30)

Vecteur

### ~b se trouvant sur la droite planB

∩

π) :

cosβsinα

sinβsinα
cosα

∧

−1
0

0

=

0

−cosα

sinβsinα

Vecteur ~c se trouvant sur la droite planC

∩

π) :

cosβsinα

sinβsinα
cosα

∧

sin(30)
cos(30)

0

=

−cosαcos(30)
cosαsin(30)

cos(30)cosβsinα

− sinβsinαsin(30)

94 d est la hauteur du plateau au-dessus des moteurs lorsque le plateau est à plat.

Point A, position de l’extrémité du bras du moteur A : A = 00d + k cosαcos(30) cosαsin(30) −cos(30)cosβsinα − sinβsinαsin(30) = Xa Ya Za

Point B, position de l’extrémité du bras du moteur B : B = 00d + m 0 −cosα sinβsinα ) = Xb Yb Zb

Point C, position de l’extrémité du bras du moteur C : C = 00d + t −cosαcos(30) cosαsin(30) cos(30)cosβsinα − sinβsinαsin(30) = Xc Yc Zc

−−→AB

= D ⇒

# −−→OB − −→OA

= D =

0 −mcosα msinβsinα + d ) − kcosαcos(30) kcosαsin(30) −kcos(30)cosβsinα − ksinβsinαsin(30) + d

−−→BC

= D ⇒

# −−→OC − −−→OB

= D =

−tcosαcos(30) tcosαsin(30) tcosβsinαcos(30) − tsinβsinαsin(30) + d − 0 −mcosα msinβsinα + d )

−→CA

= D ⇒

# −→OA − −−→OC

= D =

kcosαcos(30) kcosαsin(30) −kcos(30)cosβsinα − ksinβsinαsin(30) + d − −tcosαcos(30) tcosαsin(30) tcosβsinαcos(30) − tsinβsinαsin(30) + d

(−kcosαcos(30))2 + (−mcosα − kcosαsin(30))2 + (msinβsinα + d + kcos(30)cosβsinα + ksinβsinαsin(30) − d)2 = D2 (−tcosαcos(30))2 + (tcosαsin(30) + mcosα)2 + (tcosβsinαcos(30) − tsinβsinαsin(30) + d − msinβsinα − d)2 = D2 (kcosαcos(30) + tcosαcos(30))2 + (kcosαsin(30) − tcosαsin(30))2 + (−kcos(30)cosβsinα − ksinβsinαsin(30) + d − tcosβsinαcos(30) +tsinβsinαsin(30) − d)2 = D2

95

Point I, emplacement de l’articulation du bras d’un moteur : I(L−rcosθ; rsinθ) Point P, emplacement de l’extrémité du bras d’un moteur : P(

q
X²

p + Y ²
p

;Zp)

−→P I
= l

−→P I =

L − rcosθ

rsinθ
−

q
X²

p + Y ²
p
Zp

!

(L − rcosθ −

q
X²

p + Y ²
p

)

2 + (rsinθ − Zp)

2 = l

2

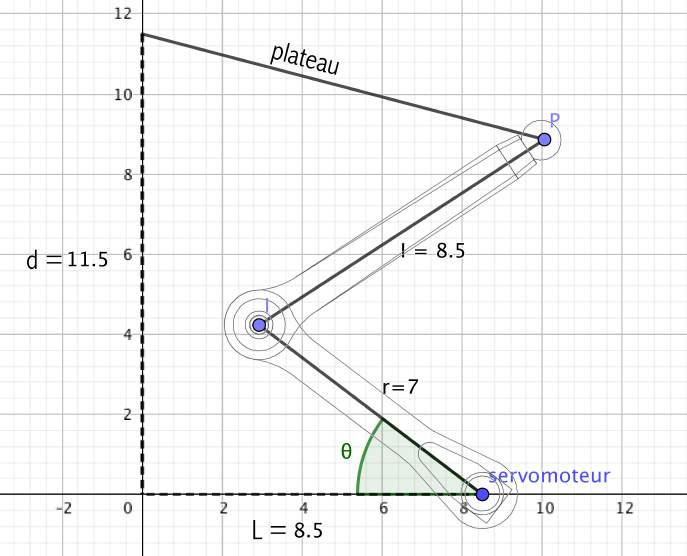
[picture p65: figure]

96

I Quelques plans du projet

97

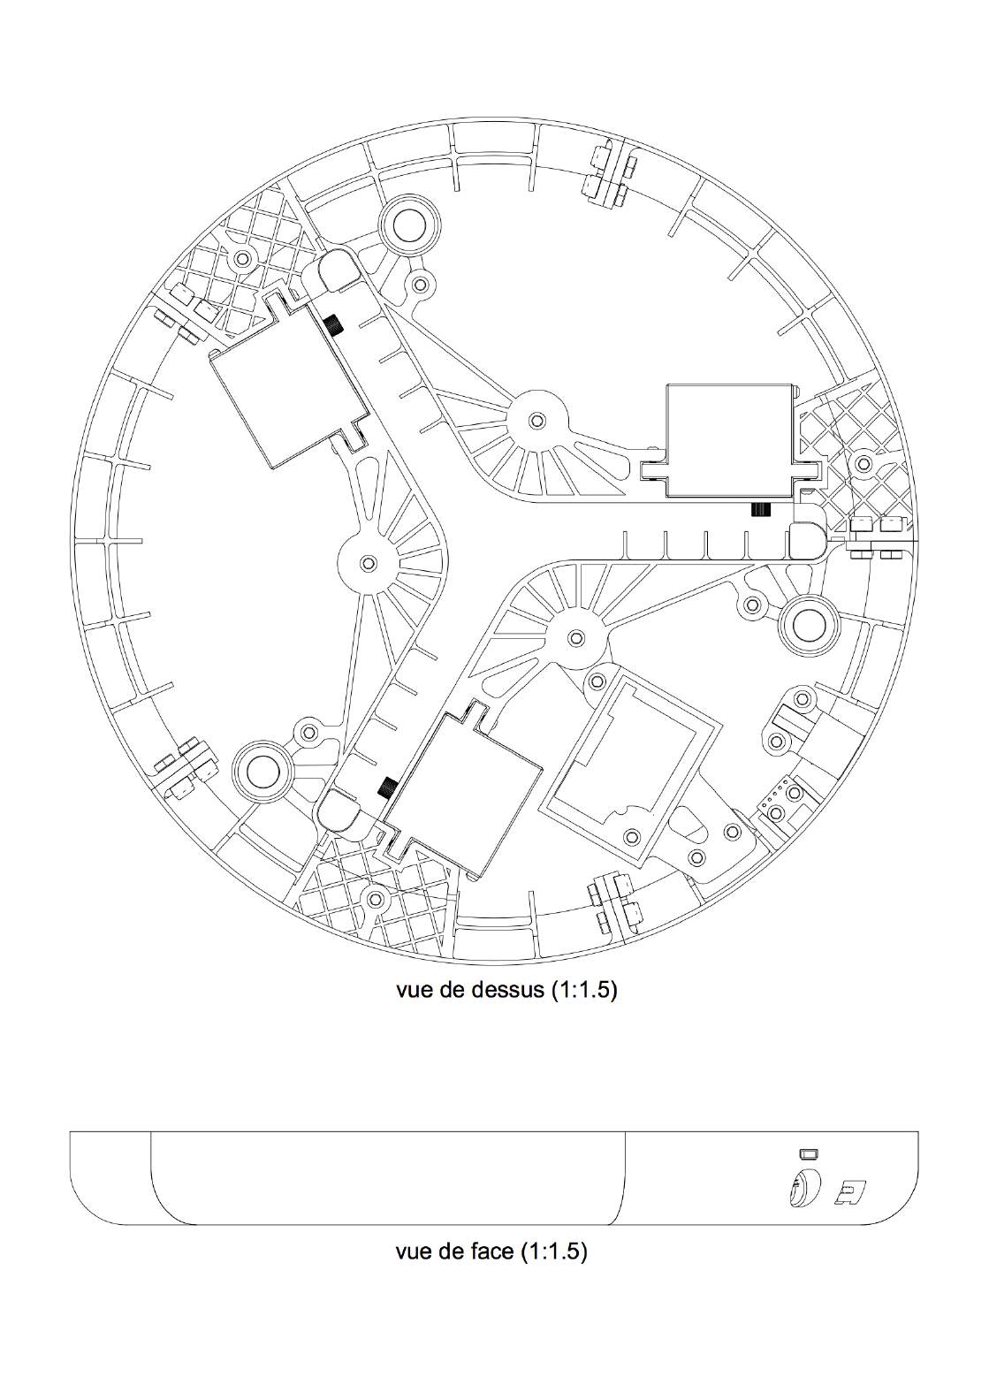
[picture p66: page 100]
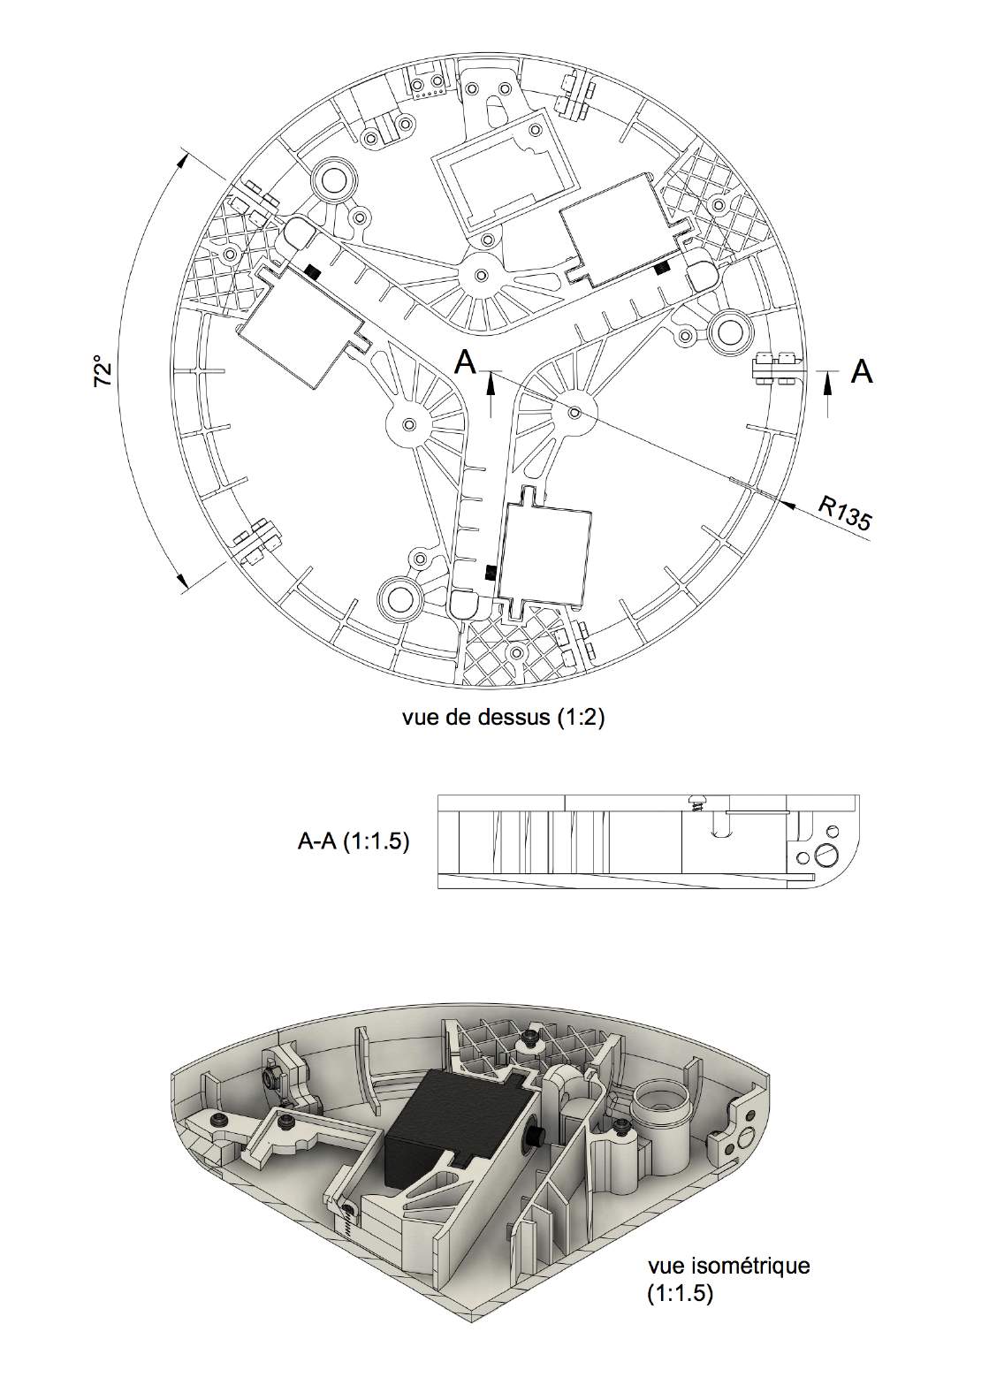
[picture p67: page 101]
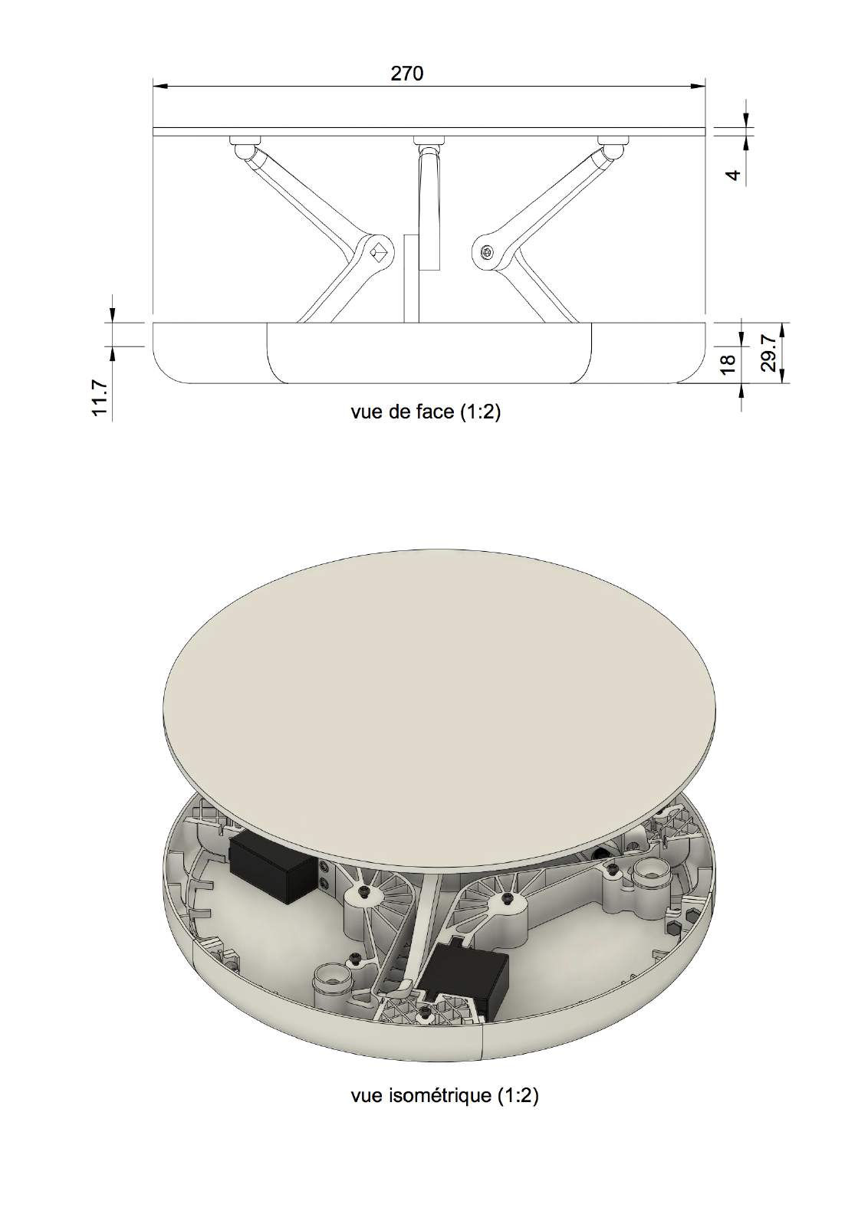
[picture p68: page 102]
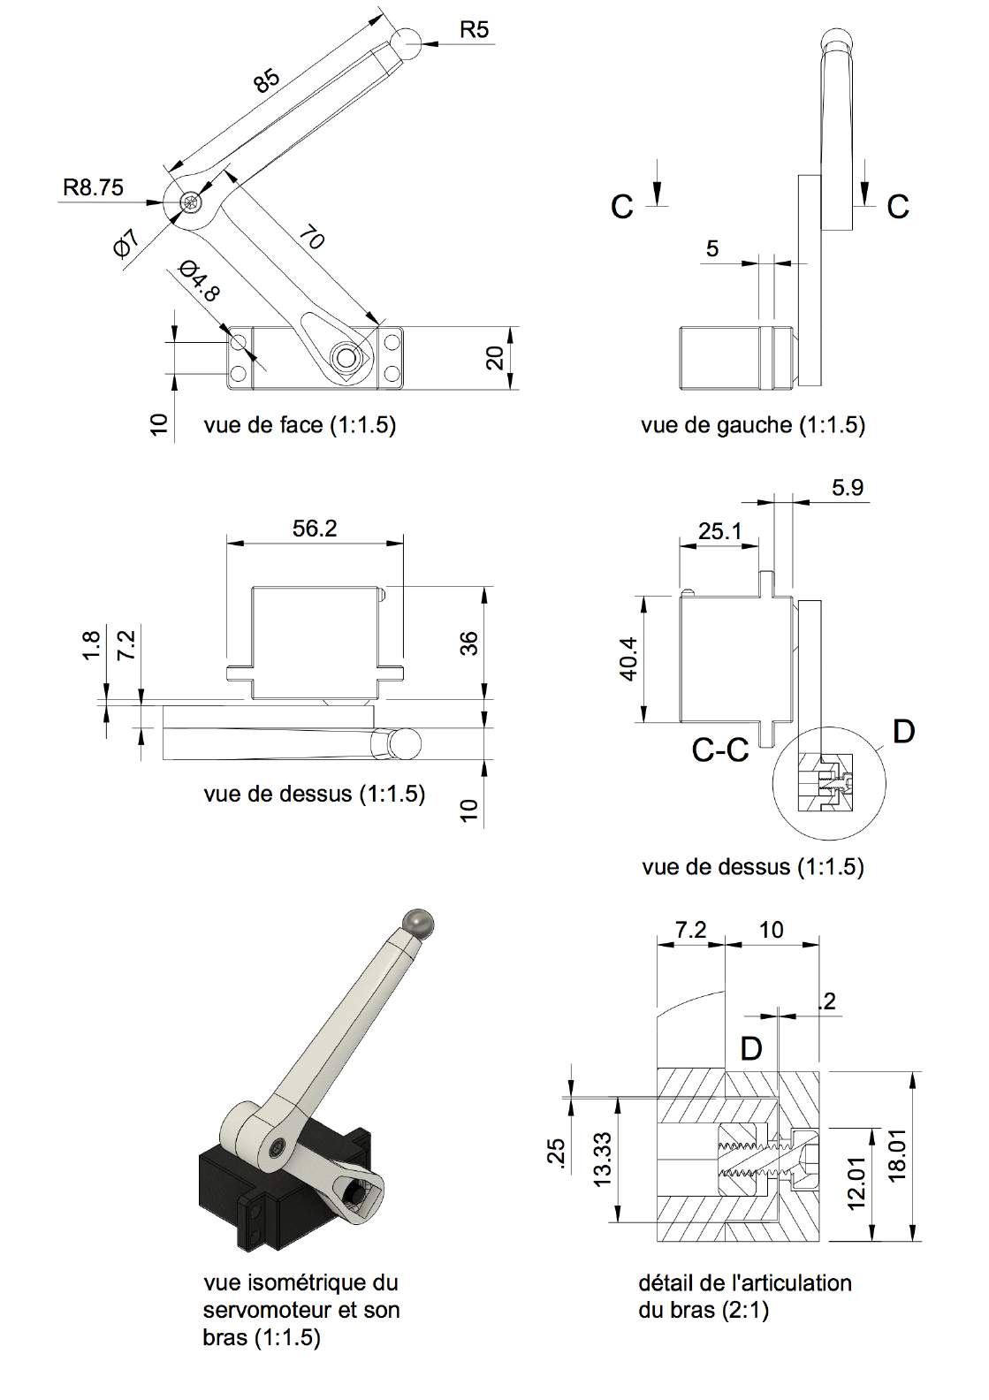
[picture p69: page 103]
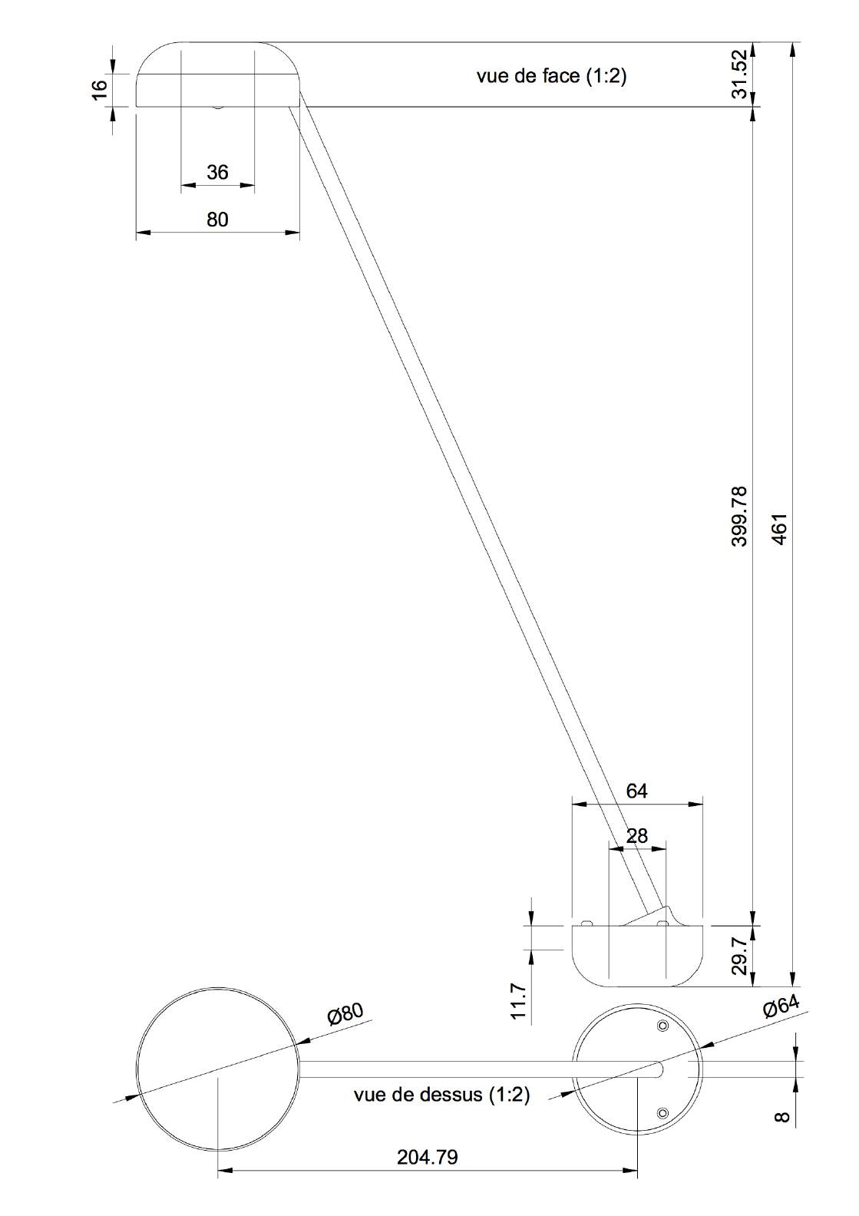
[picture p70: page 104]
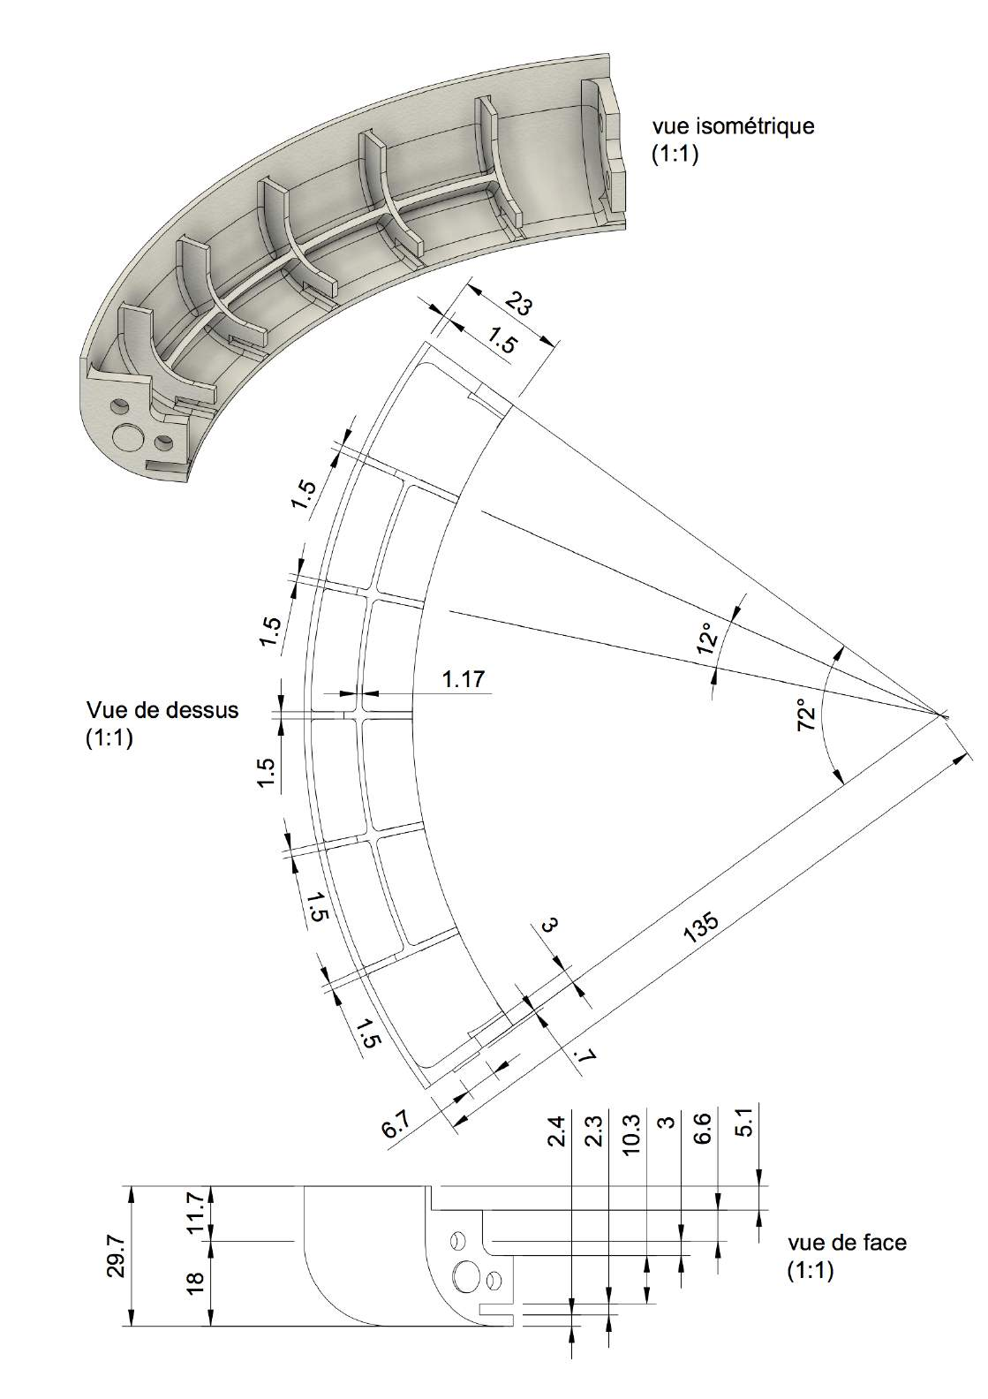
[picture p71: page 105]

J Prototypes

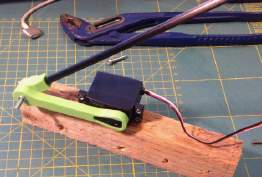
[picture p72: figure]

## mars avril mai juin

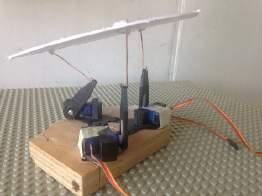
[picture p73: figure]
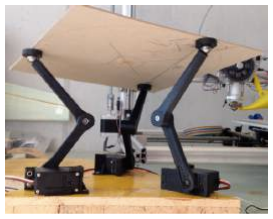
[picture p74: figure]
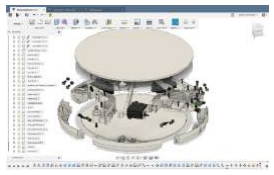
[picture p75: figure]

104

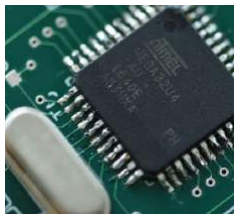
[picture p76: figure]
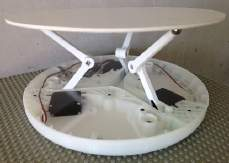
[picture p77: figure]

K Quelques esquisses du projet

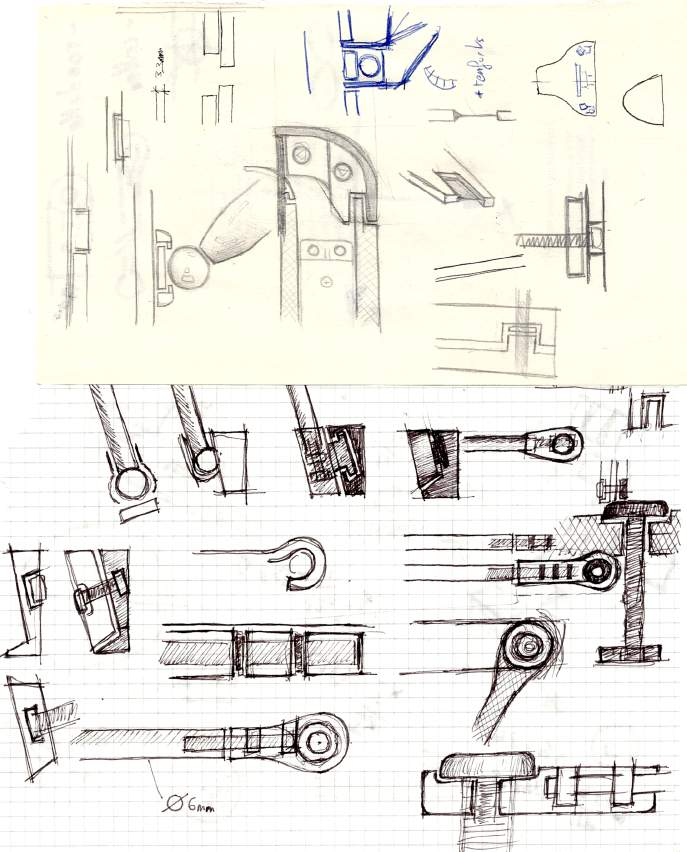
[picture p78: figure]

105

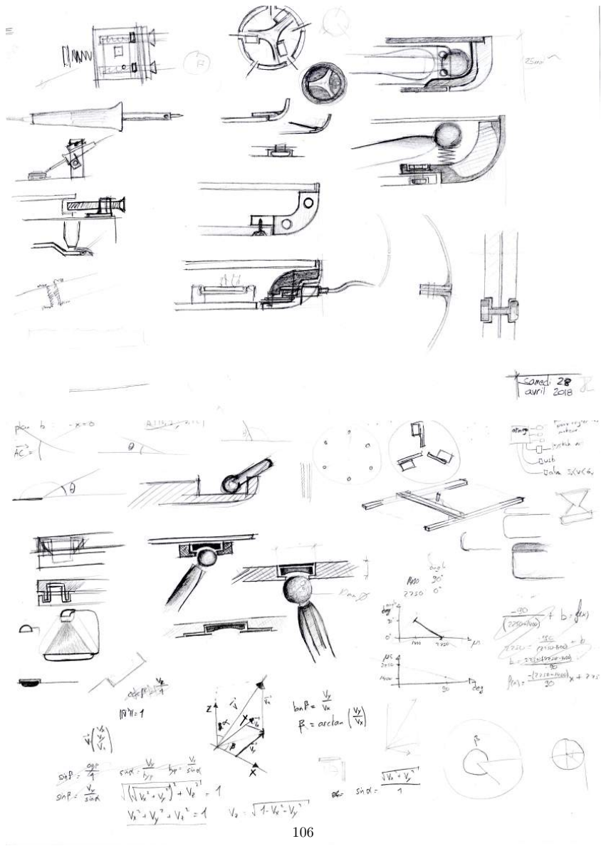
[picture p79: page 108]

106
