JohanLink/Ball-Balancing-PID-System/images/DSC_5144.JPG

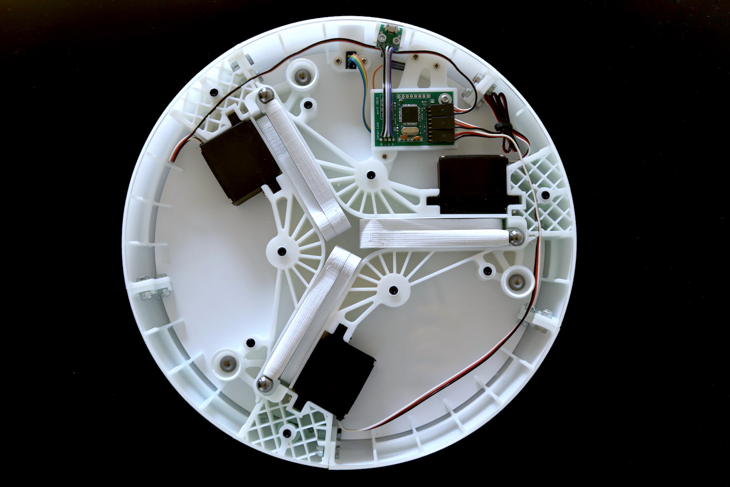
images/DSC_5144.JPG
