JohanLink/Ball-Balancing-PID-System/(threads)

Thread 2 (2021-02-05):

Help offered

FilipMalczak, 2021-02-05:
Hi man,

Great work with this stuff. I wanted to find your email address, but couldn't it in the repo, hence an issue here.

I've glimpsed through your code and I can only assume you glued it together to get the job done quickly. If that wasn't the case and you'd like help with python programming and maybe refactoring this so it could be sellable, let me know. I wouldn't expect payment, though getting mentioned now and then could be nice. Still, however I can help, I'd just like this thing to take off.

caesarh287, 2021-02-05:
oh im sorry i didnt mean to take your code, ill take it off, i only wanted
to follow the repo cause its interesting.

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

FilipMalczak, 2021-02-08:
@caesarh287 I was offering the author ( @JohanLink ) help with code sanitization. Not sure what you mean.
